sequoia-hope/simple-earring/out/probe/cu_c19.png

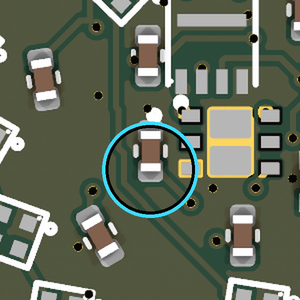
out/probe/cu_c19.png
