sequoia-hope/simple-earring/out/probe/cu_c16.png

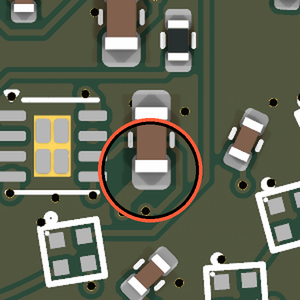
out/probe/cu_c16.png
