sequoia-hope/simple-earring/README.md

# simple_earring

Co-designed LED earring: a Ø30.5 mm teardrop, 4-layer board with an RP2350A and external QSPI
flash in the middle and 45 RGB LEDs on two rings round it (37 on the outer ring, 8 inside). It runs
from a small LiPo cell (LPR302823) on the back and charges over USB-C. One button does both power
(a soft latch) and BOOTSEL. There is also an IMU, an ambient light sensor and a generated TPU clip-on
case. JLCPCB rules, all parts from LCSC.

The current board (rev 3, variant A) uses 45 WS2816C-1313 addressable pixels split into three
switched zones. Variants B–F study a cheaper build that drives plain RGB LEDs (XL-1615) from a
matrix driver (AW20198QNR), about $3 less per board. It routes on 6 layers; 4 layers is down to a few
open connections.

**Project page: <https://sequoia-hope.github.io/simple-earring/>**: every design variant (A, the
routed WS2816C board, and the B–F matrix-driver study) with board previews, a comparison table, the
interactive viewer (schematic, PCB layers, 3D) and the design notes. It is the local dashboard
(`proj up simple_earring`), published with `scripts/publish_pages.py --push`.

The design is *generated*: edit `design.yaml` (shape, LED count, sizes) and
`scripts/circuit.py` (netlist), then rebuild.

**Status:** rev 1 (SK6805-EC10 LEDs, 2032 coin cell) was ordered, assembled and works. It lives in a
separate worktree at `~/pcb/simple_earring_shipped` (commit `43eadc1`). This tree is rev 3: variant A
is routed with ultraroute to 0 DRC errors / 0 unconnected and has passed gate 7. The matrix variants
are placed; the 4- or 6-layer decision for them is open. See `docs/PLAN.md` for the plan of record
and the project page's feed for the narrative.

## Pipeline

```
python3 build.py                # full: board -> place -> route -> drc -> render -> export
python3 build.py --to place     # stop after a stage (board|place|route|drc|render|export)
```

Stages (each is also runnable standalone from `scripts/`):

| stage  | script | what it does |
|---|---|---|
| board  | `gen_board.py` | netlist from `circuit.py` -> fresh 4-layer .kicad_pcb, outline, nets |
| place  | `place.py` | LED ring, MCU cluster front, holder back, USB at edge |
| route  | `route.py` | locked pre-routes + pours, then ultraroute for the rest, zone fills |
| drc | `drc.py` | kicad-cli DRC, parsed pass/fail report |
| render | `render.py` | renders, layer PNGs, GLB, and the `out/` dashboard  |
| export | `export.py` | JLCPCB gerbers/drill + BOM/CPL from LCSC numbers |

The KiCad project is `hw/earring/a/earring.kicad_*` (the Boardroom suite's
`hw/<board>/<variant>/` layout; `scripts/paths.py` owns the locations). Build products
land in `out/` (renders, dashboard, `drc.json`, `production/`, `jlcpcb/`).

The dashboard's design gallery reads `design/variants.toml` (card text) and `pcbview.toml` (the
boards); rebuild the viewer with `scripts/view.sh build pcbview.toml`, rewrite the page with
`python3 scripts/render.py --index-only`, then publish it to GitHub Pages (the `gh-pages` branch)
with `python3 scripts/publish_pages.py --push`.

## Boardroom suite

This is a Boardroom project (`~/Software/easy_pcb`): `design/status.json` is its
headline state, `.claude/skills/pcb-design/` the vendored skill, `pcbview.toml` the
viewer config. `compose/earring/` is Circuit Composer's view of the circuit
(generated by `scripts/export_compose.py`, build stage `compose`), and
`route/earring/recipe.json` is the ultraroute recipe behind the installed route.
Routing is ultraroute: the `route` stage runs the pinned `vendor/ultraroute`
(`git submodule update --init`; `scripts/route.sh` builds it, needs Rust) with that recipe.
Alongside the board pipeline: `gen_schematic.py` (readable schematic + PDF),
`gen_case.py` (TPU case STLs/STEP), `firmware/` (PlatformIO, arduino-pico), and
`tools/` (bench instruments — charge monitor, placement spot scanner).

## Dashboard

```
cd out && python3 -m http.server 8618 --bind 0.0.0.0
```

`out/index.html` is a reverse-chronological update feed over the live build
outputs: renders, the copper-layer stack viewer, the 3D board, the schematic,
the case preview and the bench pages. It is **generated by `scripts/render.py`**
(the `FEED` list at the top of that file) — hand edits to the served page are
wiped by the next build. `python3 scripts/render.py --index-only` rewrites just
the page.

## Sources of truth

- `design.yaml` — geometry + rules parameters
- `scripts/circuit.py` — components and nets (references `bom/parts.yaml`)
- `bom/parts.yaml` — every part with LCSC number + footprint
- `library/parts.pretty/` — local footprints (proven ones lifted from prior boards)
- `docs/PLAN.md` — plan of record: current state, open work, hard-won constraints

## Provenance

Footprints and circuit patterns reuse the proven `earring` (RP2040 + LGS4056H + USB-C)
and `rp2350-pendant` (RP2350 QFN-60, 1010 LED ring) projects.
