sequoia-hope/simple-earring/design/ultraroute-requests.md

# ultraroute change requests

Router problems found on this board, for the ultraroute project to fix. Per the skill's
LESSONS, the fix belongs in the router, not in a workaround script here.

## 1. Overlap-only track joints (2026-10-31, gate 7)

**Seen in:** ultraroute 8c691ec (lab), `~/Software/ultraroute-lab/experiments/vled-width-1/s0`.
The pinned `vendor/ultraroute` 0330831 is not yet checked.

**What:** the output has 81 joints where two tracks of a net don't share an endpoint. Their
ends sit 0.05–0.28 mm apart (often exactly one 0.1 mm grid step diagonally: 0.141 mm), and
the copper connects only where the round ends overlap. The input board has none:

    tools/route_audit/necks.py …/s0/input.kicad_pcb   -> 0 overlap-only joints
    tools/route_audit/necks.py …/s0/out.kicad_pcb     -> 81 overlap-only joints

KiCad counts these as connected, and the default DRC passes them. With a `connection_width
(min 0.09mm)` rule, KiCad reports necks down to 0.051 mm. Two are the only battery path
(VBATT In2 at (98.68,88.08) and (107.3,108.35)) and one is CHRG's only path (F.Cu at
(101.33,110.83)).

**Ask:** every track joint the router writes should be a shared endpoint (or a T onto a
segment's centreline), never an end-cap overlap. A self-check before writing would help:
no joint narrower than the net's width rule.

**Status (2026-11-01):** still present: the installed board still has 81. Not fixed on
ultraroute origin/main as of cc6be09 (b5f9f2d's 0.5 µm reach-in rule still accepts these
joints). Sent to the ultraroute session (ultraroute-e8), along with a second ask: fail the run when
any joint is narrower than the net's width rule, so this can't be reported as success again.

**Fixed** in ultraroute 0b9016f (2026-11-01) for track-to-track joints. Re-routed here: VBATT
and CHRG are clean.

## 2. Track-to-pad joints narrower than the fab minimum (2026-11-01, gate 7 re-route)

**Seen in:** pinned 0b9016f, build route stage. KiCad `connection_width (min 0.09mm)`:
- U8.5 3V3 B.Cu: 0.066 mm. The pad's only track ends just outside it at (103.675,93.162).
- U6.5 3V3 B.Cu: 0.053 mm. A track end at (109.65,88.55), ~0.08 mm off the pad's edge.
- U6.2 3V3 B.Cu: 0.043 mm, from a 0.02 mm track at (107.84,89.13–89.15).

**Ask:** a track that ends on a pad ends inside the pad's copper, so the joint is at least the
track's width (or the net's minimum). Report any narrower pad joint, as 0b9016f does for track
joints. Sent to the ultraroute session 2026-11-01.

**Fixed** in ultraroute 5064384 (2026-11-01). Re-routed here: no pad joint under 0.09 mm.

## 3. Via hole-clearance margin, and touching same-net via pairs (2026-11-02)

**Seen in:** pinned 5064384, build route stage, with the new `.kicad_dru` rule "No via hole in
SMD pad" (`physical_hole_clearance (min 0.1mm)` between vias and SMD pads). 0 via holes touch
SMD pads (124 before) and 0 unconnected, but KiCad reports:
- hole_clearance **0.0995 mm**, 0.5 µm short: the GND via at (94.4,96.28) against Q5.2.
- connection_width **0.029 mm** (B.Cu and In1.Cu): VLED_C vias at (93.43,108.38) and
  (93.78,108.58), 0.403 mm apart, whose 0.4 mm lands only just touch.

**Ask:** keep a margin on rule checks (or round toward legal). Same-net vias should either
clear each other or join at least the net's width, and preferably not be doubled. Sent to the
ultraroute session 2026-11-02.

**Fixed** on ultraroute main: hole clearance in 4ed8d5d, touching vias in fe903ff. But see #4:
the fe903ff route has new failures, so we stay pinned to 5064384.

## 4. fe903ff routes this board worse than 5064384 (2026-11-02)

**Seen in:** fe903ff, with the same recipe and the same route.py input as the 1f12b22 route.
- At `--timeout 240`, it hit the deadline in shove/nudge. 4 unconnected: BTN_SENSE (U1-33) and
  LIGHT (U1-40), plus the gnd sliver islands. Shove pass 1 ran from 51 s to 211 s; on 5064384
  the whole route took ~150 s.
- At `--timeout 480`, it still hit the deadline, with 3 unconnected.
- New track_width error: a VBUS B.Cu track 0.09 mm wide, 0.667 mm long, into J1-A4B9, where
  the floor is 0.2 mm ("narrowed ... no way at its own"). On 5064384 this net routed at the
  full width.
- negotiated: 235 of 249 connections, against 239 of 248 on 5064384. The router sees one more
  connection.

The touching-via and hole-clearance errors are gone on fe903ff.

**Ask:** bisect 5064384..fe903ff on this board. The input is copied to
`~/Software/ultraroute-lab/repro/earring-fe903ff/`. Also noted: `add_block.py` lists the block's
zones in a different order from run to run. Sent to the ultraroute session 2026-11-02; they are
bisecting.

**Bisect (ultraroute, 2026-11-02):**
- The unconnected nets start at 4ed8d5d, which made hole clearance exact. 5064384 had passed
  1–2 hole_clearance errors on every seed. Seed 0 is unlucky: seeds 1–3 reach 0 unconnected.
- The 0.09 mm VBUS neck was a router bug. When the write stage mended a pad joint, it applied our
  board-wide 0.09 connection_width rule in place of the net's 0.2 floor. Fixed on
  fix/joint-floor 20062d9, not yet merged.
- With that fix, seed 1 gave 0 errors apart from our gnd sliver.
- The zone-order variation was in route.py: KiCad UUIDs weren't seeded. Fixed here in eee01cd.
  Seeded input sent as `repro/earring-seeded/` for a seed sweep.

**Fixed** in ultraroute 99bb7ca (joint floor) on 2026-11-02. On the seeded input, ultraroute
swept seeds 0–3; seed 1 was the cleanest. Re-routed here on 99bb7ca with seed 1: 0 unconnected,
no VBUS neck, 1 DRC error, which is our gnd_front fill sliver.
