sequoia-hope/simple-earring/design/gates/phase0.md

# Gate 0 — design intent

- [x] `design/intent.md` written. Every requirement has a number or an explicit "don't care".
- [x] **User sign-off: 2026-10-22**, via AskUserQuestion: "Approved — proceed". Cell LPR302823, solder pads, replace on main, R8 18k.
- Post-sign-off correction (same day): the coin-cell stack is ~3.8 mm, not 5.3. Recorded in intent.md, and the brief carries the height trade-off back to the user.
- Independent review: not run separately. The stronger-model brief review (gate 4) receives intent.md too.
