sequoia-hope/simple-earring/design/datasheets/sources.csv

file | source
is31fl3741a.pdf | C2940604
xl-1010rgb-yg.pdf | C965834
aw20198qnr.pdf | C5137654
xl-1615rgbc-rf.pdf | C965840
