sequoia-hope/simple-earring/design/renders/3d-bottom.png

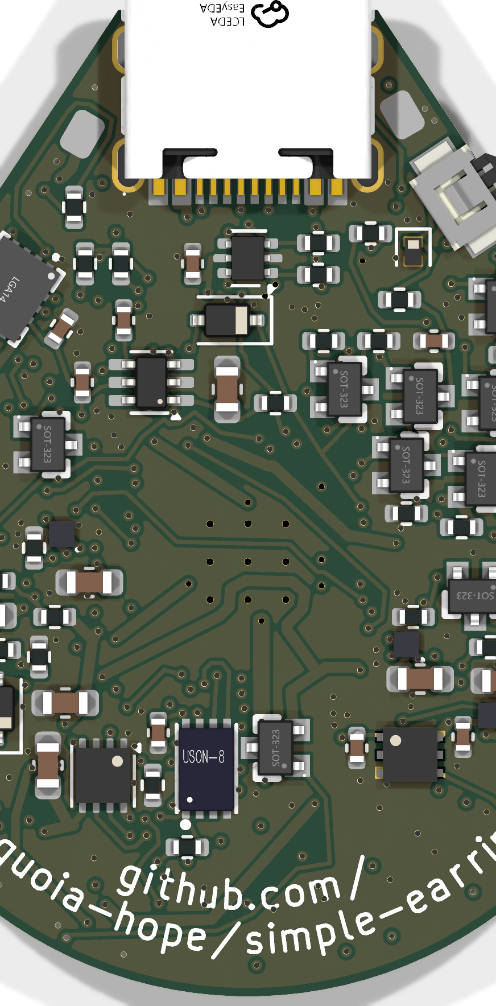
design/renders/3d-bottom.png
