sequoia-hope/simple-earring/design/renders/3d-top.png

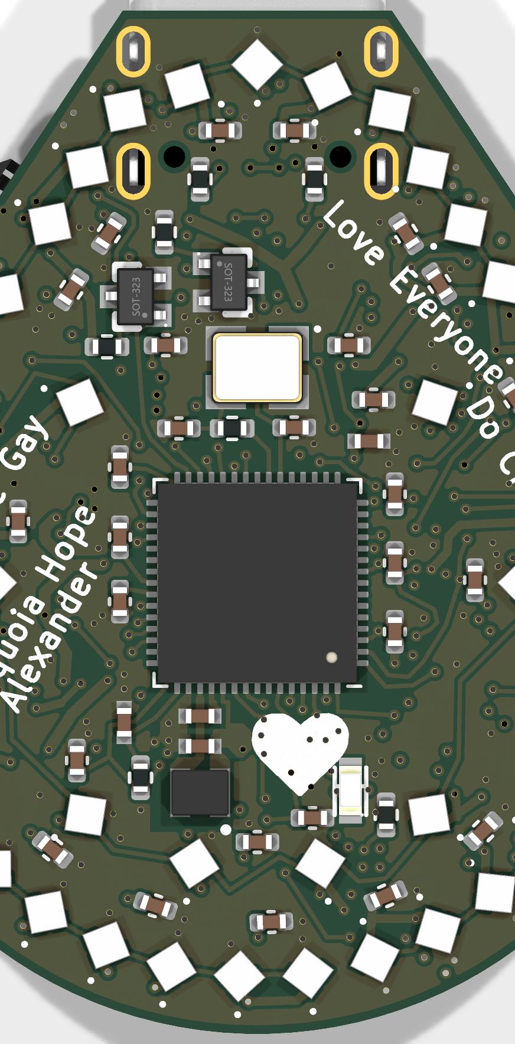
design/renders/3d-top.png
