sequoia-hope/simple-earring/design/renders/B.Cu.png

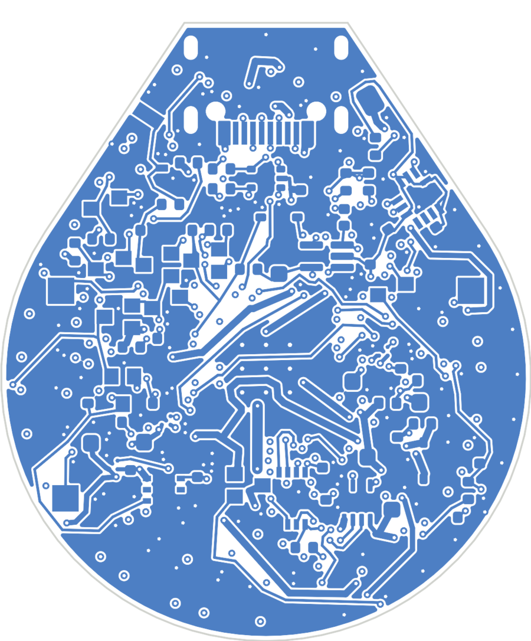
design/renders/B.Cu.png
