sequoia-hope/simple-earring/design/renders/bottom.png

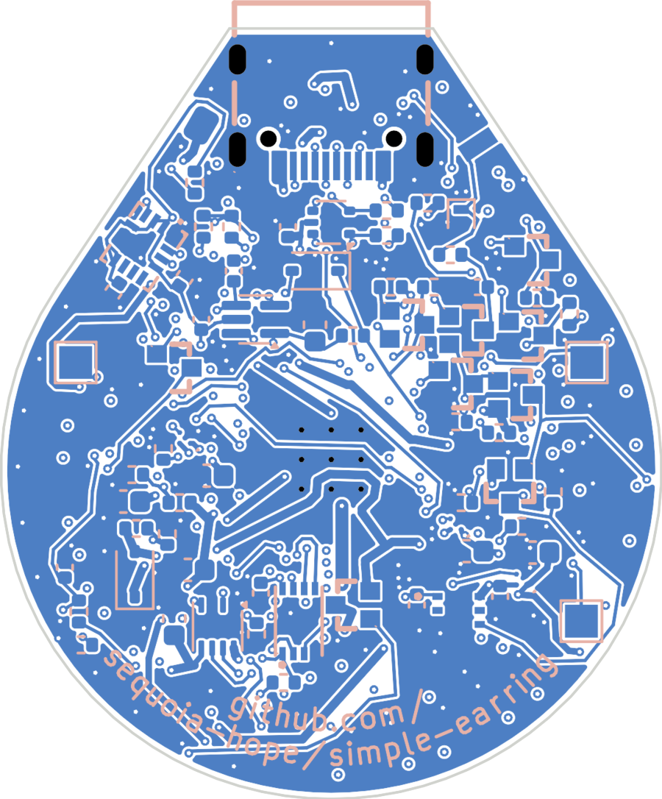
design/renders/bottom.png
