sequoia-hope/simple-earring/design/renders/F.Cu.png

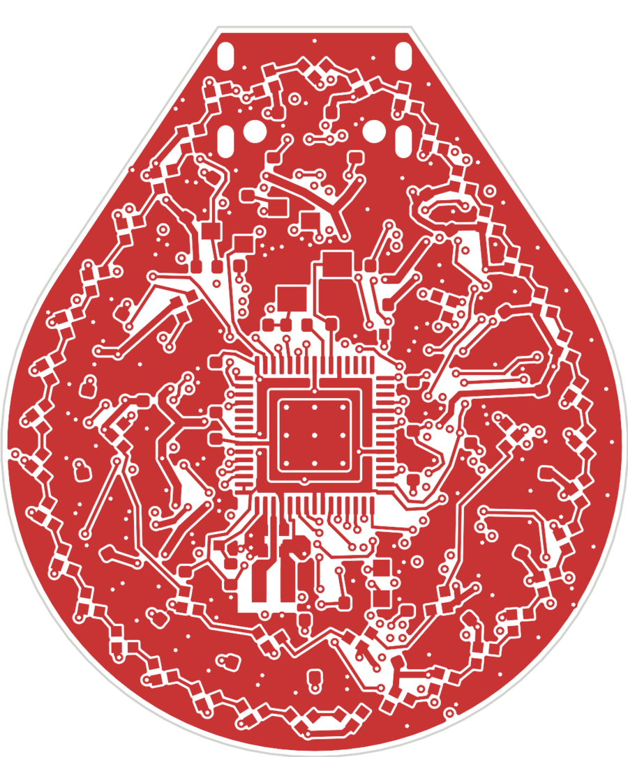
design/renders/F.Cu.png
