sequoia-hope/simple-earring/design/renders/In1.Cu.png

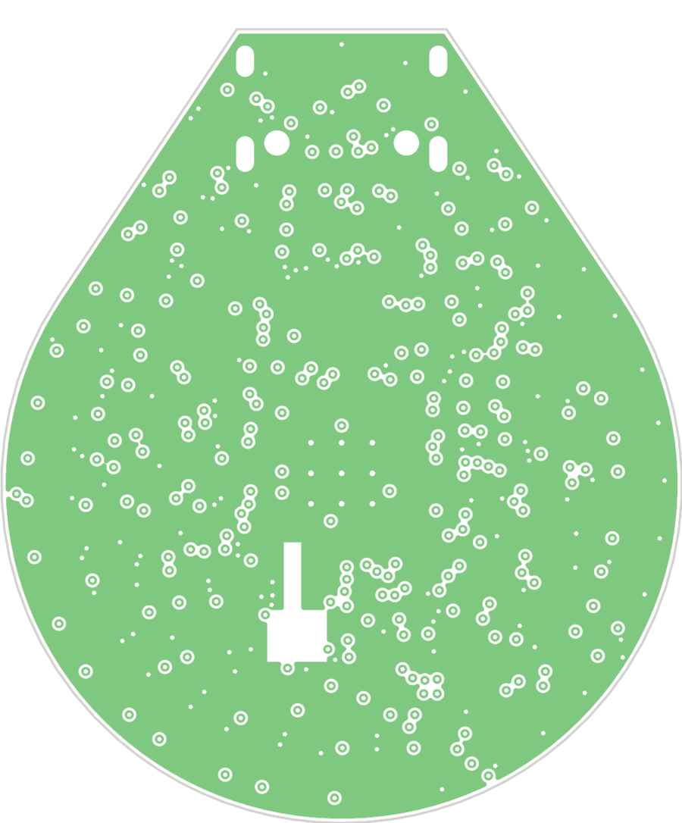
design/renders/In1.Cu.png
