sequoia-hope/simple-earring/design/renders/In2.Cu.png

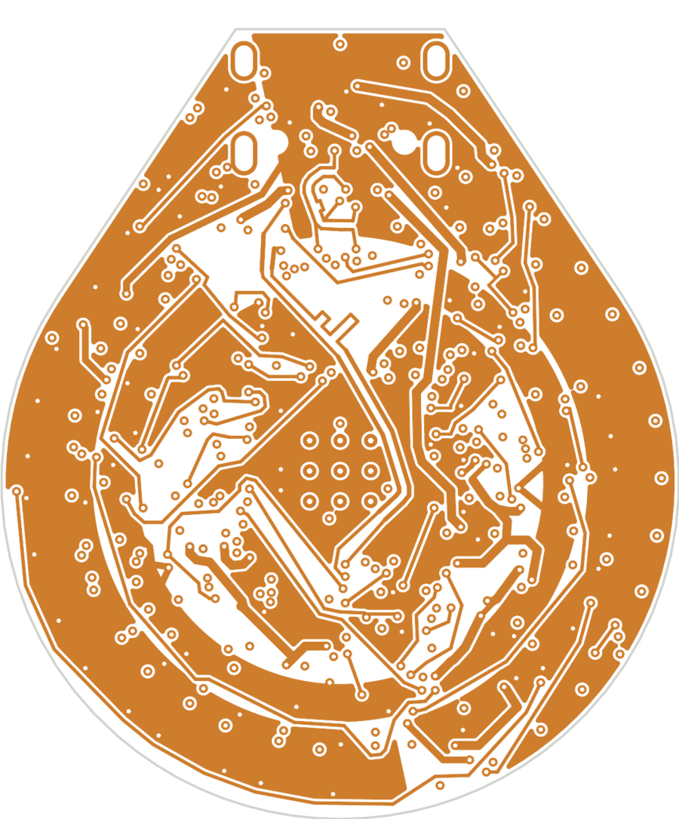
design/renders/In2.Cu.png
