sequoia-hope/simple-earring/design/renders/top.png

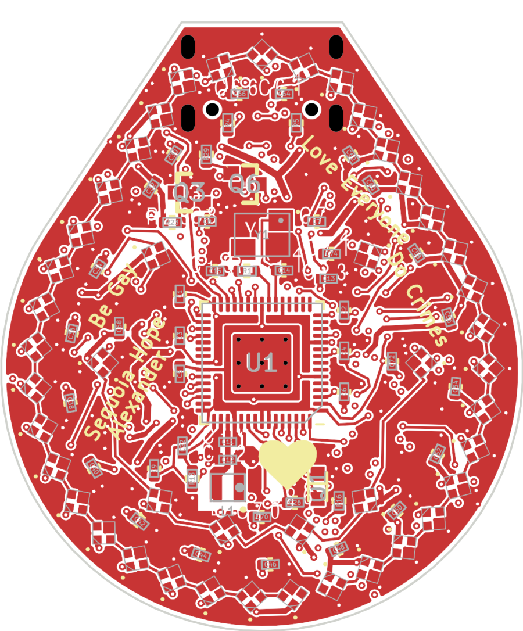
design/renders/top.png
