sequoia-hope/simple-earring/out/probe/board_back.png

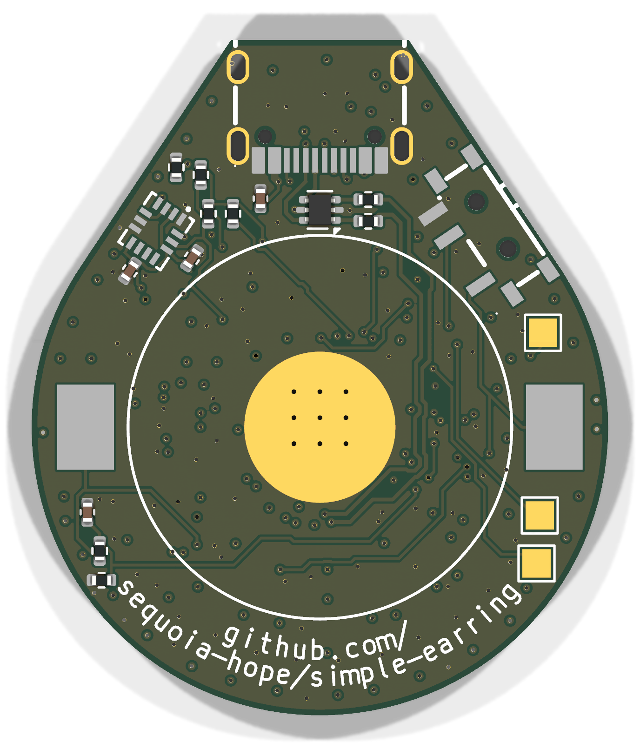
out/probe/board_back.png
