sequoia-hope/simple-earring/out/probe/cu_c17.png

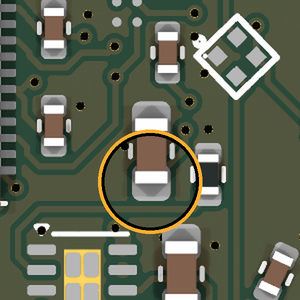
out/probe/cu_c17.png
