sequoia-hope/simple-earring/out/probe/cu_l1.png

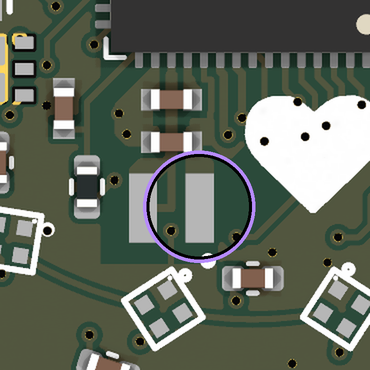
out/probe/cu_l1.png
