sequoia-hope/simple-earring/out/probe/cu_usb.png

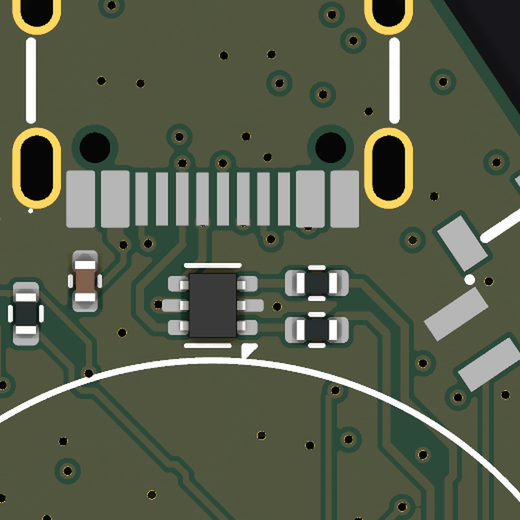
out/probe/cu_usb.png
