sequoia-hope/simple-earring/design/parts/aw20198qnr.md

# U11: Awinic AW20198QNR 18 × 11 matrix LED driver (variant C)

**Datasheet:** `design/datasheets/aw20198qnr.pdf` (Awinic, V1.3 Oct 2020, 40 pages; copied from round-pendant, LCSC
C5137654). Read: pp. 1–3 (features, application circuit, pinout), 6–8 (abs max, electrical), 10–12 (modes, I²C,
addresses), 15–21 (detection, LED map, scan timing, duty and current formula, de-ghost), 24–25 (GCR, DGCR), 35
(application and layout), 37–38 (package, land pattern). Pages 2, 37 and 38 were also read as images.
**MPN:** AW20198QNR
**Supplier:** `C5137654 AW20198QNR (AWINIC(Shanghai Awinic Tech), QFN-40L(5x5)): extended, JLC stock 6055, lifecycle normal, checked 2026-11-05`
(~$0.78–0.89 at 10+, per round-pendant's 2026-11-05 cost run. That's ~$2.4 less than the IS31FL3741A's $3.31.)
**Why this part:** the user's call (2026-11-05). It's round-pendant's driver for its low-density parallelogram boards
(`~/pcb/round-pendant/design/parts/drivers-aw20198.md`). There `p1-66` routed 100 % on 4 layers with one of these.
**Footprint:** `library/parts.pretty/QFN-40-1EP_5x5mm_P0.4mm_EP3.4x3.4mm`, written from p.38. It is not round-pendant's,
whose pads were 0.60 mm long.
- 40 × 0.50 × 0.20 mm pads at 0.40 mm pitch, 5.20 mm outer span (centres ±2.35), so 0.20 mm between pads.
- Pad 41 is a solid 3.40 mm exposed pad (GND), with a 2 × 2 paste grid of 1.3 mm windows (58 %).
- The package is 5.00 ± 0.10 × 0.55 ± 0.05 mm (p.37), so 0.40 mm EP-to-pad gaps on the land.
- Pin 1 at the top-left of the west row, counter-clockwise (p.2 top view). This matches `circuit.py` AW_SW_PIN / AW_CS_PIN.

## Pin map (p.2–3), and how variant C uses it

| Pins | Name | Net |
|---|---|---|
| 1–4, 6–10 | SW8, SW6, SW4, SW2 / SW1, SW3, SW5, SW7, SW9 | SW1–SW9 (the ring bus) |
| 11, 40 | SW11, SW10 | NC (SWSEL scans SW1–9 only) |
| 5 | PVCC | VSYS |
| 22 | VCC | VSYS (ds note 2: PVCC and VCC on the same supply) |
| 39–31 | CS1–CS9 | CS1–CS9 |
| 21–17, 15 | CS10–CS14, CS15 | CS10–CS15 |
| 14, 13, 12 | CS16–CS18 | NC (growth: one more 3-LED triplet each per SW) |
| 16, 23, 41 | PGND, GND, EP | GND |
| 24, 25 | AD1, AD0 | GND → address **0x20** (p.12) |
| 26 | EN | DRV_EN, GPIO18; 100 nF to GND |
| 27, 28 | SCL, SDA | DRV_SCL GPIO17, DRV_SDA GPIO16 (I²C0) |
| 29 | ISET | R35 to GND |
| 30 | SYNC | NC (1 MΩ internal pull-down, p.3) |

There is no INTB pin, so GPIO1 (LED_EN_L in variant A) comes free. That leaves three spare GPIOs in all.

## Absolute max vs our worst case (p.6–7)

| Parameter | Abs max / rating | Our worst case | Margin |
|---|---|---|---|
| VCC, PVCC | −0.3…6 V (op 2.7–5.5 V) | VSYS ≤ 4.95 V on USB (VBUS − D3), 3.0–4.2 V on the cell | OK |
| SCL, SDA, EN, AD0/1 | −0.3…VCC | 3V3 comes from an LDO fed by VSYS, so it's always ≤ VSYS | OK by construction |
| CS1–18 | −0.3…VCC; SW −0.3…PVCC | Both supplies are VSYS | OK |
| ISET | −0.3…2 V | Internal | OK |
| Sink current | IMAX 40 mA at REXT 10 k | 8.51 mA (REXT 47 k) | 4.7× |
| Switch current | 720 mA at 10 k (SDCR 000) | 15 CS × 8.51 = 128 mA per SW slot | 5.6× |
| Junction temp | 160 °C max; TSD 165 °C | See thermal, below | OK |

## Current setting, R35 = 47 kΩ 1 % (C25792, basic, already on the BOM for B)

The current formula is ILED = (400 V / REXT) × (GCC/255) × (SL/255) × (PWM/256) × DUTY (p.18).

- **Peak:** Imax = 400 / 47 k = **8.51 mA** per die. That's B's 8.09 mA, within 5 %, so the firmware's levels carry over.
- **Duty:** SWSEL = 1000 scans SW1–SW9 (p.24 GCR). Each slot is 0.25 + 5 × 0.125 + 16 + 0.125 + 1 = 18.0 µs, with 15.94 µs
  of PWM. So DUTY = 15.94 / 18.0 / 9 = **0.0984**. That checks against p.18's own 11-SW example, 0.0805.
- **Average at full scale:** 8.51 × 0.0984 = **0.837 mA** per die.
- **Full white, hardware cap:** 135 dies × 0.837 = **113 mA**, or ~128 mA with the rest of the system. That's under the
  cell's 140 mA, even with a firmware bug. It's B's argument for 47 k, and it still holds.
- **The red trade-off.** The XL-1615's red is weak at low current (see `xl-1615rgbc.md`). So **dim with PWM and keep SL
  and GCC high**: the instantaneous current then stays near 8.5 mA, where red still works. Dimming with GCC or SL instead
  lowers the instantaneous current itself.
  - A lower REXT would buy red headroom: 39 k gives 10.3 mA peak and 136 mA full white. That is over the cell's budget once
    the MCU is counted, so this audit keeps 47 k. The user can trade this.
- **Recommended config:** p.16 gives GCC 0x05–0x80 and PWM ≥ 0x20 at PVCC 4.2 V. That is for open/short detection
  accuracy only, not a limit.

## Headroom (LED lights only if VSYS ≥ VF + VHR_SW + VHR_CS)

- **Headroom ratings:** VHR_CS is 300 mV at 40 mA and VHR_SW is 750 mV at 720 mA (p.7). At 8.5 mA and 128 mA they scale
  to roughly 0.07 V and 0.13 V.
- **VF:** green and blue are ~2.75 V at 8.5 mA (XL-1615 p.6 curve), with the 3.4 V max bin at 20 mA.
- **Floor:** a straight scaling gives G/B a floor of VSYS ≥ ~2.95 V. The review (m1) points out that sink compliance does
  not scale linearly: the real floor is ≈ 3.05 V typical, and 3.25–3.4 V for top-VF bins. So the **firmware's
  low-battery colour floor should be ≥ 3.3 V**. The SW bus's IR drop eats into this too, which makes it a gate 7 check.

## Supply and power

- **Quiescent:** **1.8 mA** active with all LEDs off (p.7), against the IS31FL3741A's 3.6 mA. That's ~1.8 mA off every
  awake mode in variant B's battery table.
- **Standby:** 1.3 µA with EN low or CHIPEN = 0, registers kept. The 1 MΩ EN pull-down holds it there when the MCU is
  off. VSYS is not cut by the soft latch, so this is the earring's "off" draw from this part: >10 years from 140 mAh.
  The IS31 needed an external 100 k pull-down (R36). This one doesn't, so R36 is gone.
- **Low-power mode:** MIXCR.LPEN = 1 drops into low-power mode automatically whenever every PWM is 0 (p.10–11). Firmware
  should set it.
- **Thermal, worst case:** full white on USB, VSYS 4.95 V.
  - Dissipation is 0.837 mA × (45 × (4.95 − 1.95) + 90 × (4.95 − 2.75)) = 279 mW, plus 9 mW quiescent.
  - At θJA 33 °C/W that is **+9.5 °C**. The board is smaller than JEDEC's, so call it +20 °C. Fine.

## Required external parts (Figure 1, p.2; p.35)

| Ref | Part | Where (place.py MATRIX_AW, back) | Datasheet |
|---|---|---|---|
| C81 / C80 | 100 nF / 1 µF on PVCC | West of pin 5, 1.15 / 2.3 mm | C2 / C1 |
| C83 / C82 | 100 nF / 1 µF on VCC | East of pin 22, 1.15 / 2.1 mm | C4 / C3 |
| C86 | 10 µF 0603 bulk on VSYS | South of the chip | (extra, as B). Review m4: it derates to ~5 µF against 128 mA, 16 µs slot pulses; 22 µF 0805 would be better. Open: needs a sourced part and a spot |
| R35 | 47 kΩ REXT | East of pin 29, 1.15 mm | R3 (10 k in the figure) |
| C87 | 100 nF on EN | East of pin 26 | C5 (1 µF in the figure; 100 n is plenty against a push-pull GPIO) |
| R38 / R39 | 4.7 kΩ I²C pull-ups to 3V3 | East | R1/R2: p.11 recommends 4.7 k for 400 kHz, 1 k for 1 MHz |

- **No series LED resistors (RLED).** The figure's RLED only moves heat out of the chip at 5 V and 40 mA. At 8.5 mA it
  has no job.
- **Layout (p.35):** caps and REXT as close as possible. The EP needs as many thermal vias as possible. That is a gate 7
  item, as in B, and via-in-pad is the user's call.

## De-ghost and LED reverse voltage (p.20–21)

- **How it works:** the CS pull-ups (0.5–32 kΩ) and SW pull-downs (0.25–16 kΩ) are selected in DGCR. They act during the
  off/blanking time.
  With the default PUMD = PDMD = 0 they act only then.
- **Reverse bias:** an unlit LED can see up to ~VSYS reverse: 4.95 V on USB against the XL-1615's 5 V VR. That's inside
  the rating but thin, and limited to µA-level current by the pull resistors. The same holds for the IS31 in B.
- **Firmware:** CSPUR = 000 (CS pull-up off) removes the reverse bias entirely. Otherwise, pick the largest DGCR resistances
  that still kill ghosting.
- **Actual USB VSYS:** D3 is a 1N4007WS silicon diode, so the real figure is below the 4.95 V assumed here. That figure is
  kept as the worst case.

## Firmware notes (review, 2026-11-05)

- **Start-up:** wait 2 ms after power-on and 100 µs after EN before the first I²C write. UVLO and over-temperature both
  clear CHIPEN, so re-enable it after either.
- **Logic level:** GCR.LGC = 1 (2.4 / 0.6 V) gives the 3.3 V I/O more noise margin than the default.
- **Audible noise:** the scan-frame current envelope (~6.2 kHz) sits next to the ear and can make MLCCs sing. Enable spread
  spectrum and slew-rate control.
- **Register indexing:** the LED register index runs SWn × 18 + CS. CS16–18 are unused, so the index skips them.

## Open questions

- IMAX accuracy at 47 kΩ: only 10 k and 5 k are characterised.
- The red LED's low-current efficiency (`xl-1615rgbc.md`).
- How many EP vias, and whether via-in-pad is allowed (gate 7).
- Independent review: `design/gates/phase1-variant-c-review.md`, PASS WITH FIXES (2026-11-05). m1–m3 and m5 are folded in
  above. m4 (bulk cap) is open.
