sequoia-hope/simple-earring/out/production/bom.csv

Designator | Footprint | Quantity | Value | LCSC Part #
BT1 | BAT_CR2032_W | 1 | LIR2032 | C70373
C1, C2, C21, C23, C24, C25, C28, C3, C30, C32, C34, C36, C38, C4, C40, C42, C44, C46, C48, C5, C50, C52, C54, C56, C58, C6, C60, C62, C64, C66, C68, C7, C70, C72, C74, C8, C9 | 0402 | 37 | 100n | C1525
C11, C12, C13, C22 | 0402 | 4 | 4.7u | C23733
C14, C15 | 0402 | 2 | 15p | C1548
C16, C17, C20 | 0603 | 3 | 10u | C19702
C18, C19 | 0402 | 2 | 1u | C52923
J1 | USB-C_SMD-TYPE-C-31-M-12_1 | 1 | USB-C | C165948
L1 | L_pol_2016 | 1 | 3.3uH | C42411119
LED1, LED10, LED11, LED12, LED13, LED14, LED15, LED16, LED17, LED18, LED19, LED2, LED20, LED21, LED22, LED23, LED24, LED25, LED26, LED27, LED28, LED29, LED3, LED30, LED31, LED32, LED33, LED34, LED35, LED36, LED37, LED38, LED39, LED4, LED40, LED41, LED42, LED43, LED44, LED45, LED5, LED6, LED7, LED8, LED9 | LED_SK6805-EC10 | 45 | SK6805-EC10 | C22394946
R1, R3 | 0402 | 2 | 1k | C11702
R10, R2 | 0402 | 2 | 10k | C25744
R11, R12 | 0402 | 2 | 1M | C26083
R13 | 0402 | 1 | 33 | C25105
R14, R15 | 0402 | 2 | 4.7k | C105871
R4, R5 | 0402 | 2 | 5.1k | C25905
R6, R7 | 0402 | 2 | 27 | C138021
R8 | 0402 | 1 | 22k | C25768
SW1 | KEY-SMD_4P-L4.2-W3.2-P2.20-LS4.6 | 1 | BOOTSEL | C19724063
SW2 | SW-TH_MSK12C02 | 1 | PWR | C431540
U1 | RP2350-QFN-60-1EP_7x7_P0.4mm_EP3.4x3.4mm_ThermalVias | 1 | RP2350A | C42411118
U2 | DFN-8-1EP_2x2mm_P0.5mm_EP0.9x1.5mm | 1 | LGS4056H | C5124109
U3 | WDFN-6-2x2 | 1 | NCP730-3.3 | C892821
U4 | YZV0004ADAD | 1 | TPS22913 | C544698
U5 | SOT-666 | 1 | USBLC6-2P6 | C2827693
U6 | LGA-14_L3.0-W2.5-P0.50-TL | 1 | LSM6DS3TR-C | C967633
U7 | USON-8_L3.0-W2.0-P0.50-BL-EP | 1 | W25Q16JVUXIQ | C2843335
Y1 | Crystal_SMD_3225-4Pin_3.2x2.5mm_ABM8 | 1 | 12MHz | C20625731
