sequoia-hope/simple-earring/design/renders/assembly-top.pdf

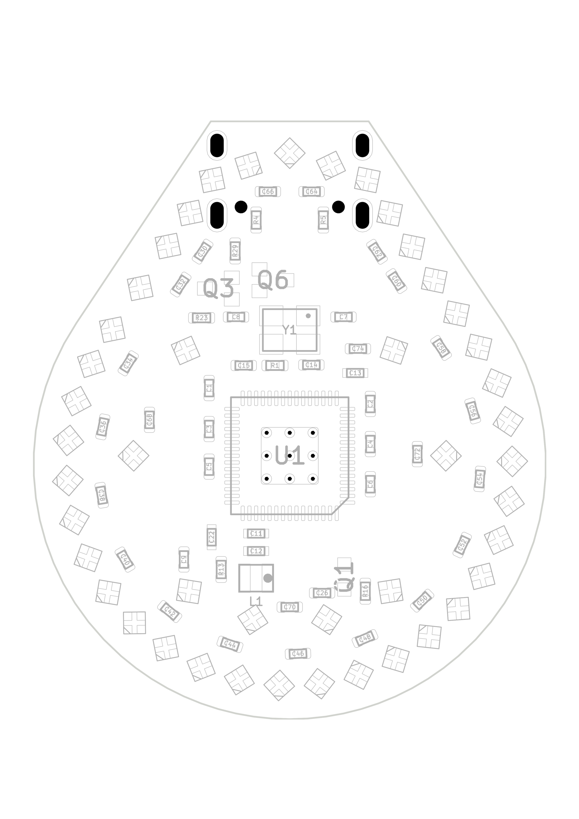
[picture p15: page 1]
