sequoia-hope/simple-earring/design/renders/assembly-top.png

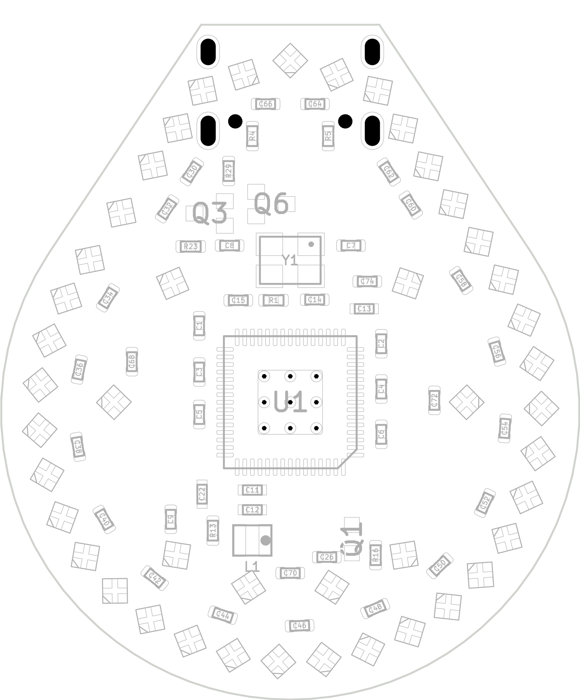
design/renders/assembly-top.png
