sequoia-hope/simple-earring/out/earring-schematic.pdf

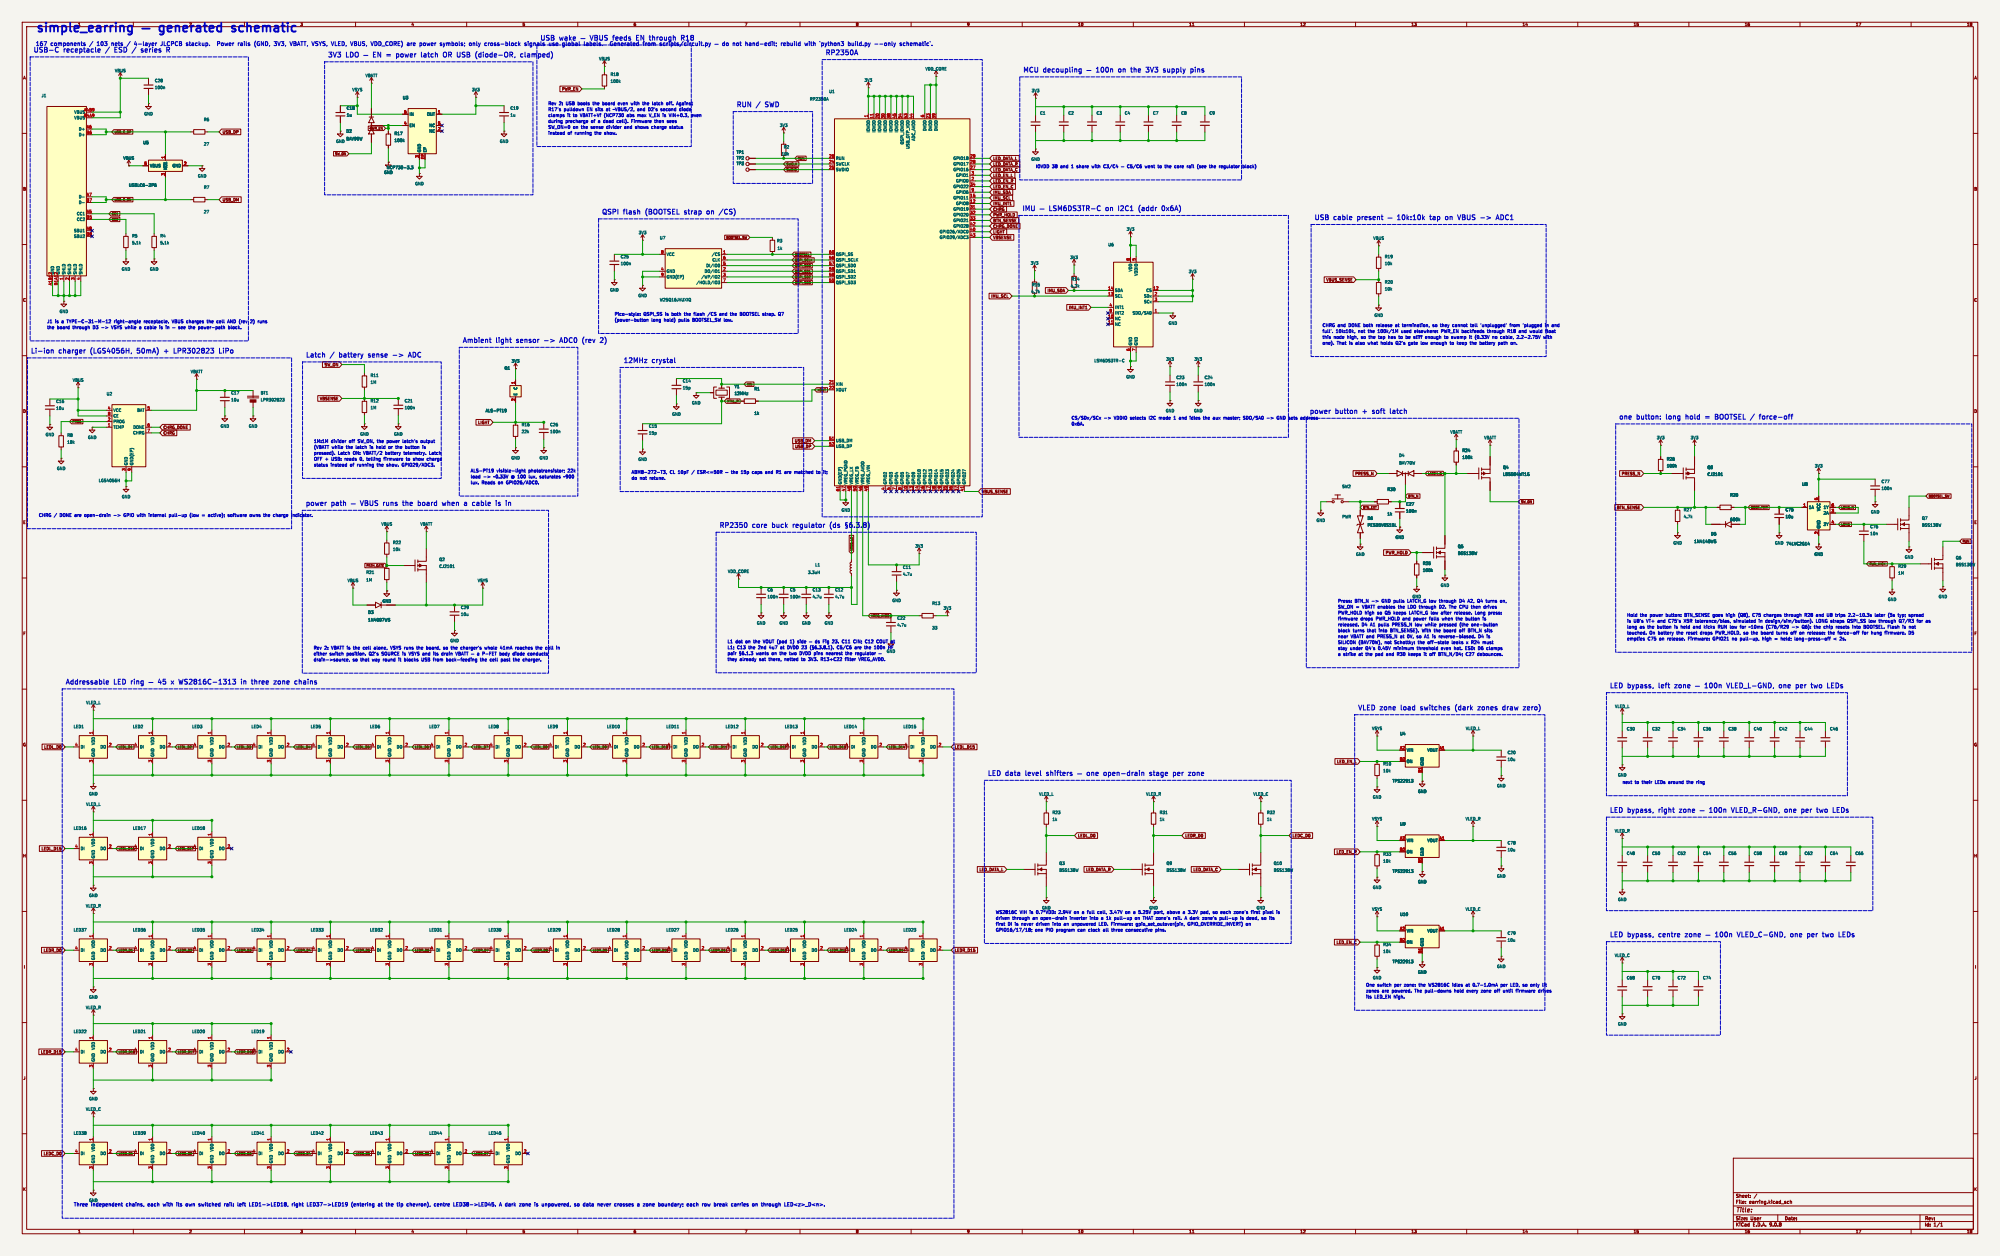
[picture p17: page 1]

USB wake þÿ VBUS feeds EN through R18

MCU decoupling þÿ 100n on the 3V3 supply pins

3 EP EP OUT 1 NC 5 NC 2 U3 NCP730-3.3 VBUS

Rev 2: USB boots the board even with the latch off. Against

3 EP EP OUT 1 NC 5 NC 2 GND
1u GND

instead of running the show.

QSPI flash (BOOTSEL strap on /CS)

1k VCC 8 GND 4 GND(EP) 9

one). That is also what holds Q2's gate low enough to keep the battery path on.

3 GND(EP) 9 BAT 5 DONE 6 CHRG 7 U2

status instead of running the show. GPIO29/ADC3. power path þÿ VBUS runs the board when a cable is in

L1 dot on the VOUT (pad 1) side þÿ ds Fig 23. C11 CIN; C12 COUT at L1; C13 the 2nd 4u7 at DVDD 23 þÿ(§6.3.8.1). C5/C6 are the 100n HF

LED bypass, right zone þÿ 100n VLED_R-GND, one per two LEDs

Id: 1/1 Title: File: earring.kicad_sch Sheet: /
