sequoia-hope/simple-earring/hw/earring/b/earring.kicad_pcb

## KiCad design hw/earring/b/earring.kicad_pcb (2026-11-06)

Schematic: earring.kicad_sch

Parts:
BT1: LPR302823; BAT_LPR302823_PADS
C1, C2, C3, C4, C5, C6, C7, C8, C9, C21, C23, C24, C25, C26, C27, C28, C77, C81, C83, C85, C87: 100n; C_0402_1005Metric
C11, C12, C13, C22: 4.7u; C_0402_1005Metric_small_pads
C14, C15: 15p; C_0402_1005Metric
C16, C17, C29, C75, C86: 10u; C_0603_1608Metric
C18, C19, C80, C82, C84: 1u; C_0402_1005Metric
C76: 10n; C_0402_1005Metric
D2: BAV99W; SOT-323_BAT54SW
D3: 1N4007WS; D_SOD-323
D4: BAV70W; SOT-323_BAT54SW
D5: 1N4148WS; D_SOD-323
D6: PESD5V0S1BL; D_SOD-882
J1: USB-C; USB-C_SMD-TYPE-C-31-M-12_1
L1: 3.3uH; L_pol_2016
LED1, LED2, LED3, LED4, LED5, LED6, LED7, LED8, LED9, LED10, LED11, LED12, LED13, LED14, LED15, LED16, LED17, LED18, LED19, LED20, LED21, LED22, LED23, LED24, LED25, LED26, LED27, LED28, LED29, LED30, LED31, LED32, LED33, LED34, LED35, LED36, LED37, LED38, LED39, LED40, LED41, LED42, LED43, LED44, LED45: XL-1010RGB; LED_XL-1010RGB
Q1: ALS-PT19; SENSOR_ALS-PT19
Q2, Q8: CJ2101; SOT-323_MOSFET
Q4: LBSS84WT1G; SOT-323_MOSFET
Q5, Q6, Q7: BSS138W; SOT-323_MOSFET
R1, R3, R30: 1k; R_0402_1005Metric
R2, R19, R20, R22: 10k; R_0402_1005Metric
R4, R5: 5.1k; R_0402_1005Metric
R6, R7: 27; R_0402_1005Metric
R8: 18k; R_0402_1005Metric
R11, R12, R21, R29: 1M; R_0402_1005Metric
R13: 33; R_0402_1005Metric
R14, R15, R27, R38, R39: 4.7k; R_0402_1005Metric
R16: 22k; R_0402_1005Metric
R17, R18, R24, R25, R26, R36, R37: 100k; R_0402_1005Metric
R28: 680k; R_0402_1005Metric
R35: 47k; R_0402_1005Metric
SW2: PWR; SW_B3U-3000P
TP1: RUN; TestPoint_Pad_1.5x1.5mm
TP2: SWCLK; TestPoint_Pad_1.5x1.5mm
TP3: SWDIO; TestPoint_Pad_1.5x1.5mm
U1: RP2350A; RP2350-QFN-60-1EP_7x7_P0.4mm_EP3.4x3.4mm_ThermalVias
U2: LGS4056H; DFN-8-1EP_2x2mm_P0.5mm_EP0.9x1.5mm
U3: NCP730-3.3; WDFN-6-2x2
U5: USBLC6-2P6; SOT-666
U6: LSM6DS3TR-C; LGA-14_L3.0-W2.5-P0.50-TL
U7: W25Q16JVUXIQ; USON-8_L3.0-W2.0-P0.50-BL-EP
U8: 74LVC2G14; SOT-363_SC-70-6
U11: IS31FL3741A; QFN-60-1EP_7x7mm_P0.4mm_EP5.4x5.4mm
Y1: 12MHz; Crystal_SMD_3225-4Pin_3.2x2.5mm_ABM8

Connections:
3V3: C1.1, C2.1, C3.1, C4.1, C7.1, C8.1, C9.1, C11.1, C19.1, C23.1, C24.1, C25.1, C77.1, Q1.1 (C), Q8.2 (S), R2.2, R13.1, R14.2, R15.2, R26.1, R37.2, R38.2, R39.2, U1.1 (IOVDD), U1.11 (IOVDD), U1.20 (IOVDD), U1.30 (IOVDD), U1.38 (IOVDD), U1.44 (ADC_AVDD), U1.45 (IOVDD), U1.49 (VREG_VIN), U1.53 (USB_OTP_VDD), U1.54 (QSPI_IOVDD), U3.1 (OUT), U6.2 (SDx), U6.3 (SCx), U6.5 (VDDIO), U6.8 (VDD), U6.12 (CS), U7.8 (VCC), U8.5 (VCC)
BOOTSEL: R3.1, U1.60 (QSPI_SS), U7.1 (/CS)
BOOTSEL_SW: Q7.3 (D), R3.2
BOOT_TMR: C75.1, D5.2 (A), R28.2, U8.1 (1A)
BTN_EXT: D6.1, R30.1, SW2.2
BTN_N: C27.1, D4.3 (K), R30.2
BTN_SENSE: D5.1 (K), Q8.3 (D), R27.1, R28.1, U1.33 (GPIO21)
CC1: J1.A5 (CC1), R4.1
CC2: J1.B5 (CC2), R5.1
CHRG: U1.31 (GPIO19), U2.7 (CHRG)
CHRG_DONE: U1.42 (GPIO28), U2.6 (DONE)
CS1: LED1.1 (R), LED2.1 (R), LED3.1 (R), LED4.1 (R), LED5.1 (R), LED6.1 (R), LED7.1 (R), LED8.1 (R), LED9.1 (R), U11.26 (CS1)
CS2: LED1.2 (G), LED2.2 (G), LED3.2 (G), LED4.2 (G), LED5.2 (G), LED6.2 (G), LED7.2 (G), LED8.2 (G), LED9.2 (G), U11.27 (CS2)
CS3: LED1.4 (B), LED2.4 (B), LED3.4 (B), LED4.4 (B), LED5.4 (B), LED6.4 (B), LED7.4 (B), LED8.4 (B), LED9.4 (B), U11.28 (CS3)
CS4: LED10.1 (R), LED11.1 (R), LED12.1 (R), LED13.1 (R), LED14.1 (R), LED15.1 (R), LED16.1 (R), LED17.1 (R), LED18.1 (R), U11.29 (CS4)
CS5: LED10.2 (G), LED11.2 (G), LED12.2 (G), LED13.2 (G), LED14.2 (G), LED15.2 (G), LED16.2 (G), LED17.2 (G), LED18.2 (G), U11.30 (CS5)
CS6: LED10.4 (B), LED11.4 (B), LED12.4 (B), LED13.4 (B), LED14.4 (B), LED15.4 (B), LED16.4 (B), LED17.4 (B), LED18.4 (B), U11.31 (CS6)
CS7: LED19.1 (R), LED20.1 (R), LED21.1 (R), LED22.1 (R), LED23.1 (R), LED24.1 (R), LED25.1 (R), LED26.1 (R), LED27.1 (R), U11.32 (CS7)
CS8: LED19.2 (G), LED20.2 (G), LED21.2 (G), LED22.2 (G), LED23.2 (G), LED24.2 (G), LED25.2 (G), LED26.2 (G), LED27.2 (G), U11.33 (CS8)
CS9: LED19.4 (B), LED20.4 (B), LED21.4 (B), LED22.4 (B), LED23.4 (B), LED24.4 (B), LED25.4 (B), LED26.4 (B), LED27.4 (B), U11.34 (CS9)
CS10: LED28.1 (R), LED29.1 (R), LED30.1 (R), LED31.1 (R), LED32.1 (R), LED33.1 (R), LED34.1 (R), LED35.1 (R), LED36.1 (R), U11.35 (CS10)
CS11: LED28.2 (G), LED29.2 (G), LED30.2 (G), LED31.2 (G), LED32.2 (G), LED33.2 (G), LED34.2 (G), LED35.2 (G), LED36.2 (G), U11.37 (CS11)
CS12: LED28.4 (B), LED29.4 (B), LED30.4 (B), LED31.4 (B), LED32.4 (B), LED33.4 (B), LED34.4 (B), LED35.4 (B), LED36.4 (B), U11.38 (CS12)
CS13: LED37.1 (R), LED38.1 (R), LED39.1 (R), LED40.1 (R), LED41.1 (R), LED42.1 (R), LED43.1 (R), LED44.1 (R), LED45.1 (R), U11.39 (CS13)
CS14: LED37.2 (G), LED38.2 (G), LED39.2 (G), LED40.2 (G), LED41.2 (G), LED42.2 (G), LED43.2 (G), LED44.2 (G), LED45.2 (G), U11.40 (CS14)
CS15: LED37.4 (B), LED38.4 (B), LED39.4 (B), LED40.4 (B), LED41.4 (B), LED42.4 (B), LED43.4 (B), LED44.4 (B), LED45.4 (B), U11.41 (CS15)
DRV_INTB: R37.1, U1.3 (GPIO1), U11.7 (INTB)
DRV_ISET: R35.1, U11.13 (ISET)
DRV_SCL: R39.1, U1.28 (GPIO17), U11.10 (SCL)
DRV_SDA: R38.1, U1.27 (GPIO16), U11.9 (SDA)
DRV_SDB: C87.1, R36.1, U1.29 (GPIO18), U11.11 (SDB)
GND: BT1.2 (-), C1.2, C2.2, C3.2, C4.2, C5.2, C6.2, C7.2, C8.2, C9.2, C11.2, C12.2, C13.2, C14.2, C15.2, C16.2, C17.2, C18.2, C19.2, C21.2, C22.2, C23.2, C24.2, C25.2, C26.2, C27.2, C28.2, C29.2, C75.2, C77.2, C80.2, C81.2, C82.2, C83.2, C84.2, C85.2, C86.2, C87.2, D6.2, J1.1 (SHLD), J1.2 (SHLD), J1.3 (SHLD), J1.4 (SHLD), J1.A1B12 (GND), J1.B1A12 (GND), Q5.2 (S), Q6.2 (S), Q7.2 (S), R4.2, R5.2, R8.2, R12.2, R16.2, R17.2, R20.2, R21.2, R25.2, R27.2, R29.2, R35.2, R36.2, SW2.1, U1.47 (VREG_PGND), U1.61 (GND(EP)), U2.1 (TEMP), U2.3 (GND), U2.9 (GND(EP)), U3.3 (GND), U3.EP, U5.2 (GND), U6.1 (SDO/SA0), U6.6 (GND), U6.7 (GND), U7.4 (GND), U7.9 (GND(EP)), U8.2 (GND), U11.8 (ADDR), U11.12 (GND), U11.36 (GND), U11.55 (GND), U11.61 (GND(EP)), Y1.2, Y1.4
IMU_INT1: U1.12 (GPIO8), U6.4 (INT1)
IMU_SCL: R15.1, U1.15 (GPIO11), U6.13 (SCL)
IMU_SDA: R14.1, U1.9 (GPIO6), U6.14 (SDA)
LATCH_G: D4.2 (A2), Q4.1 (G), Q5.3 (D), R24.2
LIGHT: C26.1, Q1.2 (E), R16.1, U1.40 (GPIO26/ADC0)
LONG: C76.1, Q7.1 (G), U8.4 (2Y)
LONG_N: U8.3 (2A), U8.6 (1Y)
PATH_GATE: Q2.1 (G), R21.1, R22.2
PRESS_N: D4.1 (A1), Q8.1 (G), R26.2
PROG: R8.1, U2.2 (PROG)
PWR_EN: D2.3 (K1A2), R17.1, R18.2, U3.4 (EN)
PWR_HOLD: Q5.1 (G), R25.1, U1.32 (GPIO20)
QSPI_SCLK: U1.56 (QSPI_SCLK), U7.6 (CLK)
QSPI_SD0: U1.57 (QSPI_SD0), U7.5 (DI/IO0)
QSPI_SD1: U1.59 (QSPI_SD1), U7.2 (DO/IO1)
QSPI_SD2: U1.58 (QSPI_SD2), U7.3 (/WP/IO2)
QSPI_SD3: U1.55 (QSPI_SD3), U7.7 (/HOLD/IO3)
RUN: Q6.3 (D), R2.1, TP1.1, U1.26 (RUN)
RUN_KICK: C76.2, Q6.1 (G), R29.1
SW1: LED1.3 (A), LED10.3 (A), LED19.3 (A), LED28.3 (A), LED37.3 (A), U11.16 (SW1)
SW2: LED2.3 (A), LED11.3 (A), LED20.3 (A), LED29.3 (A), LED38.3 (A), U11.17 (SW2)
SW3: LED3.3 (A), LED12.3 (A), LED21.3 (A), LED30.3 (A), LED39.3 (A), U11.18 (SW3)
SW4: LED4.3 (A), LED13.3 (A), LED22.3 (A), LED31.3 (A), LED40.3 (A), U11.19 (SW4)
SW5: LED5.3 (A), LED14.3 (A), LED23.3 (A), LED32.3 (A), LED41.3 (A), U11.20 (SW5)
SW6: LED6.3 (A), LED15.3 (A), LED24.3 (A), LED33.3 (A), LED42.3 (A), U11.21 (SW6)
SW7: LED7.3 (A), LED16.3 (A), LED25.3 (A), LED34.3 (A), LED43.3 (A), U11.22 (SW7)
SW8: LED8.3 (A), LED17.3 (A), LED26.3 (A), LED35.3 (A), LED44.3 (A), U11.23 (SW8)
SW9: LED9.3 (A), LED18.3 (A), LED27.3 (A), LED36.3 (A), LED45.3 (A), U11.24 (SW9)
SWCLK: TP2.1, U1.24 (SWCLK)
SWDIO: TP3.1, U1.25 (SWDIO)
SW_ON: D2.1 (A1), Q4.3 (D), R11.1
USB_C_DN: J1.A7 (D-), J1.B7 (D-), R7.1, U5.3 (IO2), U5.4 (IO2)
USB_C_DP: J1.A6 (D+), J1.B6 (D+), R6.1, U5.1 (IO1), U5.6 (IO1)
USB_DM: R7.2, U1.51 (USB_DM)
USB_DP: R6.2, U1.52 (USB_DP)
VBATT: BT1.1 (+), C17.1, D2.2 (K2), Q2.3 (D), Q4.2 (S), R24.1, U2.5 (BAT)
VBSENSE: C21.1, R11.2, R12.1, U1.43 (GPIO29/ADC3)
VBUS: C16.1, C28.1, D3.2 (A), J1.A4B9 (VBUS), J1.B4A9 (VBUS), R18.1, R19.1, R22.1, U2.4 (VCC), U2.8 (CE), U5.5 (VBUS)
VBUS_SENSE: R19.2, R20.1, U1.41 (GPIO27)
VDD_CORE: C5.1, C6.1, C12.1, C13.1, L1.1, U1.6 (DVDD), U1.23 (DVDD), U1.39 (DVDD), U1.50 (VREG_FB)
VREG_AVDD: C22.1, R13.2, U1.46 (VREG_AVDD)
VREG_LX: L1.2, U1.48 (VREG_LX)
VSYS: C18.1, C29.1, C80.1, C81.1, C82.1, C83.1, C84.1, C85.1, C86.1, D3.1 (K), Q2.2 (S), U3.6 (IN), U11.14 (AVCC), U11.15 (PVCC), U11.25 (PVCC)
XIN: C14.1, U1.21 (XIN), Y1.1
XOUT: R1.2, U1.22 (XOUT)
XTAL_R: C15.1, R1.1, Y1.3

Notes on the sheet:
simple_earring — generated schematic
143 components / 78 nets / 4-layer JLCPCB stackup. Power rails (GND, 3V3, VBATT, VSYS, VLED, VBUS, VDD_CORE) are power symbols; only cross-block signals use global labels. Generated from scripts/circuit.py — do not hand-edit; rebuild with `python3 build.py --only schematic`.
J1 is a TYPE-C-31-M-12 right-angle receptacle. VBUS charges the cell AND (rev 2) runs
the board through D3 -> VSYS while a cable is in — see the power-path block.
USB-C receptacle / ESD / series R
CHRG / DONE are open-drain -> GPIO with internal pull-up (low = active); software owns the charge indicator.
Li-ion charger (LGS4056H, 50mA) + LPR302823 LiPo
1M:1M divider off SW_ON, the power latch's output
(VBATT while the latch is held or the button is
pressed). Latch ON: VBATT/2 battery telemetry. Latch
OFF + USB: reads 0, telling firmware to show charge
status instead of running the show. GPIO29/ADC3.
Latch / battery sense -> ADC
3V3 LDO — EN = power latch OR USB (diode-OR, clamped)
Rev 2: USB boots the board even with the latch off. Against
R17's pulldown EN sits at ~VBUS/2, and D2's second diode
clamps it to VBATT+Vf (NCP730 abs max V_EN is VIN+0.3, even
during precharge of a dead cell). Firmware then sees
SW_ON=0 on the sense divider and shows charge status
instead of running the show.
USB wake — VBUS feeds EN through R18
Press: BTN_N -> GND pulls LATCH_G low through D4 A2, Q4 turns on,
SW_ON = VBATT enables the LDO through D2. The CPU then drives
PWR_HOLD high so Q5 keeps LATCH_G low after release. Long press:
firmware drops PWR_HOLD and power falls when the button is
released. D4 A1 pulls PRESS_N low while pressed (the one-button
block turns that into BTN_SENSE). With the board off BTN_N sits
near VBATT and PRESS_N at 0V, so A1 is reverse-biased. D4 is
SILICON (BAV70W), not Schottky: the off-state leaks x R24 must
stay under Q4's 0.45V minimum threshold even hot. ESD: D6 clamps
a strike at the pad and R30 keeps it off BTN_N/D4; C27 debounces.
power button + soft latch
Hold the power button: BTN_SENSE goes high (Q8), C75 charges through R28 and U8 trips 2.2-10.3s later (5s typ; spread
is U8's VT+ and C75's X5R tolerance/bias, simulated in design/sim/button). LONG straps QSPI_SS low through Q7/R3 for as
long as the button is held and kicks RUN low for ~10ms (C76/R29 -> Q6): the chip resets into BOOTSEL. Flash is not
touched. On battery the reset drops PWR_HOLD, so the board turns off on release: the force-off for hung firmware. D5
empties C75 on release. Firmware: GPIO21 no pull-up, high = held; long-press-off < 2s.
one button: long hold = BOOTSEL / force-off
Rev 2: VBATT is the cell alone, VSYS runs the board, so the charger's whole 41mA reaches the cell in
either switch position. Q2's SOURCE is VSYS and its drain VBATT — a P-FET body diode conducts
drain->source, so that way round it blocks USB from back-feeding the cell past the charger.
power path — VBUS runs the board when a cable is in
CHRG and DONE both release at termination, so they cannot tell 'unplugged' from 'plugged in and
full'. 10k:10k, not the 100k/1M used elsewhere: PWR_EN backfeeds through R18 and would float
this node high, so the tap has to be stiff enough to swamp it (0.33V no cable, 2.2-2.75V with
one). That is also what holds Q2's gate low enough to keep the battery path on.
USB cable present — 10k:10k tap on VBUS -> ADC1
ALS-PT19 visible-light phototransistor; 22k
load -> ~0.33V @ 100 lux, saturates ~900
lux. Reads on GPIO26/ADC0.
Ambient light sensor -> ADC0 (rev 2)
CS/SDx/SCx -> VDDIO selects I2C mode 1 and idles the aux master; SDO/SA0 -> GND sets address
0x6A.
IMU — LSM6DS3TR-C on I2C1 (addr 0x6A)
RP2350A
IOVDD 38 and 1 share with C3/C4 — C5/C6 went to the core rail (see the regulator block)
MCU decoupling — 100n on the 3V3 supply pins
L1 dot on the VOUT (pad 1) side — ds Fig 23. C11 CIN; C12 COUT at
L1; C13 the 2nd 4u7 at DVDD 23 (§6.3.8.1). C5/C6 are the 100n HF
pair §6.1.3 wants on the two DVDD pins nearest the regulator —
they already sat there, netted to 3V3. R13+C22 filter VREG_AVDD.
RP2350 core buck regulator (ds §6.3.8)
Pico-style: QSPI_SS is both the flash /CS and the BOOTSEL strap. Q7
(power-button long hold) pulls BOOTSEL_SW low.
QSPI flash (BOOTSEL strap on /CS)
ABM8-272-T3, CL 10pF / ESR<=50R — the 15p caps and R1 are matched to it;
do not retune.
12MHz crystal
RUN / SWD
ADDR to GND: I2C address 0x30. SDB's 100k holds the driver in
shutdown (0.5uA) until firmware raises GPIO18. RISET sets the
full-scale CS current; firmware's GCC and per-LED scaling set the dim
range (design/parts/is31fl3741a.md).
LED matrix driver — IS31FL3741A (variant B)
at U11's PVCC (15, 25) and AVCC (14) pins
Driver supply — 1u + 100n per PVCC/AVCC pin, bulk on VSYS
Each row's anodes share one SW line; the k-th LED of every row shares CS 3k+1..3k+3 (R, G, B). On the board a
row is an arc of adjacent LEDs and the CS lines run as a bus round the ring.
LED matrix — 45 x XL-1010RGB, 9 SW x 15 CS

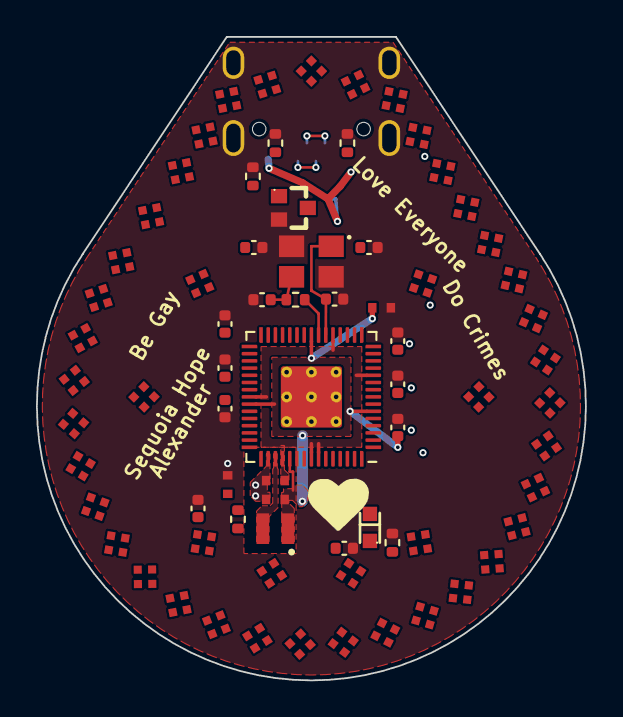
[picture p18: board earring.kicad_pcb from above]

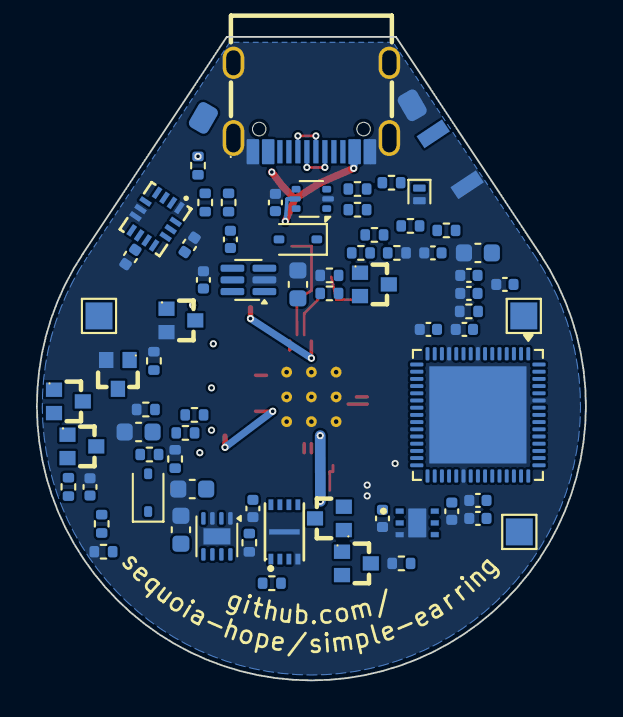
[picture p19: board earring.kicad_pcb from below]

Board: 6 copper layers, 30.5 x 35.8 mm, 143 parts (71 on the bottom side), 78 nets.
