sequoia-hope/simple-earring/scripts/gen_schematic.py

#!/usr/bin/env python3
"""Generate a readable, hand-laid-out .kicad_sch from circuit.py.

The board is generated from code, so the schematic is generated too — but
it is laid out the way a person would draw it, not dumped as a grid of
boxes with a net label on every pin:

  * Real symbols. R/C/L/crystal/switch/battery/test-point use the standard
    IEC/KiCad shapes; ICs are boxes whose pins are placed by FUNCTION
    (power on top, ground on the bottom, bus signals on the side that
    faces the part they talk to).
  * Functional blocks. Each block (USB front end, charger, LDO, LED load
    switch, MCU, QSPI flash, crystal, VREG, IMU, LED ring) is drawn as a
    unit inside a dashed frame with a title, and the parts inside it are
    DIRECTLY WIRED to each other.
  * Rails are power symbols (GND / 3V3 / VBATT / VLED / VBUS / VDD_CORE).
    That is the normal idiom and it is what keeps power grouped instead of
    smeared across the sheet as text.
  * Labels only where a wire would have to travel: block-to-block signals
    (USB_DP/DM, IMU_SDA/SCL/INT1, LED_EN, LED_D0, CHRG, CHRG_DONE,
    VBSENSE) and the LED-chain row breaks. Short local runs also carry a
    small label so the net keeps the name circuit.py gave it, since the
    board is matched to the netlist by name.

Layout is hand-authored (positions are code, derived from each symbol's
real pin coordinates) — but the CONTENT is not: every net comes from
circuit.py, every pin is asserted against it, and the finished sheet is
re-imported through `kicad-cli sch export netlist` and diffed against
circuit.py. If the netlist changes and the layout doesn't, the build
fails loudly instead of drawing a lie.

Five checks keep the drawing honest, and all of them caught real bugs
while it was being written:
  - every pin in circuit.py must be drawn and wired (Book);
  - wires may only meet at declared junctions, and may not cross;
  - block frames may not overlap, and the paper is then cut to fit them
    (SCH_LAYOUT=1 prints each block's measured box, which is how the
    anchors in build_sheet() were chosen);
  - no reference, value or note may land on a wire or on other text —
    KiCad will happily draw an unreadable sheet, so check_text() refuses
    to emit one (SCH_LAYOUT=1 lists every clash);
  - the exported netlist must equal circuit.py's, net for net.

Output: hw/earring/a/earring.kicad_sch (+ .svg/.pdf in out/). Regenerate with
`python3 build.py --only schematic`.
"""
import math
import os
import subprocess
import sys
import uuid
import xml.etree.ElementTree as ET
from collections import defaultdict
from pathlib import Path

sys.path.insert(0, str(Path(__file__).resolve().parent))
from circuit import GPIO, RP_PINS, build_circuit, load_design  # noqa: E402

ROOT = Path(__file__).resolve().parent.parent
from paths import SCH as OUT, VOUT as OUTDIR  # noqa: E402  (per variant)

# Deterministic UUIDs: same circuit -> same file, so git diffs show real
# changes instead of a fresh set of random ids every build.
NS = uuid.UUID("6f1c9d2e-3a4b-4c5d-8e9f-0a1b2c3d4e5f")
SHEET_UUID = uuid.uuid5(NS, "sheet")

FP_LIB = "earring"     # fp-lib-table nickname; gen_board.py writes the table
GRID = 2.54            # 100mil pin pitch
PINLEN = 2.54          # pin stub length on generated box symbols
# The sheet is cut to fit the drawing rather than the drawing padded out to
# a standard size: this is a review document read on screen, and a page with
# 30% empty margin just means everything is 30% smaller when you zoom to fit.
MARGIN = 12.0          # KiCad draws its border ~10mm in from the paper edge
TITLE_BLOCK = (120.0, 40.0)   # keep the bottom-right corner clear

FONT = "(effects (font (size 1.27 1.27)))"


def uid(*parts):
    return str(uuid.uuid5(NS, "/".join(str(p) for p in parts)))


def esc(s):
    return str(s).replace("\\", "\\\\").replace('"', '\\"')


def q(v):
    """Round to the 1.27mm half-grid the whole sheet lives on."""
    return round(v, 4)


def eff(size=1.27, bold=False, just=None, hide=False, rot=None):
    b = " (bold yes)" if bold else ""
    # KiCad only knows left/right/top/bottom/mirror; horizontal centring is
    # the default, so "center" is spelled by leaving the token out.
    if just:
        just = " ".join(t for t in just.split() if t != "center")
    j = f" (justify {just})" if just else ""
    h = " (hide yes)" if hide else ""
    return f"(effects (font (size {size} {size}){b}){j}{h})"


# ---------------------------------------------------------------------------
# symbol geometry
# ---------------------------------------------------------------------------
def xf(px, py, rot):
    """Library coords (+y up) -> sheet offset (+y down) for a placed symbol."""
    x, y = px, -py
    if rot == 0:
        return x, y
    if rot == 90:
        return y, -x
    if rot == 180:
        return -x, -y
    if rot == 270:
        return -y, x
    raise ValueError(f"rotation {rot} not supported")


class SymDef:
    def __init__(self, name, style, pins, extent, sexpr, tb=(False, False)):
        self.name = name        # lib_id suffix
        self.style = style      # box | passive | power | point
        self.pins = pins        # num -> (px, py) connection anchor
        self.extent = extent    # (half_w, half_h) including pin stubs
        self.sexpr = sexpr
        self.has_top, self.has_bot = tb   # pins on the top / bottom edge


class Sch:
    def __init__(self):
        self.defs = {}          # name -> SymDef
        self.body = []
        self.refs = set()
        self.pwr_n = 0
        self.frames = []        # (x0, y0, x1, y1, title)
        self.head = []          # header text, outside every block frame
        self.wires = []         # (a, b) — split at junctions on render
        self.jpts = set()
        self.texts = []         # (x0, y0, x1, y1, what) for check_text()
        self._bb = None
        self.page = None        # (w, h), measured in render()

    # -- library -------------------------------------------------------
    def _emit_def(self, name, value, style, pins, gfx, extent,
                  hide_numbers=False, hide_names=False, power=False,
                  ref_prefix="U", name_offset=0.508, tb=(False, False)):
        """pins: list of (num, pname, px, py, angle, length, etype)."""
        head = [f'\t\t(symbol "gen:{esc(name)}"']
        if power:
            head.append("\t\t\t(power)")
        head += [f'\t\t\t(pin_numbers (hide {"yes" if hide_numbers else "no"}))',
                 f'\t\t\t(pin_names (offset {name_offset})'
                 + (' (hide yes))' if hide_names else ')'),
                 "\t\t\t(exclude_from_sim no)",
                 "\t\t\t(in_bom yes)",
                 "\t\t\t(on_board yes)",
                 f'\t\t\t(property "Reference" "{ref_prefix}" (at 0 0 0)'
                 f"\n\t\t\t\t{eff(hide=True)})",
                 f'\t\t\t(property "Value" "{esc(value)}" (at 0 0 0)'
                 f"\n\t\t\t\t{eff(hide=True)})",
                 f'\t\t\t(property "Footprint" "" (at 0 0 0)'
                 f"\n\t\t\t\t{eff(hide=True)})",
                 f'\t\t\t(symbol "{esc(name)}_0_1"']
        head += ["\t\t\t\t" + g for g in gfx]
        head.append("\t\t\t)")
        head.append(f'\t\t\t(symbol "{esc(name)}_1_1"')
        for p in pins:
            num, pname, px, py, ang, ln, etype = p[:7]
            hid = " (hide yes)" if len(p) > 7 and p[7] else ""
            head.append(f"\t\t\t\t(pin {etype} line (at {q(px)} {q(py)} {ang})"
                        f" (length {q(ln)}){hid}")
            head.append(f'\t\t\t\t\t(name "{esc(pname)}" {FONT})')
            head.append(f'\t\t\t\t\t(number "{esc(num)}" {FONT}))')
        head.append("\t\t\t)")
        head.append("\t\t)")
        anchors = {p[0]: (p[2], p[3]) for p in pins}
        self.defs[name] = SymDef(name, style, anchors, extent,
                                 "\n".join(head), tb)

    def defbox(self, name, value, sides, min_w=0.0):
        """sides: dict with 'l','r','t','b' -> list of slots, each None or
        (num, pname) or (num, pname, [more_nums]). The third form stacks
        several pads on one graphical pin — KiCad's idiom for pads that are
        internally connected (the ESD array's two IO1 pads, a crystal's two
        ground tabs), which is the only honest way to draw them as one net."""
        if name in self.defs:
            return self.defs[name]
        L = list(sides.get("l", []))
        R = list(sides.get("r", []))
        T = list(sides.get("t", []))
        B = list(sides.get("b", []))
        # Top/bottom pin names run vertically INSIDE the box and would be
        # written straight through any side-pin name whose text reaches the
        # same columns. Where they would collide, reserve as many side slots
        # as the vertical name is tall so the two never share a row.
        CW = 1.3   # per-character advance, generous on purpose

        def band(side, hw):
            names = [p[1] for p in side if p]
            if not names:
                return 0
            half = (len(side) - 1) * GRID / 2.0 + 0.8      # name columns
            lw = max([len(p[1]) for p in L if p] or [0]) * CW
            rw = max([len(p[1]) for p in R if p] or [0]) * CW
            if -hw + 0.5 + lw < -half and half < hw - 0.5 - rw:
                return 0                                   # they clear
            return min(6, math.ceil(max(map(len, names)) * 1.27 / GRID) + 1)
        nv = max(len(L), len(R), 1)
        nh = max(len(T), len(B), 0)
        h = (nv + 1) * GRID
        wname = 0.0
        lw = max([len(p[1]) for p in L if p] or [0])
        rw = max([len(p[1]) for p in R if p] or [0])
        if lw or rw:
            wname = (lw + rw) * 1.15 + 5.0
        w = max((nh + 1) * GRID, wname, min_w)
        w = math.ceil(w / GRID) * GRID
        L = [None] * band(T, w / 2.0) + L + [None] * band(B, w / 2.0)
        R = [None] * band(T, w / 2.0) + R + [None] * band(B, w / 2.0)
        nv = max(len(L), len(R), 1)
        h = (nv + 1) * GRID
        hw, hh = w / 2.0, h / 2.0
        gfx = [f"(rectangle (start {q(-hw)} {q(hh)}) (end {q(hw)} {q(-hh)})",
               "\t\t\t\t\t(stroke (width 0.254) (type default))",
               "\t\t\t\t\t(fill (type background)))"]
        pins = []

        def add(p, px, py, ang):
            pins.append((p[0], p[1], px, py, ang, PINLEN, "passive"))
            for extra in (p[2] if len(p) > 2 else []):
                pins.append((extra, p[1], px, py, ang, PINLEN, "passive",
                             True))

        for i, p in enumerate(L):
            if p:
                add(p, -hw - PINLEN, hh - GRID * (i + 1), 0)
        for i, p in enumerate(R):
            if p:
                add(p, hw + PINLEN, hh - GRID * (i + 1), 180)
        x0 = -(len(T) - 1) * GRID / 2.0 if T else 0.0
        for i, p in enumerate(T):
            if p:
                add(p, x0 + GRID * i, hh + PINLEN, 270)
        x0 = -(len(B) - 1) * GRID / 2.0 if B else 0.0
        for i, p in enumerate(B):
            if p:
                add(p, x0 + GRID * i, -hh - PINLEN, 90)
        self._emit_def(name, value, "box", pins, gfx,
                       (hw + PINLEN, hh + PINLEN),
                       tb=(any(T), any(B)))
        return self.defs[name]

    def defpassives(self):
        st = "\t\t\t\t\t(stroke (width {w}) (type default))\n" \
             "\t\t\t\t\t(fill (type none)))"

        def poly(pts, w=0):
            s = " ".join(f"(xy {q(a)} {q(b)})" for a, b in pts)
            return f"(polyline (pts {s})\n" + st.format(w=w)

        # resistor
        self._emit_def("R", "R", "passive", [
            ("1", "~", 0, 3.81, 270, 1.27, "passive"),
            ("2", "~", 0, -3.81, 90, 1.27, "passive")],
            ["(rectangle (start -1.016 -2.54) (end 1.016 2.54)\n"
             "\t\t\t\t\t(stroke (width 0.254) (type default))\n"
             "\t\t\t\t\t(fill (type none)))"],
            (2.0, 3.81), hide_numbers=True, hide_names=True, ref_prefix="R")
        # capacitor
        self._emit_def("C", "C", "passive", [
            ("1", "~", 0, 3.81, 270, 2.794, "passive"),
            ("2", "~", 0, -3.81, 90, 2.794, "passive")],
            [poly([(-2.032, 0.762), (2.032, 0.762)], 0.508),
             poly([(-2.032, -0.762), (2.032, -0.762)], 0.508)],
            (2.1, 3.81), hide_numbers=True, hide_names=True, ref_prefix="C")
        # inductor
        arcs = []
        for k in range(4):
            y0 = 2.54 - 1.27 * k
            arcs.append(f"(arc (start 0 {q(y0)}) (mid 0.6323 {q(y0 - 0.635)})"
                        f" (end 0 {q(y0 - 1.27)})\n"
                        "\t\t\t\t\t(stroke (width 0) (type default))\n"
                        "\t\t\t\t\t(fill (type none)))")
        self._emit_def("L", "L", "passive", [
            ("1", "~", 0, 3.81, 270, 1.27, "passive"),
            ("2", "~", 0, -3.81, 90, 1.27, "passive")],
            arcs, (1.5, 3.81), hide_numbers=True, hide_names=True,
            ref_prefix="L")
        # 4-pin crystal, GND on 2/4
        self._emit_def("XTAL", "Crystal", "passive", [
            ("1", "~", -3.81, 0, 0, 1.27, "passive"),
            ("3", "~", 3.81, 0, 180, 1.27, "passive"),
            ("2", "~", 0, -5.08, 90, 1.27, "passive"),
            ("4", "~", 0, -5.08, 90, 1.27, "passive", True)],
            [poly([(-2.54, 2.286), (-2.54, 3.556), (2.54, 3.556),
                   (2.54, 2.286)]),
             poly([(-2.54, -2.286), (-2.54, -3.556), (2.54, -3.556),
                   (2.54, -2.286)]),
             poly([(-2.54, 0), (-2.032, 0)]),
             poly([(2.032, 0), (2.54, 0)]),
             poly([(-2.032, -1.27), (-2.032, 1.27)], 0.508),
             poly([(2.032, -1.27), (2.032, 1.27)], 0.508),
             poly([(0, -3.81), (0, -3.556)]),
             "(rectangle (start -1.143 2.54) (end 1.143 -2.54)\n"
             "\t\t\t\t\t(stroke (width 0.3048) (type default))\n"
             "\t\t\t\t\t(fill (type none)))"],
            (3.81, 5.08), hide_numbers=True, hide_names=True, ref_prefix="Y")
        # test point
        self._emit_def("TP", "TestPoint", "point", [
            ("1", "~", 0, 0, 90, 2.54, "passive")],
            [poly([(0, 2.54), (0, 3.048)]),
             "(circle (center 0 3.556) (radius 0.762)\n"
             "\t\t\t\t\t(stroke (width 0.254) (type default))\n"
             "\t\t\t\t\t(fill (type none)))"],
            (1.2, 4.4), hide_numbers=True, hide_names=True, ref_prefix="TP")
        # battery cell
        self._emit_def("BATT", "Battery", "passive", [
            ("1", "+", 0, 3.81, 270, 2.54, "passive"),
            ("2", "-", 0, -3.81, 90, 2.54, "passive")],
            [poly([(-2.54, 1.27), (2.54, 1.27)]),
             poly([(-1.27, -1.27), (1.27, -1.27)], 0.762),
             poly([(0, 1.27), (0, 0.508)]),
             poly([(-2.54, 0.508), (2.54, 0.508)], 0.0),
             poly([(-1.27, -0.508), (1.27, -0.508)], 0.762),
             poly([(0, -1.27), (0, -1.27)])],
            (2.7, 3.81), hide_numbers=True, hide_names=True, ref_prefix="BT")
        # 4-terminal tact switch. Two terminals leave each side of the body
        # and are the same node; the LCSC footprint numbers them across the
        # part, so the blades are {1,3} (one side) and {2,4} (the other) —
        # which is why the numbering here is not 1,2 | 3,4.
        self._emit_def("SW_PUSH", "SW_Push", "passive", [
            ("1", "~", -6.35, 2.54, 0, 2.54, "passive"),
            ("3", "~", -6.35, -2.54, 0, 2.54, "passive"),
            ("2", "~", 6.35, 2.54, 180, 2.54, "passive"),
            ("4", "~", 6.35, -2.54, 180, 2.54, "passive")],
            [poly([(-3.81, 2.54), (-2.54, 2.54), (-2.54, -2.54),
                   (-3.81, -2.54)]),
             poly([(3.81, 2.54), (2.54, 2.54), (2.54, -2.54), (3.81, -2.54)]),
             poly([(-3.302, 1.27), (3.302, 1.27)]),
             poly([(0, 1.27), (0, 3.302)]),
             poly([(-1.905, 3.302), (1.905, 3.302)])],
            (6.35, 4.4), hide_numbers=True, hide_names=True, ref_prefix="SW")
        # 2-terminal tact (B3U-3000P power button): 1 left, 2 right
        self._emit_def("SW_PUSH2", "SW_Push", "passive", [
            ("1", "~", -5.08, 0, 0, 2.54, "passive"),
            ("2", "~", 5.08, 0, 180, 2.54, "passive")],
            ["(circle (center -2.032 0) (radius 0.508)\n"
             "\t\t\t\t\t(stroke (width 0) (type default))\n"
             "\t\t\t\t\t(fill (type none)))",
             "(circle (center 2.032 0) (radius 0.508)\n"
             "\t\t\t\t\t(stroke (width 0) (type default))\n"
             "\t\t\t\t\t(fill (type none)))",
             poly([(-2.54, 1.27), (2.54, 1.27)]),
             poly([(0, 1.27), (0, 3.048)]),
             poly([(-1.27, 3.048), (1.27, 3.048)])],
            (5.08, 3.3), hide_numbers=True, hide_names=True, ref_prefix="SW")
        # dual common-cathode SILICON pair (BAV70W): 1 = A1 (left), 2 = A2
        # (right), 3 = K (down). Both anodes conduct INTO the shared cathode.
        self._emit_def("D_CC", "D_CC", "passive", [
            ("1", "A1", -7.62, 0, 0, 3.81, "passive"),
            ("2", "A2", 7.62, 0, 180, 3.81, "passive"),
            ("3", "K", 0, -5.08, 90, 3.81, "passive")],
            [poly([(-3.81, 1.27), (-3.81, -1.27), (-1.27, 0), (-3.81, 1.27)]),
             poly([(-1.27, 1.016), (-1.27, -1.016)], 0.254),
             poly([(3.81, 1.27), (3.81, -1.27), (1.27, 0), (3.81, 1.27)]),
             poly([(1.27, -1.016), (1.27, 1.016)], 0.254),
             poly([(-1.27, 0), (1.27, 0)]),
             poly([(0, 0), (0, -1.27)]),
             "(circle (center 0 0) (radius 0.254)\n"
             "\t\t\t\t\t(stroke (width 0) (type default))\n"
             "\t\t\t\t\t(fill (type outline)))"],
            (7.62, 5.08), hide_numbers=True, hide_names=True, ref_prefix="D")
        # dual series SILICON pair (BAV99W, BAT54SW pinout): 1 = A1, 2 = K2,
        # 3 = K1+A2 mid tap. Conduction pin1 -> pin3 -> pin2; tap hangs down.
        self._emit_def("D_SS", "D_SS", "passive", [
            ("1", "A1", -7.62, 0, 0, 3.81, "passive"),
            ("2", "K2", 7.62, 0, 180, 3.81, "passive"),
            ("3", "K1A2", 0, -5.08, 90, 3.81, "passive")],
            [poly([(-3.81, 1.27), (-3.81, -1.27), (-1.27, 0), (-3.81, 1.27)]),
             poly([(-1.27, 1.016), (-1.27, -1.016)], 0.254),
             poly([(-1.27, 0), (1.27, 0)]),
             poly([(1.27, 1.27), (1.27, -1.27), (3.81, 0), (1.27, 1.27)]),
             poly([(3.81, 1.016), (3.81, -1.016)], 0.254),
             poly([(0, 0), (0, -1.27)]),
             "(circle (center 0 0) (radius 0.254)\n"
             "\t\t\t\t\t(stroke (width 0) (type default))\n"
             "\t\t\t\t\t(fill (type outline)))"],
            (7.62, 5.08), hide_numbers=True, hide_names=True, ref_prefix="D")
        # single Schottky (D3, VBUS -> VSYS): 1 = K, 2 = A, conduction
        # left-to-right. Same bar-with-hooks as one half of D_SS.
        self._emit_def("D_SCH", "D_SCH", "passive", [
            ("2", "A", -6.35, 0, 0, 3.81, "passive"),
            ("1", "K", 6.35, 0, 180, 3.81, "passive")],
            [poly([(-2.54, 1.27), (-2.54, -1.27), (0, 0), (-2.54, 1.27)]),
             poly([(0.508, 1.016), (0, 1.016), (0, -1.016), (-0.508, -1.016)],
                  0.254),
             poly([(0, 0), (2.54, 0)])],
            (6.35, 2.54), hide_numbers=True, hide_names=True, ref_prefix="D")
        # single silicon diode (D3 1N4007WS, D5 1N4148WS): 1 = K, 2 = A,
        # conduction left-to-right, plain bar
        self._emit_def("D", "D", "passive", [
            ("2", "A", -6.35, 0, 0, 3.81, "passive"),
            ("1", "K", 6.35, 0, 180, 3.81, "passive")],
            [poly([(-2.54, 1.27), (-2.54, -1.27), (0, 0), (-2.54, 1.27)]),
             poly([(0, 1.27), (0, -1.27)], 0.254),
             poly([(0, 0), (2.54, 0)])],
            (6.35, 2.54), hide_numbers=True, hide_names=True, ref_prefix="D")
        # bidirectional TVS (D6 PESD5V0S1BL), non-polar: two triangles
        # meeting at a Z bar
        self._emit_def("D_TVS", "D_TVS", "passive", [
            ("1", "~", -6.35, 0, 0, 2.54, "passive"),
            ("2", "~", 6.35, 0, 180, 2.54, "passive")],
            [poly([(-3.81, 1.27), (-3.81, -1.27), (0, 0), (-3.81, 1.27)]),
             poly([(3.81, 1.27), (3.81, -1.27), (0, 0), (3.81, 1.27)]),
             poly([(-0.508, 1.524), (0, 1.27), (0, -1.27), (0.508, -1.524)],
                  0.254)],
            (6.35, 2.54), hide_numbers=True, hide_names=True, ref_prefix="D")

        # enhancement MOSFETs, 1 = G (left), 2 = S (bottom), 3 = D (top) —
        # the SOT-323/SOT-23 3-lead pad order, so the symbol pin numbers are
        # the footprint pad numbers with no translation table.
        # source_top: the high-side P-FET drawing (source up to the rail,
        # drain down to the load) — the power latch's Q4. Same pads.
        def fet(name, p_channel, source_top=False):
            arrow = ([(-0.508, 0.635), (-0.508, -0.635), (0.508, 0),
                      (-0.508, 0.635)] if p_channel else
                     [(0.508, 0.635), (0.508, -0.635), (-0.508, 0),
                      (0.508, 0.635)])
            sy = 1 if source_top else -1
            self._emit_def(name, name, "passive", [
                ("1", "G", -7.62, 0, 0, 3.81, "passive"),
                ("2", "S", 2.54, sy * 7.62, 270 if source_top else 90, 3.81,
                 "passive"),
                ("3", "D", 2.54, -sy * 7.62, 90 if source_top else 270, 3.81,
                 "passive")],
                [poly([(-3.81, 0), (-2.54, 0)]),
                 poly([(-2.54, 2.54), (-2.54, -2.54)]),
                 poly([(-1.27, 2.54), (-1.27, 1.27)]),
                 poly([(-1.27, 0.635), (-1.27, -0.635)]),
                 poly([(-1.27, -1.27), (-1.27, -2.54)]),
                 poly([(-1.27, 1.905), (2.54, 1.905), (2.54, 3.81)]),
                 poly([(-1.27, -1.905), (2.54, -1.905), (2.54, -3.81)]),
                 poly([(-1.27, 0), (2.54, 0)]),
                 poly([(2.54, 0), (2.54, sy * 1.905)]),
                 poly(arrow)],
                (7.62, 7.62), hide_numbers=True, hide_names=True,
                ref_prefix="Q")

        fet("Q_PMOS", True)
        fet("Q_NMOS", False)
        fet("Q_PMOS_HS", True, source_top=True)
        # SPDT slide switch, 2 = common
        self._emit_def("SW_SPDT", "SW_SPDT", "passive", [
            ("1", "~", -6.35, 2.54, 0, 3.81, "passive"),
            ("3", "~", -6.35, -2.54, 0, 3.81, "passive"),
            ("2", "~", 6.35, 0, 180, 3.81, "passive")],
            ["(circle (center -2.286 2.54) (radius 0.254)\n"
             "\t\t\t\t\t(stroke (width 0) (type default))\n"
             "\t\t\t\t\t(fill (type outline)))",
             "(circle (center -2.286 -2.54) (radius 0.254)\n"
             "\t\t\t\t\t(stroke (width 0) (type default))\n"
             "\t\t\t\t\t(fill (type outline)))",
             "(circle (center 2.286 0) (radius 0.254)\n"
             "\t\t\t\t\t(stroke (width 0) (type default))\n"
             "\t\t\t\t\t(fill (type outline)))",
             poly([(2.286, 0), (-2.032, 2.032)])],
            (6.35, 4.4), hide_numbers=True, hide_names=True, ref_prefix="SW")

    def defpower(self, rail):
        name = f"P_{rail}"
        if name in self.defs:
            return self.defs[name]
        st = "\t\t\t\t\t(stroke (width 0) (type default))\n" \
             "\t\t\t\t\t(fill (type none)))"

        def poly(pts):
            s = " ".join(f"(xy {q(a)} {q(b)})" for a, b in pts)
            return f"(polyline (pts {s})\n" + st
        if rail == "GND":
            gfx = [poly([(0, 0), (0, -1.27)]),
                   poly([(-1.27, -1.27), (1.27, -1.27), (0, -2.54),
                         (-1.27, -1.27)])]
            ext = (1.5, 4.6)
        else:
            gfx = [poly([(0, 0), (0, 2.54)]),
                   poly([(-0.762, 1.27), (0, 2.54), (0.762, 1.27)])]
            ext = (1.5, 4.6)
        self._emit_def(name, rail, "power",
                       [("1", rail, 0, 0, 90 if rail != "GND" else 270, 0,
                         "power_in")],
                       gfx, ext, hide_numbers=True, hide_names=True,
                       power=True, ref_prefix="#PWR")
        return self.defs[name]

    # -- bbox / frames -------------------------------------------------
    def _grow(self, x, y, pad=0.0):
        """Grow the current block's frame box.

        Only symbols, labels and notes count — NOT the wires. A block's
        frame is meant to say "these parts belong together"; the wires that
        leave it to reach the MCU would otherwise stretch every satellite
        frame back over the chip it connects to.
        """
        if self._bb is None:
            self._bb = [x - pad, y - pad, x + pad, y + pad]
        else:
            b = self._bb
            b[0] = min(b[0], x - pad)
            b[1] = min(b[1], y - pad)
            b[2] = max(b[2], x + pad)
            b[3] = max(b[3], y + pad)

    def begin(self, title):
        self._title = title
        self._bb = None

    def end(self, pad=5.0):
        b = self._bb
        assert b, f"empty block {self._title}"
        x0, y0, x1, y1 = b[0] - pad, b[1] - pad, b[2] + pad, b[3] + pad
        pts = [(x0, y0), (x1, y0), (x1, y1), (x0, y1), (x0, y0)]
        s = " ".join(f"(xy {q(a)} {q(c)})" for a, c in pts)
        self.body.append(
            f"\t(polyline (pts {s})\n"
            "\t\t(stroke (width 0.1524) (type dash))\n"
            f'\t\t(uuid "{uid("frame", self._title)}"))')
        self.body.append(
            f'\t(text "{esc(self._title)}" (at {q(x0 + 1.27)} {q(y0 - 1.6)} 0)'
            f"\n\t\t{eff(2.2, bold=True, just='left bottom')}"
            f'\n\t\t(uuid "{uid("ftitle", self._title)}"))')
        self.frames.append((x0, y0 - 6.0, x1, y1, self._title))
        self._bb = None

    # -- text collisions -----------------------------------------------
    # Every readability bug this sheet has ever had was a label sitting on
    # a wire or on another label. Nothing in KiCad complains about that, so
    # the generator has to: record a box for every piece of text drawn and
    # refuse to emit a sheet where one lands on a wire or on its neighbour.
    def _text_box(self, s, x, y, size, just):
        w = len(str(s)) * size * 0.72
        j = (just or "").split()
        if "right" in j:
            x0, x1 = x - w, x
        elif "left" in j:
            x0, x1 = x, x + w
        else:
            x0, x1 = x - w / 2.0, x + w / 2.0
        # KiCad anchors vertically by baseline-ish; which side the glyphs
        # fall on depends on the justify token, so claim both. Conservative
        # in the safe direction: a false positive costs a nudge, a missed
        # one ships an unreadable sheet.
        return (x0, y - size, x1, y + size)

    def _note_text(self, s, x, y, size, just, what, on_wire=False,
                   group=None):
        """on_wire: a net label is SUPPOSED to sit on the wire it names, so
        those are only checked against other text, never against copper.
        group: consecutive lines of one wrapped note share a group and are
        allowed to sit tight against each other."""
        if not str(s).strip():
            return
        self.texts.append(self._text_box(s, x, y, size, just)
                          + (what, on_wire, group))

    @staticmethod
    def _overlap(a, b, pad=0.0):
        return (a[0] < b[2] - pad and b[0] < a[2] - pad
                and a[1] < b[3] - pad and b[1] < a[3] - pad)

    def check_text(self, verbose=False):
        """Report text that lands on a wire or on other text."""
        bad = []
        for i, t in enumerate(self.texts):
            for u in self.texts[i + 1:]:
                if t[6] is not None and t[6] == u[6]:
                    continue           # two lines of the same note
                if self._overlap(t, u, pad=0.01):
                    bad.append(f"{t[4]!r} overlaps text {u[4]!r}")
        for t in self.texts:
            if t[5]:
                continue
            for a, b in self.wires:
                if a[1] == b[1]:                       # horizontal run
                    x0, x1 = sorted((a[0], b[0]))
                    seg = (x0, a[1], x1, a[1])
                else:
                    y0, y1 = sorted((a[1], b[1]))
                    seg = (a[0], y0, a[0], y1)
                # text needs air around it, not just non-overlap
                if (t[0] - 0.5 < seg[2] and seg[0] < t[2] + 0.5
                        and t[1] - 0.5 < seg[3] and seg[1] < t[3] + 0.5):
                    bad.append(f"{t[4]!r} sits on the wire {a}-{b}")
                    break
        if verbose:
            for m in sorted(set(bad)):
                print("  TEXT:", m)
        return sorted(set(bad))

    def measure_page(self):
        """Paper size = everything drawn, plus a margin, on a 5mm grid."""
        x1 = max(f[2] for f in self.frames)
        y1 = max(f[3] for f in self.frames)
        for s, x, y, size in self.head:
            x1 = max(x1, x + len(s) * size * 0.72)
            y1 = max(y1, y)
        w = math.ceil((x1 + MARGIN) / 5.0) * 5.0
        h = math.ceil((y1 + MARGIN) / 5.0) * 5.0
        # nothing may sit under the title block in the bottom-right corner
        tb = (w - MARGIN - TITLE_BLOCK[0], h - MARGIN - TITLE_BLOCK[1])
        clash = [f[4] for f in self.frames if f[2] > tb[0] and f[3] > tb[1]]
        if clash:
            h = math.ceil((y1 + MARGIN + TITLE_BLOCK[1]) / 5.0) * 5.0
        self.page = (w, h)
        return self.page

    def check_frames(self, verbose=False):
        """Blocks must not overlap and must fit the sheet.

        Set SCH_LAYOUT=1 to print every block's measured box first — that
        listing is how the anchors below were chosen, and it is what you
        want when a netlist change makes a block outgrow its slot.
        """
        if verbose:
            for f in sorted(self.frames, key=lambda f: (f[0], f[1])):
                print(f"  [{f[0]:7.1f} {f[1]:7.1f}] .. [{f[2]:7.1f} "
                      f"{f[3]:7.1f}]  {f[2]-f[0]:6.1f} x {f[3]-f[1]:6.1f}"
                      f"  {f[4]}")
        bad = []
        for i in range(len(self.frames)):
            for j in range(i + 1, len(self.frames)):
                a, b = self.frames[i], self.frames[j]
                if (a[0] < b[2] and b[0] < a[2]
                        and a[1] < b[3] and b[1] < a[3]):
                    bad.append(f"{a[4]!r} overlaps {b[4]!r}")
        assert not bad, "block frames overlap:\n  " + "\n  ".join(bad)
        for f in self.frames:
            assert f[0] > 0 and f[1] > 0, \
                f"block {f[4]!r} runs off the top/left of the sheet: {f[:4]}"

    # -- placement -----------------------------------------------------
    def place(self, symname, ref, value, x, y, rot=0, footprint="",
              hide_value=False, ref_off=None):
        d = self.defs[symname]
        assert ref not in self.refs, f"duplicate reference {ref}"
        self.refs.add(ref)
        x, y = q(x), q(y)
        hw, hh = d.extent
        if rot in (90, 270):
            hw, hh = hh, hw
        self._grow(x - hw, y - hh)
        self._grow(x + hw, y + hh)
        # reference / value text placement
        if d.style == "box":
            rx = x - hw
            ry = y - hh - (4.6 if d.has_top else 1.6)
            rj = "left bottom"
            # The value goes under the box, but bottom pins drop their wires
            # from the middle of that edge straight into a ground symbol, so
            # run the value leftwards out of the centre instead of starting
            # at the left edge and crossing it.
            vx = x - 3.81 if d.has_bot else x - hw
            vy = y + hh + (4.4 if d.has_bot else 3.4)
            vj = "right bottom" if d.has_bot else "left bottom"
        elif d.style == "point":
            # A test point is a stub: the pad faces its wire and the body
            # (the circle) faces away, so the only free side is behind it.
            rx, ry, rj = x - hw - 0.6, y - 2.0, "right bottom"
            vx, vy, vj = x - hw - 0.6, y + 1.1, "right bottom"
        elif d.style == "power":
            rx, ry, rj = x, y, "left bottom"
            vx, vj = x, "center"
            vy = y + 4.6 if symname.endswith("GND") else y - 3.4
            if rot == 180:
                vy = y - 4.0 if symname.endswith("GND") else y + 5.2
        else:
            # Put the text where this part's pins are NOT. Every pin grows a
            # wire, so the free side depends on which way the part is turned,
            # not on the rotation angle as such: read it off the placed pin
            # offsets and pick the axis with the shorter reach.
            pts = [xf(px, py, rot) for px, py in d.pins.values()]
            xs = [p[0] for p in pts]
            ys = [p[1] for p in pts]
            if max(ys) - min(ys) >= max(xs) - min(xs):
                # pins stack vertically -> park the text alongside the body,
                # between the two pins so it cannot reach either run
                rx, ry, rj = x + hw + 0.6, y - 2.0, "left bottom"
                vx, vy, vj = x + hw + 0.6, y + 1.1, "left bottom"
            else:
                # pins run left-right -> stack the text above and below,
                # stepped off the pin axis so it clears the wires' corners
                rx, ry, rj = x + 1.9, y - hh - 2.8, "left bottom"
                vx, vy, vj = x + 1.9, y + hh + 4.2, "left bottom"
        if ref_off:
            rx, ry = x + ref_off[0], y + ref_off[1]
            vx, vy = x + ref_off[0], y + ref_off[1] + 3.4
        self._grow(rx, ry - 1.3)
        self._grow(rx + len(ref) * 1.0, ry)
        if d.style != "power":
            self._note_text(ref, rx, ry, 1.27, rj, f"{ref} ref")
        if not hide_value:
            self._note_text(value, vx, vy, 1.27, vj, f"{ref} value {value!r}")
        # KiCad adds the symbol's orientation to a property's own angle, and
        # renders a resulting 180 deg upside-down. Cancel the rotation for
        # quarter turns; a half turn already reads the right way up.
        tang = 0 if rot in (0, 180) else (360 - rot) % 360
        parts = [f'\t(symbol (lib_id "gen:{esc(symname)}")',
                 f"\t\t(at {x} {y} {rot})",
                 "\t\t(unit 1) (exclude_from_sim no) (in_bom yes)"
                 " (on_board yes) (dnp no)",
                 f'\t\t(uuid "{uid("sym", ref)}")',
                 f'\t\t(property "Reference" "{esc(ref)}" '
                 f"(at {q(rx)} {q(ry)} {tang})\n\t\t\t"
                 + eff(1.27, just=rj, hide=(d.style == "power")) + ")",
                 f'\t\t(property "Value" "{esc(value)}" '
                 f"(at {q(vx)} {q(vy)} {tang})\n\t\t\t"
                 + eff(1.27, just=vj, hide=hide_value) + ")"]
        if footprint:
            parts.append(f'\t\t(property "Footprint" "{FP_LIB}:{esc(footprint)}"'
                         f" (at {x} {y} 0)\n\t\t\t{eff(hide=True)})")
        for num in d.pins:
            parts.append(f'\t\t(pin "{esc(num)}" (uuid "{uid("pin", ref, num)}"))')
        parts.append('\t\t(instances (project "earring"'
                     f'\n\t\t\t(path "/{SHEET_UUID}"'
                     f'\n\t\t\t\t(reference "{esc(ref)}") (unit 1)))))')
        self.body.append("\n".join(parts))
        out = {}
        for num, (px, py) in d.pins.items():
            dx, dy = xf(px, py, rot)
            out[num] = (q(x + dx), q(y + dy))
        return out

    # -- connectivity items --------------------------------------------
    def wire(self, a, b):
        a, b = (q(a[0]), q(a[1])), (q(b[0]), q(b[1]))
        if a == b:
            return
        assert a[0] == b[0] or a[1] == b[1], \
            f"diagonal wire {a} -> {b} (schematic wires must be orthogonal)"
        self.wires.append((a, b))

    def path(self, *pts):
        for a, b in zip(pts, pts[1:]):
            self.wire(a, b)

    def junction(self, p):
        self.jpts.add((q(p[0]), q(p[1])))

    def nc(self, p):
        self.body.append(
            f"\t(no_connect (at {q(p[0])} {q(p[1])})"
            f'\n\t\t(uuid "{uid("nc", p)}"))')

    def label(self, net, p, rot=0, just="left", size=1.0):
        """Name a wire that KiCad would otherwise auto-name.

        These are GLOBAL labels even though the run is local, because a
        plain label on the root sheet comes back out of the netlister as
        `/LED_D7`, and the board is matched to circuit.py by net name — a
        rename would relabel every net on a hand-routed board. Drawn small,
        so naming a wire costs a word rather than a box.
        """
        self.glabel(net, p, rot=rot, just=just, size=size)

    def glabel(self, net, p, rot=0, just="left", size=1.27):
        # the label box is the text plus KiCad's arrow shape around it
        if rot == 0:
            self._note_text(f" {net} ", p[0], p[1], size, "left",
                            f"label {net}", on_wire=True)
        elif rot == 180:
            self._note_text(f" {net} ", p[0], p[1], size, "right",
                            f"label {net}", on_wire=True)
        self.body.append(
            f'\t(global_label "{esc(net)}" (shape input) '
            f"(at {q(p[0])} {q(p[1])} {rot})\n\t\t"
            + eff(size, just=just) + f'\n\t\t(uuid "{uid("gl", net, p)}"))')

    def note(self, s, x, y, width, size=1.4):
        """Block note, wrapped to `width` mm. KiCad has no text box, and an
        unwrapped note stretches the block frame across half the sheet."""
        cols = max(16, int(width / (size * 0.72)))
        line, lines = "", []
        for word in s.split():
            if line and len(line) + 1 + len(word) > cols:
                lines.append(line)
                line = word
            else:
                line = f"{line} {word}".strip()
        if line:
            lines.append(line)
        for i, ln in enumerate(lines):
            self.text(ln, x, y + i * size * 1.9, size=size,
                      group=("note", q(x), q(y)))

    def text(self, s, x, y, size=1.27, bold=False, just="left bottom",
             frame=True, group=None):
        if not frame:
            self.head.append((s, x, y, size))
        if frame:
            self._grow(x, y - size)
            self._grow(x + len(s) * size * 0.72, y)
            self._note_text(s, x, y, size, just, f"note {s[:24]!r}",
                            group=group)
        self.body.append(
            f'\t(text "{esc(s)}" (at {q(x)} {q(y)} 0)\n\t\t'
            + eff(size, bold=bold, just=just)
            + f'\n\t\t(uuid "{uid("txt", x, y, s[:28])}"))')

    # -- convenience ---------------------------------------------------
    def rail(self, net, p, rot=0):
        """Power/ground symbol whose pin lands exactly on p."""
        self.defpower(net)
        self.pwr_n += 1
        self.place(f"P_{net}", f"#PWR{self.pwr_n:04d}", net, p[0], p[1],
                   rot=rot)
        return p

    @staticmethod
    def _interior(a, b, p):
        """Is p strictly between the ends of the orthogonal segment a-b?"""
        if a[0] == b[0] == p[0]:
            return min(a[1], b[1]) < p[1] < max(a[1], b[1])
        if a[1] == b[1] == p[1]:
            return min(a[0], b[0]) < p[0] < max(a[0], b[0])
        return False

    def finish_wires(self):
        """Split every wire at the junctions on it, and put a junction
        wherever one wire ENDS in the middle of another.

        Both steps are what the KiCad editor does as you draw. Without
        them the connectivity engine only breaks a run at its first
        junction, so a single long rail wire silently connects the first
        two taps and leaves the rest floating — which is exactly what the
        netlist round-trip caught the first time this sheet was drawn.
        """
        ends = set()
        for a, b in self.wires:
            ends.add(a)
            ends.add(b)
        stray = set()
        for a, b in self.wires:
            for e in ends:
                if self._interior(a, b, e):
                    if e not in self.jpts:
                        stray.add(e)
                    self.jpts.add(e)
        # Every intended tap is declared with junction(); anything else that
        # lands mid-wire is a layout collision that would silently short two
        # nets, so refuse to emit it.
        assert not stray, ("wires meet at undeclared points (layout "
                           "collision): "
                           + ", ".join(f"({x}, {y})" for x, y in sorted(stray)))
        # Crossings. Two wires that cross without a junction are legal but
        # they are exactly where a net label lands on two nets at once (a
        # label attaches to every wire under it), and they are the thing
        # that makes a sheet hard to read. Route around them instead.
        hs = [(a, b) for a, b in self.wires if a[1] == b[1]]
        vs = [(a, b) for a, b in self.wires if a[0] == b[0] and a[1] != b[1]]
        cross = []
        for ha, hb in hs:
            x0, x1 = sorted((ha[0], hb[0]))
            for va, vb in vs:
                y0, y1 = sorted((va[1], vb[1]))
                if x0 < va[0] < x1 and y0 < ha[1] < y1:
                    cross.append((va[0], ha[1]))
        assert not cross, ("wires cross without connecting: "
                           + ", ".join(f"({x}, {y})" for x, y in sorted(set(cross))))
        out = []
        for a, b in self.wires:
            cuts = sorted((p for p in self.jpts if self._interior(a, b, p)),
                          key=lambda p: (p[0] - a[0]) ** 2 + (p[1] - a[1]) ** 2)
            prev = a
            for c in cuts:
                out.append((prev, c))
                prev = c
            out.append((prev, b))
        seen = set()
        for a, b in out:
            k = tuple(sorted([a, b]))
            if k in seen:
                continue
            seen.add(k)
            self.body.append(
                f"\t(wire (pts (xy {a[0]} {a[1]}) (xy {b[0]} {b[1]}))"
                "\n\t\t(stroke (width 0) (type default))"
                f'\n\t\t(uuid "{uid("w", a, b)}"))')
        for p in sorted(self.jpts):
            self.body.append(
                f"\t(junction (at {p[0]} {p[1]}) (diameter 0)"
                " (color 0 0 0 0)"
                f'\n\t\t(uuid "{uid("j", p)}"))')

    def render(self):
        self.finish_wires()
        w, h = self.page or self.measure_page()
        return ("(kicad_sch\n\t(version 20250114)\n"
                '\t(generator "gen_schematic")\n'
                '\t(generator_version "9.0")\n'
                f'\t(uuid "{SHEET_UUID}")\n'
                f'\t(paper "User" {w} {h})\n'
                "\t(lib_symbols\n"
                + "\n".join(d.sexpr for d in self.defs.values())
                + "\n\t)\n" + "\n".join(self.body) + "\n)\n")


# ---------------------------------------------------------------------------
# IC symbol pin maps: pins are placed by function, not by pad order.
# 'l'/'r'/'t'/'b' = box side, None = blank slot (used to line pins up with
# whatever they wire to, and to keep side pins clear of the vertical pin
# names on the top/bottom edges).
# ---------------------------------------------------------------------------
def mcu_sides():
    gp = {g: p for g, p in GPIO.items()}
    used = {29: "GPIO18", 28: "GPIO17", 27: "GPIO16", 3: "GPIO1", 2: "GPIO0",
            34: "GPIO22", 9: "GPIO6", 15: "GPIO11", 12: "GPIO8",
            31: "GPIO19", 32: "GPIO20", 33: "GPIO21", 42: "GPIO28",
            40: "GPIO26/ADC0", 43: "GPIO29/ADC3"}
    unused = [(gp[g], f"GPIO{g}") for g in sorted(gp)
              if gp[g] not in used and gp[g] != 43]
    # Side pins are grouped by the block they wire to, with the gaps sized so
    # each satellite block gets its own band of sheet next to the chip. The
    # 22 unused GPIOs go along the bottom edge, where a row of no-connect
    # crosses costs width the box already has instead of 56mm of side edge
    # that the flash, crystal and SWD clusters need.
    left = ([(26, "RUN"), (24, "SWCLK"), (25, "SWDIO")]
            + [None] * 14
            + [(60, "QSPI_SS"), (56, "QSPI_SCLK"), (57, "QSPI_SD0"),
               (59, "QSPI_SD1"), (58, "QSPI_SD2"), (55, "QSPI_SD3")]
            + [None] * 17
            + [(21, "XIN"), (22, "XOUT")]
            + [None] * 8
            + [(51, "USB_DM"), (52, "USB_DP")])
    right = [(29, "GPIO18"), (28, "GPIO17"), (27, "GPIO16"), (3, "GPIO1"),
             (2, "GPIO0"), (34, "GPIO22"), (9, "GPIO6"), (15, "GPIO11"),
             (12, "GPIO8"), (31, "GPIO19"), (32, "GPIO20"), (33, "GPIO21"),
             (42, "GPIO28"),
             (40, "GPIO26/ADC0"), (43, "GPIO29/ADC3")]
    top = [(1, "IOVDD"), (11, "IOVDD"), (20, "IOVDD"), (30, "IOVDD"),
           (38, "IOVDD"), (45, "IOVDD"), (54, "QSPI_IOVDD"),
           (53, "USB_OTP_VDD"), (44, "ADC_AVDD"), None,
           (6, "DVDD"), (23, "DVDD"), (39, "DVDD")]
    bot = ([(61, "GND(EP)"), (47, "VREG_PGND"), (48, "VREG_LX"),
            (50, "VREG_FB"), (46, "VREG_AVDD"), (49, "VREG_VIN")]
           + [None] * 2 + unused)
    return {"l": [(str(a), b) if a else None for a, b in
                  [(p or (None, None)) for p in left]],
            "r": [(str(a), b) if a else None for a, b in
                  [(p or (None, None)) for p in right]],
            "t": [(str(a), b) if a else None for a, b in
                  [(p or (None, None)) for p in top]],
            "b": [(str(a), b) if a else None for a, b in
                  [(p or (None, None)) for p in bot]]}


IC_SIDES = {
    "flash": {"l": [("8", "VCC"), None, None, ("4", "GND"), ("9", "GND(EP)")],
              "r": [("1", "/CS"), ("6", "CLK"), ("5", "DI/IO0"),
                    ("2", "DO/IO1"), ("3", "/WP/IO2"), ("7", "/HOLD/IO3")]},
    "charger": {"l": [("4", "VCC"), ("8", "CE"), ("2", "PROG"), ("1", "TEMP")],
                "r": [("5", "BAT"), None, None, ("6", "DONE"), ("7", "CHRG")],
                "b": [("3", "GND"), ("9", "GND(EP)")]},
    "ldo": {"l": [("6", "IN"), None, ("4", "EN")],
            "r": [("1", "OUT"), None, ("5", "NC"), ("2", "NC")],
            "b": [("3", "GND"), ("EP", "EP")]},
    "load_switch": {"l": [("A2", "VIN"), None, ("B2", "ON")],
                    "r": [("A1", "VOUT")],
                    "b": [("B1", "GND")]},
    # The array's two IO1 pads (1, 6) and two IO2 pads (3, 4) are the same
    # node inside the part, so they are stacked on one graphical pin and the
    # symbol reads as what it is: a shunt sitting between D+ and D-.
    "usb_esd": {"t": [("1", "IO1", ["6"])], "b": [("3", "IO2", ["4"])],
                "l": [("5", "VBUS")], "r": [("2", "GND")]},
    "usb_conn": {"r": [("A4B9", "VBUS"), ("B4A9", "VBUS"), None,
                       ("A6", "D+"), ("B6", "D+")] + [None] * 10
                 + [("A7", "D-"), ("B7", "D-"), None,
                    ("A5", "CC1"), ("B5", "CC2"), None,
                    ("A8", "SBU1"), ("B8", "SBU2")] + [None] * 3,
                 "b": [("A1B12", "GND"), ("B1A12", "GND"), ("1", "SHLD"),
                       ("2", "SHLD"), ("3", "SHLD"), ("4", "SHLD")]},
    # Serial trio is 12=CS / 13=SCL / 14=SDA (ST ds Table 2) — the bus pair
    # faces the MCU on the left, the mode strap joins SDx/SCx on the right.
    "imu": {"l": [("14", "SDA"), ("13", "SCL"), None, ("4", "INT1"),
                  ("9", "INT2"), ("10", "NC"), ("11", "NC")],
            "r": [("12", "CS"), ("2", "SDx"), ("3", "SCx"), None,
                  ("1", "SDO/SA0")],
            "t": [("8", "VDD"), ("5", "VDDIO")],
            "b": [("6", "GND"), ("7", "GND")]},
    # WS2816C-1313/4P: 1 VDD, 2 DO, 3 GND, 4 DI (circuit.py LED_PIN)
    "led": {"l": [None, ("4", "DI"), None],
            "r": [None, ("2", "DO"), None],
            "t": [("1", "VDD")], "b": [("3", "GND")]},
    # Variant B. IS31FL3741A (U11), pin map circuit.py DRV_SW_PIN /
    # DRV_CS_PIN: bus and control on the left, the matrix lines on the right.
    "matrix_driver": {
        "l": [("9", "SDA"), ("10", "SCL"), ("7", "INTB"), ("11", "SDB"),
              None, ("13", "ISET"), ("8", "ADDR")],
        "r": [(str(15 + i), f"SW{i}") for i in range(1, 10)] + [None]
             + [(str(n), f"CS{k}") for k, n in zip(
                 range(1, 40),
                 [26, 27, 28, 29, 30, 31, 32, 33, 34, 35, 37, 38, 39, 40,
                  41, 42, 43, 44, 45, 46, 47, 48, 49, 50, 51, 52, 53, 54,
                  56, 57, 58, 59, 60, 1, 2, 3, 4, 5, 6])],
        "t": [("15", "PVCC"), ("25", "PVCC"), ("14", "AVCC")],
        "b": [("12", "GND"), ("36", "GND"), ("55", "GND"), ("61", "GND(EP)")]},
    # Variant C. AW20198QNR (U11), pin map circuit.py AW_SW_PIN /
    # AW_CS_PIN: bus and control on the left, the matrix lines on the right.
    "matrix_driver_aw": {
        "l": [("28", "SDA"), ("27", "SCL"), ("26", "EN"), None,
              ("29", "ISET"), ("25", "AD0"), ("24", "AD1"), None,
              ("30", "SYNC")],
        "r": [(str(n), f"SW{k}") for k, n in
              ((1, 6), (2, 4), (3, 7), (4, 3), (5, 8), (6, 2), (7, 9),
               (8, 1), (9, 10), (10, 40), (11, 11))] + [None]
             + [(str(n), f"CS{k}") for k, n in zip(
                 range(1, 19), [39, 38, 37, 36, 35, 34, 33, 32, 31,
                                21, 20, 19, 18, 17, 15, 14, 13, 12])],
        "t": [("5", "PVCC"), ("22", "VCC")],
        "b": [("23", "GND"), ("16", "PGND"), ("41", "GND(EP)")]},
    # XL-1010RGB-YG: pad 3 common anode on top, cathodes R/G/B below.
    "rgb_led": {"t": [("3", "A")], "b": [("1", "R"), ("2", "G"), ("4", "B")]},
    # XL-1615RGBC-RF: pad 2 common anode on top, cathodes R/G/B below.
    "rgb_led_1615": {"t": [("2", "A")],
                     "b": [("1", "R"), ("3", "G"), ("4", "B")]},
    # 74LVC2G14 (U8): 1A -> 1Y feeds 2A -> 2Y. 1Y and 2A sit next to each
    # other on the right so the LONG_N link is a two-pin bracket, and 2Y
    # leaves below it.
    "logic_schmitt2": {"l": [("1", "1A"), None, None, None],
                       "r": [("6", "1Y"), ("3", "2A"), None, ("4", "2Y")],
                       "t": [("5", "VCC")], "b": [("2", "GND")]},
    # ALS-PT19 phototransistor: collector up to 3V3, emitter down into
    # the LIGHT node (load R + filter C hang off it)
    "light_sensor": {"t": [("1", "C")], "b": [("2", "E")]},
}

# a little extra width where the automatic sizing leaves names touching
IC_MIN_W = {"led": 12.7}

PASSIVE_SYM = {"r_": "R", "c_": "C", "vreg_inductor": "L", "crystal": "XTAL",
               "testpoint": "TP", "battery_clip": "BATT", "battery_pads": "BATT",
               "bootsel_button": "SW_PUSH", "slide_switch": "SW_SPDT",
               "power_button": "SW_PUSH2", "cc_diode": "D_CC",
               "or_diode": "D_SS", "sys_diode": "D", "si_diode": "D",
               "tvs_bidir": "D_TVS",
               "oring_pfet": "Q_PMOS", "lvl_nfet": "Q_NMOS"}


def sym_for(part):
    for k, v in PASSIVE_SYM.items():
        if part == k or part.startswith(k):
            return v
    return part


# ---------------------------------------------------------------------------
# electrical bookkeeping: every pin drawn must match circuit.py, and every
# pin in circuit.py must be drawn.
# ---------------------------------------------------------------------------
class Book:
    def __init__(self, comps):
        self.comps = comps
        self.seen = set()

    def net(self, ref, pin):
        return self.comps[ref].pins[str(pin)]

    def take(self, ref, pin, expect=None):
        p = str(pin)
        assert p in self.comps[ref].pins, f"{ref} has no pin {p}"
        got = self.comps[ref].pins[p]
        if expect is not None:
            assert got == expect, f"{ref}.{p} is net {got!r}, expected {expect!r}"
        self.seen.add((ref, p))
        return got

    def report(self):
        missing = []
        for ref, c in self.comps.items():
            for p in c.pins:
                if (ref, p) not in self.seen:
                    missing.append(f"{ref}.{p}")
        assert not missing, ("pins drawn but not connected to anything: "
                             + ", ".join(missing[:40]))


# ---------------------------------------------------------------------------
# blocks
# ---------------------------------------------------------------------------
def put(s, cir, ref, x, y, rot=0, hide_value=False, ref_off=None):
    c = cir.components[ref]
    name = sym_for(c.part)
    return s.place(name, ref, c.value, x, y, rot=rot,
                   footprint=c.footprint, hide_value=hide_value,
                   ref_off=ref_off)


def vdrop(s, cir, bk, ref, x, ytop, rail="GND", drop=3.81):
    """2-pin part hanging down from (x, ytop) into a rail symbol below."""
    p = put(s, cir, ref, x, ytop + 3.81)
    bk.take(ref, "1")
    bk.take(ref, "2", rail)
    s.wire(p["2"], (x, p["2"][1] + drop))
    s.rail(rail, (x, p["2"][1] + drop))
    return p


def blk_usb(s, cir, bk, x, y):
    s.begin("USB-C receptacle / ESD / series R")
    j = put(s, cir, "J1", x, y, hide_value=True)
    xr = j["A4B9"][0]
    for n in ("A4B9", "B4A9"):
        bk.take("J1", n, "VBUS")
    xv = xr + 12.7
    s.wire(j["A4B9"], (xv, j["A4B9"][1]))
    s.wire(j["B4A9"], (xv, j["B4A9"][1]))
    s.wire((xv, j["A4B9"][1]), (xv, j["B4A9"][1]))
    ytop = j["A4B9"][1] - 15.24
    s.wire((xv, j["A4B9"][1]), (xv, ytop))
    s.junction((xv, j["A4B9"][1]))
    s.junction((xv, ytop))
    s.rail("VBUS", (xv, ytop))
    # ST USBLC6-2 ds §3: a 100n right at the array keeps VBUS stiff during
    # a positive surge, which is what the rail-to-rail clamp references.
    s.wire((xv, ytop), (xv + 12.7, ytop))
    vdrop(s, cir, bk, "C28", xv + 12.7, ytop, "GND")

    # D+ / D- pairs join, run straight out through the series resistors, and
    # the ESD array shunts both of them from between the two runs
    xd = xr + 6.35
    ydp = q((j["A6"][1] + j["B6"][1]) / 2.0)
    ydn = q((j["A7"][1] + j["B7"][1]) / 2.0)
    u5 = put(s, cir, "U5", xr + 33.02, q((ydp + ydn) / 2.0))
    assert ydp < u5["1"][1] and u5["3"][1] < ydn, \
        "the ESD array must sit between the D+ and D- runs"
    for a, b, pin, net, mid_y, rref, out in (
            ("A6", "B6", "1", "USB_C_DP", ydp, "R6", "USB_DP"),
            ("A7", "B7", "3", "USB_C_DN", ydn, "R7", "USB_DM")):
        bk.take("J1", a, net)
        bk.take("J1", b, net)
        bk.take("U5", pin, net)
        bk.take("U5", {"1": "6", "3": "4"}[pin], net)   # stacked pad
        s.wire(j[a], (xd, j[a][1]))
        s.wire(j[b], (xd, j[b][1]))
        s.wire((xd, j[a][1]), (xd, j[b][1]))
        s.junction((xd, mid_y))
        r = put(s, cir, rref, xr + 48.26, mid_y, rot=90)
        bk.take(rref, "1", net)
        bk.take(rref, "2", out)
        s.wire((xd, mid_y), r["1"])
        s.junction((u5[pin][0], mid_y))
        s.wire(u5[pin], (u5[pin][0], mid_y))
        s.label(net, (xd + 2.54, mid_y), size=1.0)
        s.wire(r["2"], (r["2"][0] + 5.08, r["2"][1]))
        s.glabel(out, (r["2"][0] + 5.08, r["2"][1]))
    bk.take("U5", "5", "VBUS")
    s.wire(u5["5"], (u5["5"][0] - 6.35, u5["5"][1]))
    s.rail("VBUS", (u5["5"][0] - 6.35, u5["5"][1]))
    bk.take("U5", "2", "GND")
    s.wire(u5["2"], (u5["2"][0] + 6.35, u5["2"][1]))
    s.rail("GND", (u5["2"][0] + 6.35, u5["2"][1]))

    # CC pulldowns: the lower pin turns down first so the two never cross
    for cc, rref, dx in (("B5", "R5", 15.24), ("A5", "R4", 27.94)):
        net = bk.take("J1", cc)
        s.wire(j[cc], (xr + dx, j[cc][1]))
        s.label(net, (xr + 7.62, j[cc][1]), size=1.0)
        s.wire((xr + dx, j[cc][1]), (xr + dx, j["B5"][1] + 6.35))
        r = put(s, cir, rref, xr + dx, j["B5"][1] + 6.35 + 3.81)
        bk.take(rref, "1", net)
        bk.take(rref, "2", "GND")
        s.wire(r["2"], (r["2"][0], r["2"][1] + 3.81))
        s.rail("GND", (r["2"][0], r["2"][1] + 3.81))
    for n in ("A8", "B8"):
        bk.take("J1", n, "")
        s.nc(j[n])

    # shield + GND legs down to a common bus
    gnds = ["A1B12", "B1A12", "1", "2", "3", "4"]
    ybus = j["A1B12"][1] + 6.35
    for n in gnds:
        bk.take("J1", n, "GND")
        s.wire(j[n], (j[n][0], ybus))
    s.wire((j[gnds[0]][0], ybus), (j[gnds[-1]][0], ybus))
    for n in gnds[1:-1]:
        s.junction((j[n][0], ybus))
    xg = j[gnds[2]][0]
    s.wire((xg, ybus), (xg, ybus + 2.54))
    s.junction((xg, ybus))
    s.rail("GND", (xg, ybus + 2.54))
    s.note("J1 is a TYPE-C-31-M-12 right-angle receptacle. VBUS charges "
           "the cell AND (rev 2) runs the board through D3 -> VSYS while a "
           "cable is in — see the power-path block.", x - 8.89, ybus + 12.7,
           88.0)
    s.end()


def blk_charger(s, cir, bk, x, y):
    s.begin("Li-ion charger (LGS4056H, 50mA) + LPR302823 LiPo")
    u = put(s, cir, "U2", x, y)
    # VBUS in
    xb = u["4"][0] - 12.7
    for p in ("4", "8"):
        bk.take("U2", p, "VBUS")
        s.wire(u[p], (xb, u[p][1]))
    s.wire((xb, u["4"][1]), (xb, u["8"][1]))
    s.wire((xb, u["4"][1]), (xb, u["4"][1] - 10.16))
    s.junction((xb, u["4"][1]))
    s.rail("VBUS", (xb, u["4"][1] - 10.16))
    # VBUS bulk cap
    yc = u["4"][1] - 5.08
    s.wire((xb, yc), (xb - 12.7, yc))
    s.junction((xb, yc))
    vdrop(s, cir, bk, "C16", xb - 12.7, yc, "GND")
    # PROG resistor
    bk.take("U2", "2", "PROG")
    xp = u["2"][0] - 20.32
    s.wire(u["2"], (xp, u["2"][1]))
    s.label("PROG", (xp + 3.81, u["2"][1]), size=1.0)
    s.wire((xp, u["2"][1]), (xp, u["2"][1] + 5.08))
    vdrop(s, cir, bk, "R8", xp, u["2"][1] + 5.08, "GND")
    # TEMP grounded (NTC disabled)
    bk.take("U2", "1", "GND")
    s.wire(u["1"], (u["1"][0] - 6.35, u["1"][1]))
    s.rail("GND", (u["1"][0] - 6.35, u["1"][1]))
    # die + EP grounds
    for p in ("3", "9"):
        bk.take("U2", p, "GND")
        s.wire(u[p], (u[p][0], u[p][1] + 3.81))
    s.wire((u["3"][0], u["3"][1] + 3.81), (u["9"][0], u["9"][1] + 3.81))
    s.wire((u["3"][0], u["3"][1] + 3.81), (u["3"][0], u["3"][1] + 6.35))
    s.junction((u["3"][0], u["3"][1] + 3.81))
    s.rail("GND", (u["3"][0], u["3"][1] + 6.35))
    # BAT node: cell + bulk cap + VBATT rail
    bk.take("U2", "5", "VBATT")
    xv = u["5"][0] + 20.32
    ybat = u["5"][1] - 8.89
    s.path(u["5"], (xv, u["5"][1]), (xv, ybat))
    s.rail("VBATT", (xv, ybat - 5.08))
    s.wire((xv, ybat), (xv, ybat - 5.08))
    s.wire((xv, ybat), (xv + 25.4, ybat))
    s.junction((xv, ybat))
    vdrop(s, cir, bk, "C17", xv + 12.7, ybat, "GND")
    s.junction((xv + 12.7, ybat))
    vdrop(s, cir, bk, "BT1", xv + 25.4, ybat, "GND")
    for p, net in (("6", "CHRG_DONE"), ("7", "CHRG")):
        bk.take("U2", p, net)
        s.wire(u[p], (u[p][0] + 3.81, u[p][1]))
        s.glabel(net, (u[p][0] + 3.81, u[p][1]))
    s.note("CHRG / DONE are open-drain -> GPIO with internal pull-up "
           "(low = active); software owns the charge indicator.",
           x - 40.64, u["3"][1] + 20.32, 115.0)
    s.end()


def blk_sense(s, cir, bk, x, y):
    s.begin("Latch / battery sense -> ADC")
    s.glabel("SW_ON", (x - 10.16, y), rot=180, just="right")
    s.wire((x - 10.16, y), (x, y))
    s.wire((x, y), (x, y + 3.81))
    r11 = put(s, cir, "R11", x, y + 7.62)
    bk.take("R11", "1", "SW_ON")
    bk.take("R11", "2", "VBSENSE")
    node = (x, r11["2"][1] + 3.81)
    s.wire(r11["2"], node)
    r12 = put(s, cir, "R12", x, node[1] + 3.81)
    bk.take("R12", "1", "VBSENSE")
    bk.take("R12", "2", "GND")
    s.wire(node, r12["1"])
    s.wire(r12["2"], (x, r12["2"][1] + 3.81))
    s.rail("GND", (x, r12["2"][1] + 3.81))
    s.junction(node)
    s.wire(node, (x + 15.24, node[1]))
    vdrop(s, cir, bk, "C21", x + 15.24, node[1], "GND")
    s.junction((x + 15.24, node[1]))
    s.wire(node, (x - 10.16, node[1]))
    s.glabel("VBSENSE", (x - 10.16, node[1]), rot=180, just="right")
    s.note("1M:1M divider off SW_ON, the power latch's output (VBATT "
           "while the latch is held or the button is pressed). Latch ON: "
           "VBATT/2 battery telemetry. Latch OFF + USB: reads 0, telling "
           "firmware to show charge status instead of running the show. "
           "GPIO29/ADC3.",
           x - 22.86, r12["2"][1] + 12.7, 56.0)
    s.end()


def blk_ldo(s, cir, bk, x, y):
    s.begin("3V3 LDO — EN = power latch OR USB (diode-OR, clamped)")
    u = put(s, cir, "U3", x, y)
    bk.take("U3", "6", "VSYS")   # rev 2: the system rail, not the cell
    # 20.32, not the old 15.24: rev 2 renamed this riser VSYS and gave D2's
    # clamp its own VBATT rail one column to the right, so the IN riser has
    # to step left far enough that the two rail labels do not collide (and
    # far enough that C18's branch clears the clamp riser entirely)
    xin = u["6"][0] - 20.32
    s.wire(u["6"], (xin, u["6"][1]))
    s.wire((xin, u["6"][1]), (xin, u["6"][1] - 7.62))
    s.rail("VSYS", (xin, u["6"][1] - 7.62))
    # 7.62 off the riser, which after the riser's own 5.08 step keeps C18
    # in the column it has always occupied (SW2's reference text sits there)
    s.wire((xin, u["6"][1] - 3.81), (xin - 7.62, u["6"][1] - 3.81))
    s.junction((xin, u["6"][1] - 3.81))
    vdrop(s, cir, bk, "C18", xin - 7.62, u["6"][1] - 3.81, "GND")
    # OUT
    bk.take("U3", "1", "3V3")
    xo = u["1"][0] + 15.24
    s.wire(u["1"], (xo, u["1"][1]))
    s.wire((xo, u["1"][1]), (xo, u["1"][1] - 7.62))
    s.rail("3V3", (xo, u["1"][1] - 7.62))
    s.wire((xo, u["1"][1] - 3.81), (xo + 12.7, u["1"][1] - 3.81))
    s.junction((xo, u["1"][1] - 3.81))
    vdrop(s, cir, bk, "C19", xo + 12.7, u["1"][1] - 3.81, "GND")
    for p in ("2", "5"):
        bk.take("U3", p, "")
        s.nc(u[p])
    for p in ("3", "EP"):
        bk.take("U3", p, "GND")
        s.wire(u[p], (u[p][0], u[p][1] + 3.81))
    s.wire((u["3"][0], u["3"][1] + 3.81), (u["EP"][0], u["EP"][1] + 3.81))
    s.wire((u["3"][0], u["3"][1] + 3.81), (u["3"][0], u["3"][1] + 6.35))
    s.junction((u["3"][0], u["3"][1] + 3.81))
    s.rail("GND", (u["3"][0], u["3"][1] + 6.35))
    # EN = SW_ON OR VBUS. D2 (BAT54SW series pair) stands VERTICALLY
    # beside U3 — the strip further left belongs to C18 and the IN
    # riser. SW_ON enters pin 1 from below, the clamp cathode (pin 2)
    # rises to VBATT above, and the midpoint (pin 3) taps right, in
    # line with U3's EN pin. Diode 1 lifts EN to VBATT-0.2 when the
    # switch is on; diode 2 clamps EN to VBATT+Vf because NCP730 abs
    # max V_EN is only (V_IN + 0.3). The VBUS half of the OR (R18) has
    # its own block — see "USB wake"; the nets meet on the PWR_EN
    # global label.
    bk.take("U3", "4", "PWR_EN")
    u4 = u["4"]
    d2 = put(s, cir, "D2", u4[0] - 13.97, u4[1], rot=90,
             ref_off=(-11.43, 3.3))
    bk.take("D2", "1", "SW_ON")
    bk.take("D2", "2", "VBATT")
    bk.take("D2", "3", "PWR_EN")
    # the clamp cathode used to join the IN riser 1.27 to the left, back
    # when IN was VBATT too; rev 2's power path made that riser VSYS, so
    # the clamp needs a VBATT rail of its own. Still legal, and still the
    # conservative choice: V_EN max is V_IN + 0.3 and VSYS >= VBATT always.
    s.wire(d2["2"], (d2["2"][0], d2["2"][1] - 11.43))
    s.rail("VBATT", (d2["2"][0], d2["2"][1] - 11.43))
    s.wire(d2["3"], u4)
    # R17 pulldown hangs off the EN run (100k: EN has an internal <=1uA
    # pull-up to VIN, so a 1M pulldown could fail to turn the LDO off);
    # the PWR_EN glabel stubs off R17's riser
    s.junction((u4[0] - 6.35, u4[1]))
    s.wire((u4[0] - 6.35, u4[1]), (u4[0] - 6.35, u4[1] + 2.54))
    # drop=6.35 + the one-step-left column push the GND rail's text
    # clear of U3's value text below the box
    vdrop(s, cir, bk, "R17", u4[0] - 6.35, u4[1] + 2.54, "GND", drop=6.35)
    s.junction((u4[0] - 6.35, u4[1] + 1.27))
    s.wire((u4[0] - 6.35, u4[1] + 1.27), (u4[0] - 7.62, u4[1] + 1.27))
    s.glabel("PWR_EN", (u4[0] - 7.62, u4[1] + 1.27), rot=180,
             just="right", size=1.0)
    # SW_ON (VBATT while the power latch is on) arrives from the latch
    # block on a global label — it was the slide switch's common until the
    # LiPo change, and D2 / R11 still read it exactly the same way
    s.path(d2["1"], (d2["1"][0], d2["1"][1] + 5.08),
           (d2["1"][0] - 10.16, d2["1"][1] + 5.08))
    s.glabel("SW_ON", (d2["1"][0] - 10.16, d2["1"][1] + 5.08), rot=180,
             just="right", size=1.0)
    s.end()


def blk_latch(s, cir, bk, x, y):
    """(x, y) is Q4's centre. LATCH_G runs left from Q4's gate as a bus:
    R24 up to the cell, Q5 down (the CPU's hold), D4 at the far end with
    the button under it and BTN_SENSE out to the left."""
    s.begin("power button + soft latch")
    q4 = s.place("Q_PMOS_HS", "Q4", cir.components["Q4"].value, x, y,
                 footprint=cir.components["Q4"].footprint)
    bk.take("Q4", "1", "LATCH_G")
    bk.take("Q4", "2", "VBATT")
    bk.take("Q4", "3", "SW_ON")
    xs = x + 2.54
    s.wire(q4["2"], (xs, y - 12.7))
    s.rail("VBATT", (xs, y - 12.7))
    s.path(q4["3"], (xs, y + 12.7), (xs + 12.7, y + 12.7))
    s.glabel("SW_ON", (xs + 12.7, y + 12.7), size=1.0)
    # LATCH_G bus, Q4 gate leftwards
    xr, xq, xe = x - 12.7, x - 17.78, x - 27.94
    s.wire(q4["1"], (xe, y))
    s.label("LATCH_G", (xe + 1.27, y), size=1.0)
    r24 = put(s, cir, "R24", xr, y - 7.62)
    bk.take("R24", "1", "VBATT")
    bk.take("R24", "2", "LATCH_G")
    s.wire(r24["2"], (xr, y))
    s.junction((xr, y))
    s.wire(r24["1"], (xr, y - 15.24))
    s.rail("VBATT", (xr, y - 15.24))
    # Q5: drain up to the bus, source to GND, gate PWR_HOLD from the left
    q5 = put(s, cir, "Q5", xq - 2.54, y + 35.56)
    bk.take("Q5", "1", "PWR_HOLD")
    bk.take("Q5", "2", "GND")
    bk.take("Q5", "3", "LATCH_G")
    s.wire(q5["3"], (xq, y))
    s.junction((xq, y))
    s.wire(q5["2"], (xq, y + 45.72))
    s.rail("GND", (xq, y + 45.72))
    xpd = xq - 12.7
    s.wire(q5["1"], (xpd - 2.54, y + 35.56))
    s.junction((xpd, y + 35.56))
    r25 = put(s, cir, "R25", xpd, y + 43.18)
    bk.take("R25", "1", "PWR_HOLD")
    bk.take("R25", "2", "GND")
    s.wire(r25["1"], (xpd, y + 35.56))
    s.wire(r25["2"], (xpd, y + 50.8))
    s.rail("GND", (xpd, y + 50.8))
    s.glabel("PWR_HOLD", (xpd - 2.54, y + 35.56), rot=180, just="right")
    # D4 at the bus's far end: A2 = LATCH_G (right), A1 = BTN_SENSE (left),
    # K = BTN_N down into the button, which closes to GND
    # ref/value parked ABOVE the bus: below it they land on the BTN_N run
    d4 = put(s, cir, "D4", xe - 7.62, y, ref_off=(-3.0, -7.4))
    bk.take("D4", "1", "PRESS_N")
    bk.take("D4", "2", "LATCH_G")
    bk.take("D4", "3", "BTN_N")
    s.wire(d4["1"], (d4["1"][0] - 5.08, y))
    s.glabel("PRESS_N", (d4["1"][0] - 5.08, y), rot=180, just="right")
    kx = d4["3"][0]
    s.wire(d4["3"], (kx, y + 12.7))
    s.label("BTN_N", (kx, y + 10.16), size=1.0)
    # R30 isolates BTN_N from the pad; D6 clamps at the pad
    r30 = put(s, cir, "R30", kx - 10.16, y + 12.7, rot=90)
    bk.take("R30", "1", "BTN_EXT")
    bk.take("R30", "2", "BTN_N")
    s.wire(r30["2"], (kx, y + 12.7))
    xx = kx - 20.32
    s.wire(r30["1"], (xx, y + 12.7))
    s.junction((xx, y + 12.7))
    d6 = put(s, cir, "D6", xx, y + 22.86, rot=270)
    if d6["1"][1] > d6["2"][1]:
        raise SystemExit("D6: pick the other rotation so pin 1 is on top")
    bk.take("D6", "1", "BTN_EXT")
    bk.take("D6", "2", "GND")
    s.wire((xx, y + 12.7), d6["1"])
    s.wire(d6["2"], (xx, d6["2"][1] + 2.54))
    s.rail("GND", (xx, d6["2"][1] + 2.54))
    sw = put(s, cir, "SW2", xx - 10.16, y + 12.7)
    bk.take("SW2", "1", "GND")
    bk.take("SW2", "2", "BTN_EXT")
    s.wire(sw["2"], (xx, y + 12.7))
    s.label("BTN_EXT", (xx, y + 15.24), size=1.0)
    s.wire(sw["1"], (sw["1"][0] - 2.54, y + 12.7))
    s.wire((sw["1"][0] - 2.54, y + 12.7), (sw["1"][0] - 2.54, y + 16.51))
    s.rail("GND", (sw["1"][0] - 2.54, y + 16.51))
    # C27: ESD / debounce on BTN_N, across the button
    s.junction((kx - 2.54, y + 12.7))
    vdrop(s, cir, bk, "C27", kx - 2.54, y + 12.7, "GND")
    s.note("Press: BTN_N -> GND pulls LATCH_G low through D4 A2, Q4 turns "
           "on, SW_ON = VBATT enables the LDO through D2. The CPU then "
           "drives PWR_HOLD high so Q5 keeps LATCH_G low after release. "
           "Long press: firmware drops PWR_HOLD and power falls when the "
           "button is released. D4 A1 pulls PRESS_N low while pressed (the "
           "one-button block turns that into BTN_SENSE). With the board off "
           "BTN_N sits near VBATT and PRESS_N at 0V, so A1 is reverse-biased. "
           "D4 is SILICON (BAV70W), not Schottky: the off-state leaks x R24 "
           "must stay under Q4's 0.45V minimum threshold even hot. ESD: D6 "
           "clamps a strike at the pad and R30 keeps it off BTN_N/D4; C27 "
           "debounces.",
           x - 66.04, y + 58.42, 66.0)
    s.end()


def blk_onebutton(s, cir, bk, x, y):
    """(x, y) is Q8's centre. PRESS_N (from D4 in the latch block) drives
    Q8; its drain is BTN_SENSE, which charges the hold timer R28/C75; U8
    squares the timer up into LONG, which straps BOOTSEL (Q7) and kicks RUN
    (C76/R29 -> Q6)."""
    s.begin("one button: long hold = BOOTSEL / force-off")
    q8 = s.place("Q_PMOS_HS", "Q8", cir.components["Q8"].value, x, y,
                 footprint=cir.components["Q8"].footprint)
    bk.take("Q8", "1", "PRESS_N")
    bk.take("Q8", "2", "3V3")
    bk.take("Q8", "3", "BTN_SENSE")
    s.wire(q8["2"], (q8["2"][0], y - 12.7))
    s.rail("3V3", (q8["2"][0], y - 12.7))
    xg = x - 12.7
    s.wire(q8["1"], (xg - 7.62, y))
    s.glabel("PRESS_N", (xg - 7.62, y), rot=180, just="right")
    r26 = put(s, cir, "R26", xg, y - 3.81)
    bk.take("R26", "1", "3V3")
    bk.take("R26", "2", "PRESS_N")
    s.junction((xg, y))
    s.wire(r26["1"], (xg, y - 12.7))
    s.rail("3V3", (xg, y - 12.7))
    # BTN_SENSE node under the drain
    yb = y + 15.24
    xd = q8["3"][0]
    s.wire(q8["3"], (xd, yb))
    s.junction((xd, yb))
    s.wire((xd, yb), (xg - 7.62, yb))
    s.glabel("BTN_SENSE", (xg - 7.62, yb), rot=180, just="right")
    s.junction((x - 5.08, yb))
    vdrop(s, cir, bk, "R27", x - 5.08, yb, "GND")
    # R28 (timer) and D5 (reset on release) in parallel to BOOT_TMR
    xa, xt = xd + 5.08, xd + 22.86
    r28 = put(s, cir, "R28", xa + 8.89, yb, rot=90)
    bk.take("R28", "1", "BTN_SENSE")
    bk.take("R28", "2", "BOOT_TMR")
    s.wire((xd, yb), r28["1"])
    s.junction((xa, yb))
    s.wire(r28["2"], (xt, yb))
    yd = yb + 7.62
    d5 = put(s, cir, "D5", xa + 8.89, yd, rot=180, ref_off=(-4.0, 3.6))
    bk.take("D5", "1", "BTN_SENSE")
    bk.take("D5", "2", "BOOT_TMR")
    s.path((xa, yb), (xa, yd), d5["1"])
    s.path(d5["2"], (xt, yd), (xt, yb))
    s.junction((xt, yb))
    s.label("BOOT_TMR", (xt + 1.27, yb), size=1.0)
    xc = xt + 15.24
    s.junction((xc, yb))
    vdrop(s, cir, bk, "C75", xc, yb, "GND")
    # U8, pin 1 on the BOOT_TMR wire
    sx, sy = xf(*s.defs["logic_schmitt2"].pins["1"], 0)
    u8 = put(s, cir, "U8", xc + 10.16 - sx, yb - sy)
    bk.take("U8", "1", "BOOT_TMR")
    s.wire((xt, yb), u8["1"])
    bk.take("U8", "5", "3V3")
    bk.take("U8", "2", "GND")
    top = u8["5"][1]
    yv = top - 10.16
    s.wire(u8["5"], (u8["5"][0], yv))
    s.rail("3V3", (u8["5"][0], yv))
    s.wire(u8["2"], (u8["2"][0], u8["2"][1] + 3.81))
    s.rail("GND", (u8["2"][0], u8["2"][1] + 3.81))
    # LONG_N bracket 1Y -> 2A
    bk.take("U8", "6", "LONG_N")
    bk.take("U8", "3", "LONG_N")
    xbk = u8["6"][0] + 10.16
    s.label("LONG_N", (u8["6"][0] + 1.27, u8["6"][1]), size=1.0)
    # decap off the VCC wire, out to the right past the bracket
    xcv = xbk + 7.62
    s.junction((u8["5"][0], yv + 2.54))
    s.wire((u8["5"][0], yv + 2.54), (xcv, yv + 2.54))
    p77 = put(s, cir, "C77", xcv, yv + 2.54 + 3.81)
    bk.take("C77", "1", "3V3")
    bk.take("C77", "2", "GND")
    s.wire(p77["2"], (xcv, p77["2"][1] + 2.54))
    s.rail("GND", (xcv, p77["2"][1] + 2.54))
    s.path(u8["6"], (xbk, u8["6"][1]), (xbk, u8["3"][1]), u8["3"])
    # LONG: Q7 gate (strap) and C76 (RUN kick)
    bk.take("U8", "4", "LONG")
    yl = u8["4"][1]
    xl = u8["4"][0] + 12.7
    s.wire(u8["4"], (xl, yl))
    s.label("LONG", (u8["4"][0] + 1.27, yl), size=1.0)
    s.junction((xl, yl))
    q7 = put(s, cir, "Q7", xl + 17.78, yl)
    bk.take("Q7", "1", "LONG")
    bk.take("Q7", "2", "GND")
    bk.take("Q7", "3", "BOOTSEL_SW")
    s.wire((xl, yl), q7["1"])
    s.wire(q7["2"], (q7["2"][0], q7["2"][1] + 2.54))
    s.rail("GND", (q7["2"][0], q7["2"][1] + 2.54))
    s.wire(q7["3"], (q7["3"][0], q7["3"][1] - 5.08))
    s.wire((q7["3"][0], q7["3"][1] - 5.08), (q7["3"][0] + 7.62, q7["3"][1] - 5.08))
    s.glabel("BOOTSEL_SW", (q7["3"][0] + 7.62, q7["3"][1] - 5.08), size=1.0)
    c76 = put(s, cir, "C76", xl, yl + 3.81)
    bk.take("C76", "1", "LONG")
    bk.take("C76", "2", "RUN_KICK")
    yk = yl + 17.78
    s.wire(c76["2"], (xl, yk))
    s.label("RUN_KICK", (xl + 1.27, yk), size=1.0)
    xr29 = xl + 12.7
    s.junction((xr29, yk))
    vdrop(s, cir, bk, "R29", xr29, yk, "GND")
    q6 = put(s, cir, "Q6", xl + 33.02, yk)
    bk.take("Q6", "1", "RUN_KICK")
    bk.take("Q6", "2", "GND")
    bk.take("Q6", "3", "RUN")
    s.wire((xl, yk), q6["1"])
    s.wire(q6["2"], (q6["2"][0], q6["2"][1] + 2.54))
    s.rail("GND", (q6["2"][0], q6["2"][1] + 2.54))
    s.wire(q6["3"], (q6["3"][0], q6["3"][1] - 2.54))
    s.wire((q6["3"][0], q6["3"][1] - 2.54), (q6["3"][0] + 7.62, q6["3"][1] - 2.54))
    s.glabel("RUN", (q6["3"][0] + 7.62, q6["3"][1] - 2.54), size=1.0)
    s.note("Hold the power button: BTN_SENSE goes high (Q8), C75 charges "
           "through R28 and U8 trips 2.2-10.3s later (5s typ; spread is "
           "U8's VT+ and C75's X5R tolerance/bias, simulated in "
           "design/sim/button). LONG straps QSPI_SS low through Q7/R3 for "
           "as long as the button is held and kicks RUN low for ~10ms "
           "(C76/R29 -> Q6): the chip resets into BOOTSEL. Flash is not "
           "touched. On battery the reset drops PWR_HOLD, so the board turns "
           "off on release: the force-off for hung firmware. D5 empties C75 "
           "on release. Firmware: GPIO21 no pull-up, high = held; "
           "long-press-off < 2s.",
           x - 27.94, yk + 24.13, 120.0)
    s.end()


def blk_vbussense(s, cir, bk, x, y):
    """VBUS presence tap -> ADC1. Added with the rev-3 netlist but never
    drawn until now, which is why build.py --only schematic was failing."""
    s.begin("USB cable present — 10k:10k tap on VBUS -> ADC1")
    s.rail("VBUS", (x, y - 7.62))
    s.wire((x, y - 7.62), (x, y - 3.81))
    r19 = put(s, cir, "R19", x, y)
    bk.take("R19", "1", "VBUS")
    bk.take("R19", "2", "VBUS_SENSE")
    node = (x, r19["2"][1] + 3.81)
    s.wire(r19["2"], node)
    r20 = put(s, cir, "R20", x, node[1] + 3.81)
    bk.take("R20", "1", "VBUS_SENSE")
    bk.take("R20", "2", "GND")
    s.wire(node, r20["1"])
    s.wire(r20["2"], (x, r20["2"][1] + 3.81))
    s.rail("GND", (x, r20["2"][1] + 3.81))
    s.junction(node)
    s.wire(node, (x - 10.16, node[1]))
    s.glabel("VBUS_SENSE", (x - 10.16, node[1]), rot=180, just="right")
    s.note("CHRG and DONE both release at termination, so they cannot tell "
           "'unplugged' from 'plugged in and full'. 10k:10k, not the "
           "100k/1M used elsewhere: PWR_EN backfeeds through R18 and would "
           "float this node high, so the tap has to be stiff enough to "
           "swamp it (0.33V no cable, 2.2-2.75V with one). That is also "
           "what holds Q2's gate low enough to keep the battery path on.",
           x - 25.4, r20["2"][1] + 13.97, 96.0)
    s.end()


def blk_path(s, cir, bk, x, y):
    """(x, y) is Q2's centre: gate to the left, VBATT above, VSYS below."""
    s.begin("power path — VBUS runs the board when a cable is in")
    q2 = put(s, cir, "Q2", x, y)
    bk.take("Q2", "1", "PATH_GATE")
    bk.take("Q2", "2", "VSYS")
    bk.take("Q2", "3", "VBATT")
    xs, xg = x + 2.54, x - 15.24
    ys = y + 17.78
    # drain up to the cell, source down to the system rail
    s.wire(q2["3"], (xs, y - 15.24))
    s.rail("VBATT", (xs, y - 15.24))
    s.wire(q2["2"], (xs, ys))
    # gate: R22 up to VBUS, R21 down to GND. Off when a cable holds the
    # gate at VBUS (Vgs = +0.25V against VSYS); on when R19/R20 hold the
    # dead VBUS node at <=0.65V (Vgs = -2.4V at a 3.0V cell).
    s.wire(q2["1"], (xg, y))
    s.junction((xg, y))
    s.label("PATH_GATE", (xg, y), rot=180, just="right", size=1.0)
    r22 = put(s, cir, "R22", xg, y - 7.62)
    bk.take("R22", "1", "VBUS")
    bk.take("R22", "2", "PATH_GATE")
    s.wire(r22["2"], (xg, y))
    s.wire(r22["1"], (xg, y - 15.24))
    s.rail("VBUS", (xg, y - 15.24))
    # spelled out rather than vdrop()'d: R21's automatic reference text
    # lands to its right, on top of the PATH_GATE label
    r21 = put(s, cir, "R21", xg, y + 3.81, ref_off=(-9.4, 0.0))
    bk.take("R21", "1", "PATH_GATE")
    bk.take("R21", "2", "GND")
    s.wire(r21["2"], (xg, y + 11.43))
    s.rail("GND", (xg, y + 11.43))
    # VBUS -> VSYS through D3, then the VSYS row runs east past C29
    # text pushed below the part: the default spot above it lands on R21's
    # GND drop, and the row itself is the anode wire
    d3 = put(s, cir, "D3", xs - 20.32, ys, ref_off=(-6.0, 4.0))
    bk.take("D3", "2", "VBUS")
    bk.take("D3", "1", "VSYS")
    s.wire(d3["2"], (xs - 33.02, ys))
    s.wire((xs - 33.02, ys), (xs - 33.02, ys - 7.62))
    s.rail("VBUS", (xs - 33.02, ys - 7.62))
    s.wire(d3["1"], (xs, ys))
    s.junction((xs, ys))
    s.wire((xs, ys), (xs + 25.4, ys))
    s.junction((xs + 12.7, ys))
    vdrop(s, cir, bk, "C29", xs + 12.7, ys, "GND")
    s.wire((xs + 25.4, ys), (xs + 25.4, ys - 7.62))
    s.rail("VSYS", (xs + 25.4, ys - 7.62))
    s.note("Rev 2: VBATT is the cell alone, VSYS runs the board, so the "
           "charger's whole 41mA reaches the cell in either switch "
           "position. Q2's SOURCE is VSYS and its drain VBATT — a P-FET "
           "body diode conducts drain->source, so that way round it blocks "
           "USB from back-feeding the cell past the charger.",
           x - 48.26, ys + 20.32, 104.0)
    s.end()


def blk_shift(s, cir, bk, x, y):
    """Three LED data level shifters side by side, one per zone. (x, y) is
    Q3's centre: LED_DATA_<z> in from the left, LED<z>_D0 out to the right,
    each pull-up on its own zone rail."""
    s.begin("LED data level shifters — one open-drain stage per zone")
    for k, (q, r, z) in enumerate((("Q3", "R23", "L"), ("Q9", "R31", "R"),
                                   ("Q10", "R32", "C"))):
        xq = x + k * 48.26
        qq = put(s, cir, q, xq, y)
        bk.take(q, "1", f"LED_DATA_{z}")
        bk.take(q, "2", "GND")
        bk.take(q, "3", f"LED{z}_D0")
        s.wire(qq["1"], (xq - 15.24, y))
        s.glabel(f"LED_DATA_{z}", (xq - 15.24, y), rot=180, just="right")
        s.wire(qq["2"], (xq + 2.54, y + 12.7))
        s.rail("GND", (xq + 2.54, y + 12.7))
        node = (xq + 2.54, y - 15.24)
        s.wire(qq["3"], node)
        s.junction(node)
        s.wire(node, (xq + 15.24, node[1]))
        s.glabel(f"LED{z}_D0", (xq + 15.24, node[1]))
        rr = put(s, cir, r, xq + 2.54, y - 22.86)
        bk.take(r, "1", f"VLED_{z}")
        bk.take(r, "2", f"LED{z}_D0")
        s.wire(rr["2"], node)
        s.wire(rr["1"], (xq + 2.54, y - 30.48))
        s.rail(f"VLED_{z}", (xq + 2.54, y - 30.48))
    s.note("WS2816C VIH is 0.7*VDD: 2.94V on a full cell, 3.47V on a 5.25V "
           "port, above a 3.3V pad, so each zone's first pixel is driven "
           "through an open-drain inverter into a 1k pull-up on THAT zone's "
           "rail. A dark zone's pull-up is dead, so its first DI is never "
           "driven into an unpowered LED. Firmware: gpio_set_outover(pin, "
           "GPIO_OVERRIDE_INVERT) on GPIO16/17/18; one PIO program can clock "
           "all three consecutive pins.",
           x - 20.32, y + 20.32, 118.0)
    s.end()


def blk_en(s, cir, bk, x, y):
    s.begin("USB wake — VBUS feeds EN through R18")
    s.glabel("PWR_EN", (x - 10.16, y), rot=180, just="right")
    s.wire((x - 10.16, y), (x, y))
    r18 = put(s, cir, "R18", x, y - 3.81)
    bk.take("R18", "1", "VBUS")
    bk.take("R18", "2", "PWR_EN")
    s.wire(r18["1"], (x, r18["1"][1] - 2.54))
    s.rail("VBUS", (x, r18["1"][1] - 2.54))
    s.note("Rev 2: USB boots the board even with the latch off. Against "
           "R17's pulldown EN sits at ~VBUS/2, and D2's second diode "
           "clamps it to VBATT+Vf (NCP730 abs max V_EN is VIN+0.3, "
           "even during precharge of a dead cell). Firmware then sees "
           "SW_ON=0 on the sense divider and shows charge status "
           "instead of running the show.",
           x - 25.4, y + 7.62, 60.0)
    s.end()


def blk_light(s, cir, bk, x, y):
    s.begin("Ambient light sensor -> ADC0 (rev 2)")
    q = put(s, cir, "Q1", x, y)
    bk.take("Q1", "1", "3V3")
    s.wire(q["1"], (q["1"][0], q["1"][1] - 5.08))
    s.rail("3V3", (q["1"][0], q["1"][1] - 5.08))
    bk.take("Q1", "2", "LIGHT")
    # node sits 8.89 below the emitter: Q1's value text lands just under
    # the box, and a shallower node wire runs straight through it
    node = (q["2"][0], q["2"][1] + 8.89)
    s.wire(q["2"], node)
    s.wire(node, (node[0] + 12.7, node[1]))
    vdrop(s, cir, bk, "C26", node[0] + 12.7, node[1], "GND")
    s.junction((node[0] + 12.7, node[1]))
    s.wire(node, (node[0] - 10.16, node[1]))
    s.glabel("LIGHT", (node[0] - 10.16, node[1]), rot=180, just="right")
    s.junction(node)
    vdrop(s, cir, bk, "R16", node[0], node[1], "GND")
    s.note("ALS-PT19 visible-light phototransistor; 22k load -> ~0.33V "
           "@ 100 lux, saturates ~900 lux. Reads on GPIO26/ADC0.",
           x - 20.32, node[1] + 22.86, 44.0)
    s.end()


def blk_loadsw(s, cir, bk, x, y):
    """Three zone load switches stacked (U4 left, U9 right, U10 centre)."""
    s.begin("VLED zone load switches (dark zones draw zero)")
    for k, (uref, rref, cref, z) in enumerate((("U4", "R10", "C20", "L"),
                                               ("U9", "R33", "C78", "R"),
                                               ("U10", "R34", "C79", "C"))):
        yk = y + k * 40.64
        u = put(s, cir, uref, x, yk)
        bk.take(uref, "A2", "VSYS")
        s.wire(u["A2"], (u["A2"][0] - 10.16, u["A2"][1]))
        s.wire((u["A2"][0] - 10.16, u["A2"][1]),
               (u["A2"][0] - 10.16, u["A2"][1] - 6.35))
        s.rail("VSYS", (u["A2"][0] - 10.16, u["A2"][1] - 6.35))
        bk.take(uref, "A1", f"VLED_{z}")
        xo = u["A1"][0] + 12.7
        s.wire(u["A1"], (xo, u["A1"][1]))
        s.wire((xo, u["A1"][1]), (xo, u["A1"][1] - 6.35))
        s.rail(f"VLED_{z}", (xo, u["A1"][1] - 6.35))
        s.wire((xo, u["A1"][1]), (xo + 12.7, u["A1"][1]))
        s.junction((xo, u["A1"][1]))
        vdrop(s, cir, bk, cref, xo + 12.7, u["A1"][1], "GND")
        bk.take(uref, "B1", "GND")
        s.wire(u["B1"], (u["B1"][0], u["B1"][1] + 3.81))
        s.rail("GND", (u["B1"][0], u["B1"][1] + 3.81))
        bk.take(uref, "B2", f"LED_EN_{z}")
        xn = u["B2"][0] - 10.16
        s.wire(u["B2"], (xn, u["B2"][1]))
        s.junction((xn, u["B2"][1]))
        vdrop(s, cir, bk, rref, xn, u["B2"][1], "GND")
        s.wire((xn, u["B2"][1]), (xn - 7.62, u["B2"][1]))
        s.glabel(f"LED_EN_{z}", (xn - 7.62, u["B2"][1]), rot=180, just="right")
    s.note("One switch per zone: the WS2816C idles at 0.7-1.0mA per LED, so "
           "only lit zones are powered. The pull-downs hold every zone off "
           "until firmware drives its LED_EN high.",
           x - 25.4, y + 2 * 40.64 + 22.86, 76.0)
    s.end()


def blk_bank(s, cir, bk, title, refs, x, y, rail, pitch=12.7, note=None,
             rows=1):
    """Rows of identical 2-pin parts strung between a rail and ground."""
    s.begin(title)
    per = math.ceil(len(refs) / rows)
    ybot = y
    for r in range(rows):
        chunk = refs[r * per:(r + 1) * per]
        if not chunk:
            continue
        xs = [x + i * pitch for i in range(len(chunk))]
        ytop = y + r * 27.94
        ybot = ytop + 15.24
        for xi, ref in zip(xs, chunk):
            p = put(s, cir, ref, xi, ytop + 7.62, hide_value=True,
                    ref_off=(1.9, -4.0))
            bk.take(ref, "1", rail)
            bk.take(ref, "2", "GND")
            s.wire((xi, ytop), p["1"])
            s.wire(p["2"], (xi, ybot))
        s.wire((xs[0], ytop), (xs[-1], ytop))
        s.wire((xs[0], ybot), (xs[-1], ybot))
        for xi in xs[1:-1]:
            s.junction((xi, ytop))
            s.junction((xi, ybot))
        xe = xs[0] if r % 2 == 0 else xs[-1]
        s.wire((xe, ytop), (xe, ytop - 3.81))
        s.rail(rail, (xe, ytop - 3.81))
        s.wire((xe, ybot), (xe, ybot + 3.81))
        s.rail("GND", (xe, ybot + 3.81))
    if note:
        s.note(note, x, ybot + 12.7, min(160.0, per * pitch))
    s.end()


def blk_mcu(s, cir, bk, cx, cy):
    """MCU + everything wired straight to it: flash, crystal, VREG, BOOTSEL,
    RUN pull-up and the SWD test points."""
    s.begin("RP2350A")
    # both texts go above the chip: the bottom-left corner is where the
    # ground symbols land
    hw, hh = s.defs["mcu"].extent
    u = put(s, cir, "U1", cx, cy, ref_off=(-hw, -hh - 9.0))
    # --- top edge: 3V3 rail and the VDD_CORE feedback rail ---
    v33 = ["1", "11", "20", "30", "38", "45", "54", "53", "44"]
    yr = u["1"][1] - 7.62
    for p in v33:
        bk.take("U1", p, "3V3")
        s.wire(u[p], (u[p][0], yr))
    s.wire((u[v33[0]][0], yr), (u[v33[-1]][0], yr))
    for p in v33[1:-1]:
        s.junction((u[p][0], yr))
    s.wire((u[v33[0]][0], yr), (u[v33[0]][0], yr - 3.81))
    s.junction((u[v33[0]][0], yr))
    s.rail("3V3", (u[v33[0]][0], yr - 3.81))
    core = ["6", "23", "39"]
    yc = u["6"][1] - 12.7
    for p in core:
        bk.take("U1", p, "VDD_CORE")
        s.wire(u[p], (u[p][0], yc))
    s.wire((u[core[0]][0], yc), (u[core[-1]][0], yc))
    s.junction((u[core[1]][0], yc))
    s.wire((u[core[-1]][0], yc), (u[core[-1]][0], yc - 3.81))
    s.junction((u[core[-1]][0], yc))
    s.rail("VDD_CORE", (u[core[-1]][0], yc - 3.81))
    # --- bottom edge grounds ---
    # EP and VREG_PGND are one node — join them under the chip and take a
    # single ground symbol, or the two "GND" labels merge into one word
    for p in ("61", "47"):
        bk.take("U1", p, "GND")
        s.wire(u[p], (u[p][0], u[p][1] + 3.81))
    s.wire((u["61"][0], u["61"][1] + 3.81), (u["47"][0], u["47"][1] + 3.81))
    s.junction((u["47"][0], u["47"][1] + 3.81))
    s.rail("GND", (u["47"][0], u["47"][1] + 3.81))
    # --- unused GPIOs ---
    for p, net in cir.components["U1"].pins.items():
        if net == "":
            bk.take("U1", p, "")
            s.nc(u[p])
    # --- used GPIOs out to the rest of the sheet ---
    for p in ("29", "28", "27", "3", "2", "34", "9", "15", "12", "31", "32",
              "33", "42", "40", "41", "43"):
        if cir.components["U1"].pins[p] == "":
            continue  # unused in this variant: drawn NC above
        net = bk.take("U1", p)
        s.wire(u[p], (u[p][0] + 6.35, u[p][1]))
        s.glabel(net, (u[p][0] + 6.35, u[p][1]))
    # --- USB ---
    for p in ("51", "52"):
        net = bk.take("U1", p)
        s.wire(u[p], (u[p][0] - 6.35, u[p][1]))
        s.glabel(net, (u[p][0] - 6.35, u[p][1]), rot=180, just="right")
    s.end(pad=3.0)
    return u


def blk_vreg(s, cir, bk, u):
    s.begin("RP2350 core buck regulator (ds §6.3.8)")
    # VIN
    bk.take("U1", "49", "3V3")
    yv = u["49"][1] + 33.02
    s.wire(u["49"], (u["49"][0], yv))
    s.wire((u["49"][0], yv), (u["49"][0] + 22.86, yv))
    s.junction((u["49"][0] + 12.7, yv))
    s.wire((u["49"][0] + 22.86, yv), (u["49"][0] + 22.86, yv - 5.08))
    vdrop(s, cir, bk, "C11", u["49"][0] + 12.7, yv, "GND")
    s.rail("3V3", (u["49"][0] + 22.86, yv - 5.08))
    # AVDD RC filter — runs below C11's ground symbol, not through it
    bk.take("U1", "46", "VREG_AVDD")
    ya = u["46"][1] + 55.88
    s.path(u["46"], (u["46"][0], ya), (u["46"][0] + 25.4, ya))
    s.label("VREG_AVDD", (u["46"][0] + 2.54, ya), size=1.0)
    r13 = put(s, cir, "R13", u["46"][0] + 29.21, ya, rot=270)
    bk.take("R13", "2", "VREG_AVDD")
    bk.take("R13", "1", "3V3")
    s.wire((u["46"][0] + 25.4, ya), r13["2"])
    s.wire(r13["1"], (r13["1"][0] + 5.08, r13["1"][1]))
    s.rail("3V3", (r13["1"][0] + 5.08, r13["1"][1]))
    s.junction((u["46"][0] + 12.7, ya))
    s.wire((u["46"][0] + 12.7, ya), (u["46"][0] + 12.7, ya))
    vdrop(s, cir, bk, "C22", u["46"][0] + 12.7, ya, "GND")
    # LX -> inductor -> VDD_CORE, FB tied back
    bk.take("U1", "48", "VREG_LX")
    yl = u["48"][1] + 30.48
    s.wire(u["48"], (u["48"][0], yl))
    l1 = put(s, cir, "L1", u["48"][0], yl + 3.81, rot=180,
             ref_off=(-13.97, -2.0))
    bk.take("L1", "2", "VREG_LX")
    bk.take("L1", "1", "VDD_CORE")
    node = (l1["1"][0], l1["1"][1] + 5.08)
    s.wire(l1["1"], node)
    bk.take("U1", "50", "VDD_CORE")
    s.path(u["50"], (u["50"][0], node[1] + 7.62), (node[0], node[1] + 7.62),
           node)
    s.junction(node)
    # VDD_CORE bus runs left only: the FB return comes down on the right and
    # would be crossed by anything hung on that side.
    core = (("C12", -10.16), ("C13", -20.32), ("C5", -30.48),
            ("C6", -40.64))
    end = node[0] - 50.8
    s.wire(node, (end, node[1]))
    s.rail("VDD_CORE", (end, node[1] - 3.81))
    s.wire((end, node[1]), (end, node[1] - 3.81))
    for ref, dx in core:
        s.junction((node[0] + dx, node[1]))
        vdrop(s, cir, bk, ref, node[0] + dx, node[1], "GND")
    s.label("VREG_LX", (u["48"][0], yl - 2.54), rot=90, size=1.0)
    s.note("L1 dot on the VOUT (pad 1) side — ds Fig 23. C11 CIN; C12 COUT "
           "at L1; C13 the 2nd 4u7 at DVDD 23 (§6.3.8.1). C5/C6 are the 100n "
           "HF pair §6.1.3 wants on the two DVDD pins nearest the regulator "
           "— they already sat there, netted to 3V3. R13+C22 filter "
           "VREG_AVDD.",
           u["48"][0] - 55.88, node[1] + 25.4, 66.0)
    s.end()


def blk_flash(s, cir, bk, u):
    s.begin("QSPI flash (BOOTSEL strap on /CS)")
    qspi = [("60", "1"), ("56", "6"), ("57", "5"), ("59", "2"), ("58", "3"),
            ("55", "7")]
    xr = u["56"][0] - 50.8
    f = put(s, cir, "U7", xr - 10.16, q((u["60"][1] + u["55"][1]) / 2.0))
    for mp, fp in qspi:
        net = bk.take("U1", mp)
        bk.take("U7", fp, net)
        assert f[fp][1] == u[mp][1], f"flash {fp} not aligned with MCU {mp}"
        s.wire(f[fp], u[mp])
        s.label(net, (u[mp][0] - 16.51, u[mp][1]), size=1.0)
    bk.take("U7", "8", "3V3")
    x3 = f["8"][0] - 7.62
    s.path(f["8"], (x3, f["8"][1]), (x3, f["8"][1] - 6.35))
    s.rail("3V3", (x3, f["8"][1] - 6.35))
    s.junction((x3, f["8"][1]))
    s.wire((x3, f["8"][1]), (x3 - 12.7, f["8"][1]))
    vdrop(s, cir, bk, "C25", x3 - 12.7, f["8"][1], "GND")
    xg = f["4"][0] - 7.62
    for p in ("4", "9"):
        bk.take("U7", p, "GND")
        s.wire(f[p], (xg, f[p][1]))
    s.wire((xg, f["4"][1]), (xg, f["9"][1]))
    s.junction((xg, f["9"][1]))
    s.wire((xg, f["9"][1]), (xg, f["9"][1] + 3.81))
    s.rail("GND", (xg, f["9"][1] + 3.81))
    # BOOTSEL strap rises off the /CS wire, which is the top of the bus, so
    # it never has to get past the other five QSPI lines
    xb = u["60"][0] - 25.4
    s.junction((xb, u["60"][1]))
    r3 = put(s, cir, "R3", xb, u["60"][1] - 3.81, rot=180, ref_off=(4.6, -3.0))
    bk.take("R3", "1", "BOOTSEL")
    bk.take("R3", "2", "BOOTSEL_SW")
    s.wire((xb, u["60"][1]), r3["1"])
    yb = r3["2"][1]
    # the strap's switch is Q7 in the one-button block (SW1 is gone)
    s.wire(r3["2"], (xb - 10.16, yb))
    s.glabel("BOOTSEL_SW", (xb - 10.16, yb), rot=180, just="right", size=1.0)
    s.note("Pico-style: QSPI_SS is both the flash /CS and the BOOTSEL "
           "strap. Q7 (power-button long hold) pulls BOOTSEL_SW low.",
           f["8"][0] - 20.32, f["9"][1] + 17.78, 76.0)
    s.end()


def blk_xtal(s, cir, bk, u):
    s.begin("12MHz crystal")
    bk.take("U1", "21", "XIN")
    bk.take("U1", "22", "XOUT")
    xy = u["21"][0] - 48.26
    y1 = put(s, cir, "Y1", xy, u["21"][1] + 3.81, rot=270)
    bk.take("Y1", "1", "XIN")
    bk.take("Y1", "3", "XTAL_R")
    bk.take("Y1", "2", "GND")
    bk.take("Y1", "4", "GND")
    assert y1["1"][1] == u["21"][1]
    s.wire(y1["1"], u["21"])
    s.label("XIN", (y1["1"][0] + 10.16, y1["1"][1]), size=1.0)
    s.wire(y1["2"], (y1["2"][0] - 6.35, y1["2"][1]))
    s.rail("GND", (y1["2"][0] - 6.35, y1["2"][1]))
    # load caps hang to the left, clear of the crystal body
    s.path(y1["1"], (y1["1"][0], y1["1"][1] - 2.54),
           (y1["1"][0] - 20.32, y1["1"][1] - 2.54))
    s.junction(y1["1"])
    vdrop(s, cir, bk, "C14", y1["1"][0] - 20.32, y1["1"][1] - 2.54, "GND")
    s.path(y1["3"], (y1["3"][0], y1["3"][1] + 10.16),
           (y1["3"][0] - 35.56, y1["3"][1] + 10.16))
    vdrop(s, cir, bk, "C15", y1["3"][0] - 35.56, y1["3"][1] + 10.16, "GND")
    s.junction(y1["3"])
    # XOUT returns through the series resistor, under the XIN wire
    r1 = put(s, cir, "R1", y1["3"][0] + 12.7, y1["3"][1], rot=90)
    bk.take("R1", "1", "XTAL_R")
    bk.take("R1", "2", "XOUT")
    s.wire(y1["3"], r1["1"])
    s.label("XTAL_R", (y1["3"][0] + 1.27, y1["3"][1]), size=1.0)
    s.path(r1["2"], (u["22"][0] - 7.62, r1["2"][1]),
           (u["22"][0] - 7.62, u["22"][1]), u["22"])
    s.label("XOUT", (u["22"][0] - 6.35, u["22"][1]), size=1.0)
    s.note("ABM8-272-T3, CL 10pF / ESR<=50R — the 15p caps and R1 are "
           "matched to it; do not retune.",
           y1["1"][0] - 40.64, y1["3"][1] + 33.02, 74.0)
    s.end()


def blk_sys(s, cir, bk, u):
    s.begin("RUN / SWD")
    bk.take("U1", "26", "RUN")
    xn = u["26"][0] - 20.32
    s.wire(u["26"], (xn, u["26"][1]))
    r2 = put(s, cir, "R2", xn, u["26"][1] - 3.81, rot=180)
    bk.take("R2", "1", "RUN")
    bk.take("R2", "2", "3V3")
    s.wire(r2["2"], (xn, r2["2"][1] - 3.81))
    s.rail("3V3", (xn, r2["2"][1] - 3.81))
    s.junction((xn, u["26"][1]))
    s.label("RUN", (xn + 5.08, u["26"][1]), size=1.0)
    # values are hidden: each stub already carries its net label
    tp1 = put(s, cir, "TP1", xn - 12.7, u["26"][1], rot=90, hide_value=True)
    bk.take("TP1", "1", "RUN")
    s.wire((xn, u["26"][1]), tp1["1"])
    for ref, pin in (("TP2", "24"), ("TP3", "25")):
        net = bk.take("U1", pin)
        bk.take(ref, "1", net)
        tp = put(s, cir, ref, xn - 12.7, u[pin][1], rot=90,
                 hide_value=True)
        s.wire(tp["1"], u[pin])
        s.label(net, (xn, u[pin][1]), size=1.0)
    s.end()


def blk_imu(s, cir, bk, x, y):
    s.begin("IMU — LSM6DS3TR-C on I2C1 (addr 0x6A)")
    u = put(s, cir, "U6", x, y)
    # rails
    for p in ("8", "5"):
        bk.take("U6", p, "3V3")
        s.wire(u[p], (u[p][0], u[p][1] - 5.08))
    s.wire((u["8"][0], u["8"][1] - 5.08), (u["5"][0], u["5"][1] - 5.08))
    s.wire((u["8"][0], u["8"][1] - 5.08), (u["8"][0], u["8"][1] - 8.89))
    s.junction((u["8"][0], u["8"][1] - 5.08))
    s.rail("3V3", (u["8"][0], u["8"][1] - 8.89))
    for p in ("6", "7"):
        bk.take("U6", p, "GND")
        s.wire(u[p], (u[p][0], u[p][1] + 3.81))
    s.wire((u["6"][0], u["6"][1] + 3.81), (u["7"][0], u["7"][1] + 3.81))
    s.wire((u["6"][0], u["6"][1] + 3.81), (u["6"][0], u["6"][1] + 6.35))
    s.junction((u["6"][0], u["6"][1] + 3.81))
    s.rail("GND", (u["6"][0], u["6"][1] + 6.35))
    # mode straps on the right: CS high selects I2C, SDx/SCx idle the
    # unused aux master. All three go to VDDIO = 3V3.
    xs = u["12"][0] + 15.24
    for p in ("12", "2", "3"):
        bk.take("U6", p, "3V3")
        s.wire(u[p], (xs, u[p][1]))
    s.wire((xs, u["12"][1]), (xs, u["3"][1]))
    s.wire((xs, u["12"][1]), (xs, u["12"][1] - 5.08))
    s.junction((xs, u["12"][1]))
    s.junction((xs, u["2"][1]))
    s.rail("3V3", (xs, u["12"][1] - 5.08))
    bk.take("U6", "1", "GND")
    s.wire(u["1"], (u["1"][0] + 6.35, u["1"][1]))
    s.rail("GND", (u["1"][0] + 6.35, u["1"][1]))
    for p in ("9", "10", "11"):
        bk.take("U6", p, "")
        s.nc(u[p])
    # I2C + interrupt, with the bus pull-ups
    # Both pull-ups stand above the two bus lines, and SDA (the upper line)
    # stops short of SCL's resistor so no wire is drawn across a symbol.
    for p, ref, dx, dl in (("14", "R14", 15.24, 17.78),
                           ("13", "R15", 33.02, 43.18)):
        net = bk.take("U6", p)
        xn = u[p][0] - dx
        s.wire(u[p], (xn, u[p][1]))
        s.junction((xn, u[p][1]))
        r = put(s, cir, ref, xn, u[p][1] - 3.81, rot=180)
        bk.take(ref, "1", net)
        bk.take(ref, "2", "3V3")
        s.wire(r["2"], (xn, r["2"][1] - 3.81))
        s.rail("3V3", (xn, r["2"][1] - 3.81))
        s.wire((xn, u[p][1]), (u[p][0] - dl, u[p][1]))
        s.glabel(net, (u[p][0] - dl, u[p][1]), rot=180, just="right")
    net = bk.take("U6", "4")
    s.wire(u["4"], (u["4"][0] - 7.62, u["4"][1]))
    s.glabel(net, (u["4"][0] - 7.62, u["4"][1]), rot=180, just="right")
    # decoupling — its own rail stubs, clear of the pin escapes on every side
    for i, ref in enumerate(("C23", "C24")):
        cx = u["7"][0] + 15.24 + i * 12.7
        ytop = u["7"][1] + 10.16
        s.rail("3V3", (cx, ytop - 3.81))
        s.wire((cx, ytop - 3.81), (cx, ytop))
        vdrop(s, cir, bk, ref, cx, ytop, "GND")
    s.note("CS/SDx/SCx -> VDDIO selects I2C mode 1 and idles the aux "
           "master; SDO/SA0 -> GND sets address 0x6A.",
           x - 27.94, u["6"][1] + 30.48, 96.0)
    s.end()


def blk_leds(s, cir, bk, design, x, y, per_row, pitch):
    from circuit import led_zones
    n = design["leds"]["count"]
    s.begin(f"Addressable LED ring — {n} x WS2816C-1313 in three zone chains")
    zones = led_zones(design)
    rows = []
    for z, chain in zones.items():
        for r0 in range(0, len(chain), per_row):
            rows.append((z, chain[r0:r0 + per_row]))
    ext_w = s.defs["led"].extent[0]
    ext_h = s.defs["led"].extent[1]
    gap = pitch - 2 * ext_w
    assert gap >= 7.62, (f"LED pitch {pitch} leaves only {gap:.1f}mm between "
                         "boxes — no room for the chain label")
    rowh = 2 * ext_h + 30.48
    for r, (z, idx) in enumerate(rows):
        cy = y + r * rowh
        ytop, ybot = cy - ext_h - 5.08, cy + ext_h + 5.08
        for k, i in enumerate(idx):
            ref = f"LED{i}"
            xi = x + k * pitch
            p = put(s, cir, ref, xi, cy, hide_value=True,
                    ref_off=(-9.0, -8.4))
            bk.take(ref, "1", f"VLED_{z}")
            bk.take(ref, "3", "GND")
            s.wire(p["1"], (xi, ytop))
            s.wire(p["3"], (xi, ybot))
            if k:
                s.junction((xi, ytop))
                s.junction((xi, ybot))
            din = bk.take(ref, "4")
            dout = bk.take(ref, "2")
            if k:
                prev = f"LED{idx[k - 1]}"
                assert cir.components[prev].pins["2"] == din
                s.wire((xi - pitch + ext_w, cy), p["4"])
                s.label(din, (xi - pitch + ext_w + 1.27, cy), size=1.0)
            else:
                s.wire(p["4"], (xi - ext_w - 3.81, cy))
                s.glabel(din, (xi - ext_w - 3.81, cy), rot=180, just="right")
            if k == len(idx) - 1:
                if dout:
                    s.wire(p["2"], (xi + ext_w + 3.81, cy))
                    s.glabel(dout, (xi + ext_w + 3.81, cy))
                else:
                    s.nc(p["2"])
        xa, xb = x, x + (len(idx) - 1) * pitch
        s.wire((xa, ytop), (xb, ytop))
        s.wire((xa, ybot), (xb, ybot))
        s.wire((xa, ytop), (xa, ytop - 3.81))
        s.rail(f"VLED_{z}", (xa, ytop - 3.81))
        s.wire((xa, ybot), (xa, ybot + 3.81))
        s.rail("GND", (xa, ybot + 3.81))
    s.note("Three independent chains, each with its own switched rail: left "
           "LED1->LED18, right LED37->LED19 (entering at the tip chevron), "
           "centre LED38->LED45. A dark zone is unpowered, so data never "
           "crosses a zone boundary; each row break carries on through "
           "LED<z>_D<n>.",
           x - 8.89, y + (len(rows) - 1) * rowh + 24.13, 320.0, size=1.6)
    s.end()


def blk_driver(s, cir, bk, x, y):
    """Variant B: the IS31FL3741A, its I2C0/SDB/INTB to the MCU and RISET.
    (x, y) is U11's centre. The matrix lines leave on the right as labels
    that the matrix block picks up; unused SW/CS pins are NC."""
    s.begin("LED matrix driver — IS31FL3741A (variant B)")
    hw, hh = s.defs["matrix_driver"].extent
    u = put(s, cir, "U11", x, y, hide_value=True, ref_off=(-hw, -hh - 9.0))
    pins = cir.components["U11"].pins
    # supply pins up to one VSYS rail
    yr = u["15"][1] - 7.62
    for p in ("15", "25", "14"):
        bk.take("U11", p, "VSYS")
        s.wire(u[p], (u[p][0], yr))
    s.wire((u["15"][0], yr), (u["14"][0], yr))
    s.junction((u["25"][0], yr))
    s.wire((u["15"][0], yr), (u["15"][0], yr - 3.81))
    s.junction((u["15"][0], yr))
    s.rail("VSYS", (u["15"][0], yr - 3.81))
    # grounds joined under the chip
    gnd = ("12", "36", "55", "61")
    yg = u["12"][1] + 3.81
    for p in gnd:
        bk.take("U11", p, "GND")
        s.wire(u[p], (u[p][0], yg))
    s.wire((u[gnd[0]][0], yg), (u[gnd[-1]][0], yg))
    for p in gnd[1:-1]:
        s.junction((u[p][0], yg))
    s.wire((u[gnd[-1]][0], yg), (u[gnd[-1]][0], yg + 3.81))
    s.junction((u[gnd[-1]][0], yg))
    s.rail("GND", (u[gnd[-1]][0], yg + 3.81))
    # left: bus + control. Pull-ups sit on the stubs, rails above.
    xl = u["9"][0] - 48.26
    for p, net, rref in (("9", "DRV_SDA", "R38"), ("10", "DRV_SCL", "R39"),
                         ("7", "DRV_INTB", "R37")):
        bk.take("U11", p, net)
        s.wire(u[p], (xl, u[p][1]))
        s.glabel(net, (xl, u[p][1]), rot=180, just="right")
    # Pull-ups as their own row above the chip, each joined by its net
    # label: drawn on the bus stubs, the lower rows' wires would cross the
    # upper rows.
    for k, (p, rref) in enumerate((("9", "R38"), ("10", "R39"), ("7", "R37"))):
        net = cir.components[rref].pins["1"]
        s.label(net, (u[p][0] - 7.62, u[p][1]), size=1.0)
        xr = u["9"][0] - 40.64 + 10.16 * k
        yb = yr - 20.32
        r = put(s, cir, rref, xr, yb - 3.81, rot=180)
        bk.take(rref, "1", net)
        bk.take(rref, "2", "3V3")
        s.wire(r["1"], (xr, yb + 2.54))
        s.label(net, (xr, yb + 2.54), rot=270, size=1.0)
        s.wire(r["2"], (xr, r["2"][1] - 3.81))
        s.rail("3V3", (xr, r["2"][1] - 3.81))
    # SDB: 100k + 100n to GND, from the MCU
    bk.take("U11", "11", "DRV_SDB")
    s.wire(u["11"], (xl, u["11"][1]))
    s.glabel("DRV_SDB", (xl, u["11"][1]), rot=180, just="right")
    for k, ref in enumerate(("R36", "C87")):
        xs = u["11"][0] - 30.48 - 7.62 * k
        s.junction((xs, u["11"][1]))
        vdrop(s, cir, bk, ref, xs, u["11"][1], "GND")
    # ISET and ADDR
    bk.take("U11", "13", "DRV_ISET")
    xi = u["13"][0] - 15.24
    s.wire(u["13"], (xi, u["13"][1]))
    s.label("DRV_ISET", (u["13"][0] - 8.89, u["13"][1]), size=0.9)
    vdrop(s, cir, bk, "R35", xi, u["13"][1], "GND")
    bk.take("U11", "8", "GND")
    s.wire(u["8"], (u["8"][0] - 3.81, u["8"][1]))
    s.wire((u["8"][0] - 3.81, u["8"][1]), (u["8"][0] - 3.81, u["8"][1] + 7.62))
    s.rail("GND", (u["8"][0] - 3.81, u["8"][1] + 7.62))
    # right: matrix lines as labels, unused pins NC
    for p, net in pins.items():
        if ("U11", p) in bk.seen:
            continue
        if net == "":
            bk.take("U11", p, "")
            s.nc(u[p])
        elif net.startswith(("SW", "CS")):
            bk.take("U11", p, net)
            s.wire(u[p], (u[p][0] + 5.08, u[p][1]))
            s.label(net, (u[p][0] + 5.08, u[p][1]), size=1.0)
    s.note("ADDR to GND: I2C address 0x30. SDB's 100k holds the driver in "
           "shutdown (0.5uA) until firmware raises GPIO18. RISET sets the "
           "full-scale CS current; firmware's GCC and per-LED scaling set the "
           "dim range (design/parts/is31fl3741a.md).",
           x - hw - 20.32, y + hh + 15.24, 70.0)
    s.end()
    return u


def blk_driver_aw(s, cir, bk, x, y):
    """Variant C: the AW20198QNR, its I2C0/EN to the MCU and REXT. (x, y) is
    U11's centre. The matrix lines leave on the right as labels that the
    matrix block picks up; unused SW/CS pins are NC."""
    s.begin("LED matrix driver — AW20198QNR (variant C)")
    hw, hh = s.defs["matrix_driver_aw"].extent
    u = put(s, cir, "U11", x, y, hide_value=True, ref_off=(-hw, -hh - 9.0))
    pins = cir.components["U11"].pins
    # PVCC and VCC up to one VSYS rail (ds note 2: the same supply)
    yr = u["5"][1] - 7.62
    for p in ("5", "22"):
        bk.take("U11", p, "VSYS")
        s.wire(u[p], (u[p][0], yr))
    s.wire((u["5"][0], yr), (u["22"][0], yr))
    s.wire((u["5"][0], yr), (u["5"][0], yr - 3.81))
    s.junction((u["5"][0], yr))
    s.rail("VSYS", (u["5"][0], yr - 3.81))
    # grounds joined under the chip
    gnd = ("23", "16", "41")
    yg = u["23"][1] + 3.81
    for p in gnd:
        bk.take("U11", p, "GND")
        s.wire(u[p], (u[p][0], yg))
    s.wire((u[gnd[0]][0], yg), (u[gnd[-1]][0], yg))
    for p in gnd[1:-1]:
        s.junction((u[p][0], yg))
    s.wire((u[gnd[-1]][0], yg), (u[gnd[-1]][0], yg + 3.81))
    s.junction((u[gnd[-1]][0], yg))
    s.rail("GND", (u[gnd[-1]][0], yg + 3.81))
    # left: bus + EN. Pull-ups as their own row above the chip, each joined
    # by its net label (see blk_driver).
    xl = u["28"][0] - 48.26
    for p, net in (("28", "DRV_SDA"), ("27", "DRV_SCL")):
        bk.take("U11", p, net)
        s.wire(u[p], (xl, u[p][1]))
        s.glabel(net, (xl, u[p][1]), rot=180, just="right")
    for k, (p, rref) in enumerate((("28", "R38"), ("27", "R39"))):
        net = cir.components[rref].pins["1"]
        s.label(net, (u[p][0] - 7.62, u[p][1]), size=1.0)
        xr = u["28"][0] - 40.64 + 10.16 * k
        yb = yr - 20.32
        r = put(s, cir, rref, xr, yb - 3.81, rot=180)
        bk.take(rref, "1", net)
        bk.take(rref, "2", "3V3")
        s.wire(r["1"], (xr, yb + 2.54))
        s.label(net, (xr, yb + 2.54), rot=270, size=1.0)
        s.wire(r["2"], (xr, r["2"][1] - 3.81))
        s.rail("3V3", (xr, r["2"][1] - 3.81))
    # EN: from the MCU, 100n to GND (ds Figure 1 C5); the 1M pull-down is inside
    bk.take("U11", "26", "DRV_EN")
    s.wire(u["26"], (xl, u["26"][1]))
    s.glabel("DRV_EN", (xl, u["26"][1]), rot=180, just="right")
    xs = u["26"][0] - 30.48
    s.junction((xs, u["26"][1]))
    vdrop(s, cir, bk, "C87", xs, u["26"][1], "GND")
    # ISET (REXT) and the address straps
    bk.take("U11", "29", "DRV_ISET")
    xi = u["29"][0] - 15.24
    s.wire(u["29"], (xi, u["29"][1]))
    s.label("DRV_ISET", (u["29"][0] - 8.89, u["29"][1]), size=0.9)
    vdrop(s, cir, bk, "R35", xi, u["29"][1], "GND")
    xa = u["25"][0] - 3.81
    for p in ("25", "24"):
        bk.take("U11", p, "GND")
        s.wire(u[p], (xa, u[p][1]))
    s.wire((xa, u["25"][1]), (xa, u["24"][1] + 3.81))
    s.junction((xa, u["24"][1]))
    s.rail("GND", (xa, u["24"][1] + 3.81))
    # right: matrix lines as labels; unused pins (SYNC too) NC
    for p, net in pins.items():
        if ("U11", p) in bk.seen:
            continue
        if net == "":
            bk.take("U11", p, "")
            s.nc(u[p])
        elif net.startswith(("SW", "CS")):
            bk.take("U11", p, net)
            s.wire(u[p], (u[p][0] + 5.08, u[p][1]))
            s.label(net, (u[p][0] + 5.08, u[p][1]), size=1.0)
    s.note("AD0/AD1 to GND: I2C address 0x20. EN's internal 1M pull-down "
           "holds the driver in standby (1.3uA) until firmware raises GPIO18. "
           "REXT sets Imax = 400 V / REXT; GCC and per-LED SL set the dim "
           "range (design/parts/aw20198qnr.md).",
           x - hw - 20.32, y + hh + 15.24, 70.0)
    s.end()
    return u


def blk_matrix(s, cir, bk, design, x, y, pitch=22.86, rowh=27.94):
    """Variant B: the LEDs as their SW x CS grid. One row per SW line (its
    anodes on one wire), three CS labels under each LED."""
    from circuit import led_matrix, RGB_LEDS
    lm = led_matrix(design)
    led = RGB_LEDS[design["leds"].get("part", "rgb_led")]
    pa = str(led["pin"]["A"])
    pk = [str(led["pin"][c]) for c in "RGB"]
    nsw = max(sw for sw, _ in lm.values())
    s.begin(f"LED matrix — {len(lm)} x {led['value']}, {nsw} SW x "
            f"{3 * design['leds']['matrix']['per_sw']} CS")
    rows = {}
    for i, (sw, cs) in sorted(lm.items()):
        rows.setdefault(sw, []).append((i, cs))
    for r, (sw, leds) in enumerate(sorted(rows.items())):
        cy = y + r * rowh
        for k, (i, cs) in enumerate(leds):
            ref = f"LED{i}"
            xi = x + k * pitch
            p = put(s, cir, ref, xi, cy, hide_value=True, ref_off=(3.0, -6.5))
            ya = p[pa][1] - 3.81
            bk.take(ref, pa, f"SW{sw}")
            s.wire(p[pa], (p[pa][0], ya))
            if k < len(leds) - 1:   # the row wire starts left of LED 0
                s.junction((p[pa][0], ya))
            for pin, c in zip(pk, cs):
                bk.take(ref, pin, f"CS{c}")
                s.wire(p[pin], (p[pin][0], p[pin][1] + 3.81))
                s.label(f"CS{c}", (p[pin][0], p[pin][1] + 3.81), rot=270,
                        size=0.9)
        xa = x - 7.62
        xs = [x + k * pitch for k in range(len(leds))]
        s.wire((xa, ya), (xs[-1], ya))
        s.label(f"SW{sw}", (xa, ya), size=1.0)
    s.note("Each row's anodes share one SW line; the k-th LED of every row "
           "shares CS 3k+1..3k+3 (R, G, B). On the board a row is an arc of "
           "adjacent LEDs and the CS lines run as a bus round the ring.",
           x - 7.62, y + nsw * rowh + 2.54, 110.0)
    s.end()


# ---------------------------------------------------------------------------
def build_sheet(design, cir):
    s = Sch()
    s.defpassives()
    s.defbox("mcu", "RP2350A", mcu_sides())
    for part, sides in IC_SIDES.items():
        c = next((c for c in cir.components.values() if c.part == part), None)
        if c is None:
            continue  # not in this variant
        s.defbox(part, c.value, sides, min_w=IC_MIN_W.get(part, 0.0))
    bk = Book(cir.components)

    s.text("simple_earring — generated schematic", 16, 15, size=4.0,
           bold=True, frame=False)
    s.text(f"{len(cir.components)} components / {len(cir.nets)} nets / "
           f"{design['board']['layers']}-layer JLCPCB stackup.  "
           "Power rails (GND, 3V3, VBATT, VSYS, VLED, VBUS, VDD_CORE) are "
           "power "
           "symbols; only cross-block signals use global labels.  "
           "Generated from scripts/circuit.py — do not hand-edit; rebuild "
           "with `python3 build.py --only schematic`.",
           16, 21, size=1.8, frame=False)

    # Anchors are packed by hand against the measured block boxes; run with
    # SCH_LAYOUT=1 to print them when a netlist change resizes something.
    blk_usb(s, cir, bk, 30, 86)
    blk_charger(s, cir, bk, 58, 196)
    blk_sense(s, cir, bk, 164, 164)
    blk_ldo(s, cir, bk, 190, 59)
    matrix = design["leds"].get("drive") == "matrix"   # variant B
    if not matrix:
        blk_loadsw(s, cir, bk, 640, 340)  # three zones: moved to open sheet
    blk_en(s, cir, bk, 272, 40)
    blk_latch(s, cir, bk, LATCH_AT[0], LATCH_AT[1])
    blk_onebutton(s, cir, bk, ONEBTN_AT[0], ONEBTN_AT[1])
    # rev-2 power path + its two satellites: the path sits under the
    # sense/load-switch column, the VBUS tap under the charger it taps,
    # and the level shifter beside the ring it drives
    blk_path(s, cir, bk, 189.3, 254.4)
    blk_vbussense(s, cir, bk, 620.4, 118.2)
    if not matrix:
        blk_shift(s, cir, bk, 468.3, 391.1)
    blk_light(s, cir, bk, 232, 176)
    blk_imu(s, cir, bk, 510, 137)

    mcx, mcy = 406.0, 136.0
    u = blk_mcu(s, cir, bk, mcx, mcy)
    blk_bank(s, cir, bk, "MCU decoupling — 100n on the 3V3 supply pins",
             [f"C{i}" for i in (1, 2, 3, 4, 7, 8, 9)], 466.0, 48.0, "3V3",
             note="IOVDD 38 and 1 share with C3/C4 — C5/C6 went to the "
                  "core rail (see the regulator block)")
    blk_vreg(s, cir, bk, u)
    blk_flash(s, cir, bk, u)
    blk_xtal(s, cir, bk, u)
    blk_sys(s, cir, bk, u)

    def ring_caps(rail):
        return sorted((r for r in cir.components
                       if r.startswith("C") and r[1:].isdigit()
                       and 30 <= int(r[1:]) < 75
                       and cir.components[r].pins.get("1") == rail),
                      key=lambda r: int(r[1:]))  # C75+ are not ring caps
    if matrix and cir.components["U11"].value == "AW20198QNR":
        blk_driver_aw(s, cir, bk, 250.0, 440.0)
        blk_bank(s, cir, bk, "Driver supply — 1u + 100n at PVCC and at VCC, "
                 "bulk on VSYS", ["C80", "C81", "C82", "C83", "C86"],
                 310.0, 330.0, "VSYS", pitch=11.43,
                 note="at U11's PVCC (5) and VCC (22) pins")
        blk_matrix(s, cir, bk, design, 42.0, 336.0)
    elif matrix:
        blk_driver(s, cir, bk, 250.0, 440.0)
        blk_bank(s, cir, bk, "Driver supply — 1u + 100n per PVCC/AVCC pin, "
                 "bulk on VSYS", ["C80", "C81", "C82", "C83", "C84", "C85",
                                  "C86"], 310.0, 330.0, "VSYS", pitch=11.43,
                 note="at U11's PVCC (15, 25) and AVCC (14) pins")
        blk_matrix(s, cir, bk, design, 42.0, 336.0)
    else:
        blk_leds(s, cir, bk, design, 42.0, 336.0, 15, 26.67)
        for k, (z, name) in enumerate((("L", "left"), ("R", "right"),
                                       ("C", "centre"))):
            blk_bank(s, cir, bk,
                     f"LED bypass, {name} zone — 100n VLED_{z}-GND, one per two LEDs",
                     ring_caps(f"VLED_{z}"), *BANK_AT[z], f"VLED_{z}", pitch=11.43,
                     rows=1, note="next to their LEDs around the ring" if k == 0 else None)

    bk.report()
    s.check_frames(verbose=bool(os.environ.get("SCH_LAYOUT")))
    clashes = s.check_text(verbose=bool(os.environ.get("SCH_LAYOUT")))
    if clashes and os.environ.get("SCH_ALLOW_TEXT_CLASH"):
        print(f"  WARNING: {len(clashes)} text clashes, emitted anyway")
        for m in clashes:
            print("    " + m)
        clashes = []
    assert not clashes, (f"{len(clashes)} text clashes — a reference, value "
                         "or note lands on a wire or on other text "
                         "(SCH_LAYOUT=1 lists them, SCH_ALLOW_TEXT_CLASH=1 "
                         "emits anyway):\n  " + "\n  ".join(clashes))
    placed = {r for r in s.refs if not r.startswith("#PWR")}
    missing = sorted(set(cir.components) - placed)
    assert not missing, f"components not drawn: {missing}"
    return s


# ---------------------------------------------------------------------------
def verify_netlist(cir):
    """Round-trip the finished sheet through KiCad and diff it against
    circuit.py. This is what makes the hand-authored layout trustworthy."""
    xml = OUTDIR / "earring-netlist.xml"
    r = subprocess.run(["kicad-cli", "sch", "export", "netlist",
                        "--format", "kicadxml", "-o", str(xml), str(OUT)],
                       capture_output=True, text=True)
    if r.returncode:
        print("  WARNING: netlist export failed, cannot verify:",
              r.stderr.strip())
        return False
    root = ET.parse(xml).getroot()
    got = defaultdict(set)
    for net in root.find("nets"):
        name = net.get("name")
        for node in net.findall("node"):
            got[name].add((node.get("ref"), node.get("pin")))
    want = defaultdict(set)
    for ref, c in cir.components.items():
        for pad, net in c.pins.items():
            if net:
                want[net].add((ref, pad))
    # KiCad names unlabelled nets by position; ours are all named, but the
    # comparison is by pin-set so auto-names on single-pin nets don't matter.
    got_sets = {frozenset(v): k for k, v in got.items() if len(v) > 1}
    problems = []
    for net, pins in sorted(want.items()):
        fs = frozenset(pins)
        if fs in got_sets:
            if got_sets[fs] != net:
                problems.append(f"net {net}: drawn as {got_sets[fs]!r}")
            continue
        drawn = got.get(net)
        if drawn is None:
            problems.append(f"net {net}: missing from the sheet entirely")
        else:
            extra = drawn - pins
            short = pins - drawn
            if extra:
                problems.append(f"net {net}: sheet also has "
                                + ", ".join(f"{a}.{b}" for a, b in sorted(extra)))
            if short:
                problems.append(f"net {net}: sheet is missing "
                                + ", ".join(f"{a}.{b}" for a, b in sorted(short)))
    xml.unlink(missing_ok=True)
    if problems:
        print("  NETLIST MISMATCH (sheet vs circuit.py):")
        for p in problems[:80]:
            print("   ", p)
        raise SystemExit(1)
    print(f"  netlist verified against circuit.py: {len(want)} nets match")
    return True


BANK_AT = {"L": (730.0, 325.0), "R": (730.0, 381.0), "C": (730.0, 437.0)}
LATCH_AT = (668.0, 213.0)  # below the VBUS tap; placed against the measured frames
ONEBTN_AT = (760.0, 213.0)


def main():
    design = load_design()
    cir = build_circuit(design)
    s = build_sheet(design, cir)
    OUT.parent.mkdir(parents=True, exist_ok=True)
    OUTDIR.mkdir(exist_ok=True)
    OUT.write_text(s.render())
    print(f"wrote {OUT}: {len(s.defs)} symbols, {len(cir.components)} "
          f"components, {len(cir.nets)} nets, {len(s.frames)} blocks")

    pro = OUT.parent / "earring.kicad_pro"
    if pro.exists():
        import json
        d = json.loads(pro.read_text())
        want = [[str(SHEET_UUID), ""]]
        if d.get("sheets") != want:
            d["sheets"] = want
            pro.write_text(json.dumps(d, indent=2))
            print(f"  registered root sheet in {pro.name}")

    verify_netlist(cir)
    for args, label in (
            (["--exclude-drawing-sheet", "-o", str(OUTDIR)], "svg"),
            (["-o", str(OUTDIR / "earring-schematic.pdf")], "pdf")):
        r = subprocess.run(["kicad-cli", "sch", "export", label] + args
                           + [str(OUT)], capture_output=True, text=True)
        if r.returncode:
            print(f"  WARNING: {label} export failed: {r.stderr.strip()}")


if __name__ == "__main__":
    main()
