sequoia-hope/simple-earring/scripts/route.py

#!/usr/bin/env python3
"""Routing pipeline.

1. Wipe existing tracks/vias/zones (idempotent).
2. Scripted, locked routing for the regular structures:
   - LED daisy-chain as constant-radius arcs on F.Cu
   - via drops: every LED VDD pad -> its zone's In2 VLED_<z> piece, GND pad -> In1 plane
   - bypass cap via drops
   - GND stitching vias
3. Zones: In1=GND plane, In2=VLED_L/R/C pieces + 3V3 disc, F/B GND pours.
4. Outer GND pours, the VREG pours transplanted from the official board,
   zone fill + save: the placed, pre-routed board.
5. ultraroute for every remaining net, with the recipe in
   route/earring/recipe.json, from the pinned vendor/ultraroute
   (scripts/route.sh builds it; $ULTRAROUTE overrides the binary). The
   RP2350 power pours and U1 become a group (block) the router keeps whole.
   Then refill zones, save, report unconnected.

Run with --no-autoroute (or the old --no-freeroute) to stop after step 4.
Much of the commentary below is from the freerouting era (the pipeline
used freerouting until 2026-10-29); the positions it explains still stand.

LiPo change (2026-10-22): the coin clip BT1 is gone, and with it the two
rules it imposed: no vias on the clip feet (|x| 10.2..14.3, |y| < 3.3) and
no through vias inside r 4.6 (the Ø8 GND contact pad covered the back
there). Both are removed below. Many comments in this file still explain a
locked via's position as "r > 4.6" or "west of the clip pad". That is why
those spots were chosen; they are still legal, just no longer forced.
"""
import math
import subprocess
import sys
from pathlib import Path

import pcbnew

sys.path.insert(0, str(Path(__file__).resolve().parent))
from circuit import LED_PIN, load_design  # noqa: E402

ROOT = Path(__file__).resolve().parent.parent
from paths import PCB  # noqa: E402
from paths import RECIPE  # noqa: E402  (per variant)
ROUTE_SH = ROOT / "scripts" / "route.sh"
ULTRAROUTE = ROOT / "vendor" / "ultraroute"
# the RP2350 power block (ultraroute job earring-kicad-locked): these pours
# and U1 are grouped so the router keeps the pours as planes and U1 still
BLOCK = ("rp2350_power", ["vreg_vdd_core_3", "vreg_vdd_core_6", "vreg_3v3_1",
                          "vreg_3v3_7"], ["U1"])
CX, CY = 100.0, 100.0


def mm(v):
    return pcbnew.FromMM(v)


def to_mm(iu):
    return pcbnew.ToMM(iu)


def vec(x, y):
    return pcbnew.VECTOR2I(mm(CX + x), mm(CY + y))


def rel(p):
    """VECTOR2I -> center-relative mm tuple"""
    return (to_mm(p.x) - CX, to_mm(p.y) - CY)


def radius(p):
    x, y = rel(p)
    return math.hypot(x, y)


class Router:
    def __init__(self, board, design):
        self.board = board
        self.design = design
        self.j = design["jlcpcb"]
        self.nets = {}

    def net(self, name):
        if name not in self.nets:
            ni = self.board.FindNet(name)
            assert ni is not None, f"net {name} not found"
            self.nets[name] = ni
        return self.nets[name]

    def track(self, a, b, netname, layer=pcbnew.F_Cu, width=None, locked=True):
        t = pcbnew.PCB_TRACK(self.board)
        t.SetStart(a if isinstance(a, pcbnew.VECTOR2I) else vec(*a))
        t.SetEnd(b if isinstance(b, pcbnew.VECTOR2I) else vec(*b))
        t.SetLayer(layer)
        t.SetWidth(mm(width or self.j["default_track_mm"]))
        t.SetNet(self.net(netname))
        t.SetLocked(locked)
        self.board.Add(t)
        return t

    def arc(self, a, b, netname, layer=pcbnew.F_Cu, width=None, locked=True,
            nseg=4):
        """Chorded arc between points a,b (VECTOR2I), center near board
        center. Emitted as nseg straight chords: freerouting chokes on locked
        PCB_ARC obstacles, and at ring radius the sagitta is <0.1mm."""
        ax, ay = rel(a)
        bx, by = rel(b)
        # center of arc: point on perpendicular bisector closest to board center
        mxp, myp = (ax + bx) / 2, (ay + by) / 2
        dx, dy = bx - ax, by - ay
        px, py = -dy, dx
        norm = math.hypot(px, py)
        px, py = px / norm, py / norm
        s = -(mxp * px + myp * py)
        cx0, cy0 = mxp + s * px, myp + s * py
        r = math.hypot(ax - cx0, ay - cy0)
        a0 = math.atan2(ay - cy0, ax - cx0)
        a1 = math.atan2(by - cy0, bx - cx0)
        da = (a1 - a0 + math.pi) % (2 * math.pi) - math.pi
        pts = [a]
        for i in range(1, nseg):
            am = a0 + da * i / nseg
            pts.append(vec(cx0 + r * math.cos(am), cy0 + r * math.sin(am)))
        pts.append(b)
        for p0, p1 in zip(pts, pts[1:]):
            self.track(p0, p1, netname, layer=layer, width=width, locked=locked)

    def true_arc(self, a, b, netname, layer=pcbnew.F_Cu, width=None):
        """Real PCB_ARC between a,b centered near board center. Only safe
        after freerouting is done (its DSN import chokes on arcs)."""
        ax, ay = rel(a)
        bx, by = rel(b)
        mxp, myp = (ax + bx) / 2, (ay + by) / 2
        dx, dy = bx - ax, by - ay
        px, py = -dy, dx
        norm = math.hypot(px, py)
        px, py = px / norm, py / norm
        s = -(mxp * px + myp * py)
        cx0, cy0 = mxp + s * px, myp + s * py
        r = math.hypot(ax - cx0, ay - cy0)
        a0 = math.atan2(ay - cy0, ax - cx0)
        a1 = math.atan2(by - cy0, bx - cx0)
        da = (a1 - a0 + math.pi) % (2 * math.pi) - math.pi
        am = a0 + da / 2
        t = pcbnew.PCB_ARC(self.board)
        t.SetStart(a)
        t.SetMid(vec(cx0 + r * math.cos(am), cy0 + r * math.sin(am)))
        t.SetEnd(b)
        t.SetLayer(layer)
        t.SetWidth(mm(width or self.j["default_track_mm"]))
        t.SetNet(self.net(netname))
        self.board.Add(t)
        return t

    def via(self, pos, netname, locked=True):
        v = pcbnew.PCB_VIA(self.board)
        v.SetPosition(pos if isinstance(pos, pcbnew.VECTOR2I) else vec(*pos))
        v.SetDrill(mm(self.j["via_drill_mm"]))
        v.SetWidth(mm(self.j["via_diameter_mm"]))
        v.SetLayerPair(pcbnew.F_Cu, pcbnew.B_Cu)
        v.SetNet(self.net(netname))
        v.SetLocked(locked)
        v.SetFrontTentingMode(pcbnew.TENTING_MODE_TENTED)
        v.SetBackTentingMode(pcbnew.TENTING_MODE_TENTED)
        self.board.Add(v)
        return v

    def zone(self, layer, netname, poly, priority=0, name=""):
        z = pcbnew.ZONE(self.board)
        z.SetLayer(layer)
        z.SetNet(self.net(netname))
        z.SetAssignedPriority(priority)
        z.SetMinThickness(mm(0.15))
        z.SetLocalClearance(mm(self.j["min_clearance_mm"]))
        z.SetPadConnection(pcbnew.ZONE_CONNECTION_THERMAL)
        z.SetThermalReliefGap(mm(0.25))
        z.SetThermalReliefSpokeWidth(mm(0.3))
        z.SetIslandRemovalMode(pcbnew.ISLAND_REMOVAL_MODE_ALWAYS)
        if name:
            z.SetZoneName(name)
        ol = z.Outline()
        ol.NewOutline()
        for x, y in poly:
            ol.Append(mm(CX + x), mm(CY + y))
        self.board.Add(z)
        return z

    def circle_poly(self, r, n=72, r_inner=None):
        pts = [(r * math.cos(2 * math.pi * i / n), r * math.sin(2 * math.pi * i / n))
               for i in range(n)]
        return pts


def wipe(board):
    # Delete (not Remove): Remove leaves ownership dangling on the python
    # proxy side -> heap corruption / segfaults later in the run
    for t in list(board.GetTracks()):
        board.Delete(t)
    for z in list(board.Zones()):
        board.Delete(z)


def pad_of(fp, num):
    for p in fp.Pads():
        if p.GetNumber() == str(num):
            return p
    raise KeyError(f"{fp.GetReference()} pad {num}")


def add_keepouts(board, rt):
    """No-via rule areas. The coin clip's feet were the only entries; the
    LiPo board has none (its cell is taped over vias, which are tented)."""
    rects = []
    for x0, y0, x1, y1 in rects:
        z = pcbnew.ZONE(board)
        z.SetIsRuleArea(True)
        z.SetDoNotAllowVias(True)
        z.SetDoNotAllowTracks(False)
        z.SetDoNotAllowCopperPour(False)
        z.SetDoNotAllowPads(False)
        z.SetDoNotAllowFootprints(False)
        z.SetLayer(pcbnew.B_Cu)
        ol = z.Outline()
        ol.NewOutline()
        for x, y in ((x0, y0), (x1, y0), (x1, y1), (x0, y1)):
            ol.Append(mm(CX + x), mm(CY + y))
        board.Add(z)


def add_ring_stubs(board, rt):
    """Stub U1's DVDD pins into the transplanted under-chip 1V1 square and
    the IOVDD/QSPI_IOVDD pins into the 3V3 ring. The official board feeds
    its rings through B.Cu traces + its base pour; on this board the moat
    between the EP and the pin ring is freerouting territory, so each stub
    is gated against the routed copper and silently skipped when blocked
    (the rings are redundant copper, not the primary connection)."""
    import finish as fin
    obs = fin.Obstacles(board)
    u1 = None
    for fp in board.GetFootprints():
        if fp.GetReference() == "U1":
            u1 = fp
    # pad number -> stub endpoint inside the ring copper (board-frame mm)
    STUBS = {
        "6":  (2.05, 0.30), "23": (0.00, -2.55), "39": (-2.05, -0.10),
        "1":  (2.50, 2.30), "11": (2.50, -1.70), "20": (1.20, -3.10),
        "30": (-2.55, -3.05), "38": (-2.50, -0.50), "45": (-2.50, 2.30),
        "53": (0.00, 2.10), "54": (0.40, 2.10),
    }
    added = skipped = 0
    for p in u1.Pads():
        num = p.GetNumber()
        if num not in STUBS:
            continue
        px, py = rel(p.GetPosition())
        # start just inside the pad's inner end (pads are 0.88 long)
        sx = px - math.copysign(0.34, px) if abs(px) > 3 else px
        sy = py - math.copysign(0.34, py) if abs(px) <= 3 else py
        end = STUBS[num]
        if obs.clear_seg((sx, sy), end, pcbnew.F_Cu, p.GetNetname(),
                         0.127 + 0.10):
            rt.track((sx, sy), end, p.GetNetname(), width=0.2)
            added += 1
        else:
            skipped += 1
    print(f"power-ring stubs: {added} added, {skipped} blocked")


def main():
    no_autoroute = "--no-autoroute" in sys.argv or "--no-freeroute" in sys.argv
    design = load_design()
    board = pcbnew.LoadBoard(str(PCB))
    wipe(board)
    # Seed KiCad's UUIDs after the load (loading draws from the generator
    # too): the board file is saved sorted by UUID, so random ones reorder
    # the pours and tracks on every run and the router sees a different
    # input each time (2026-11-02).
    pcbnew.KIID.SeedGenerator(0)
    rt = Router(board, design)
    fps = {fp.GetReference(): fp for fp in board.GetFootprints()}
    n_leds = design["leds"]["count"]
    r_board = design["board"]["diameter_mm"] / 2
    r_led = r_board - design["leds"]["ring_margin_mm"]

    # Scripted structure is deliberately minimal: inner-layer planes and
    # keepouts only. Freerouting v2 hangs on any pre-existing wire segments,
    # so it owns ALL wires and fanout vias; planes give it the power nets.
    add_keepouts(board, rt)
    # A few strategic plane-access vias (bare vias are safe pre-freerouting;
    # wires are not). They give freerouting cheap 3V3 access in the dense
    # left/right clusters.
    # NB: no through vias possible for r<4.4 — the battery clip's 8mm GND
    # contact pad covers the back there.
    # (bottom-center pair kept at r>4.4: inside that radius the clip's 8mm
    # back pad eats the via holes — they only survived DRC before because
    # they went unused and were dropped as dangling)
    # ((-1.2,-8.3): the crystal-pocket decaps' 3V3 feed — SW1's move to
    # top-center displaced the corridor they used to tap)
    # ((-0.35,4.5) not (-0.6,4.5): shifted right so the locked FB link can
    # enter the switcher pour's lobe at x=-1.0 with 0.127 via clearance)
    # ((-5.85,-1.60) not (-5.9,-1.2): the QSPI flash U7 (RP2350A revision,
    # on the front until 2026-10-25) took the pocket north of it and its pad-5 tip lands 0.07 from the old
    # spot. Grid-scanned (0.05mm, all pads both sides + locked tracks +
    # vias + 3V3-disc/clip-pad radii): this is the nearest legal spot, 0.40
    # away. Re-scan rather than nudge by eye if anything here moves.
    # ((-4.25,-7.55) not (-1.2,-8.3): the Aug 5 2026 ABM8-272-T3 swap grew
    # the crystal to a 3225 and moved Y1 to (0,-8.02), which swallowed the
    # old spot — it lands inside Y1's courtyard, ON its GND pad 2. Re-scanned
    # with safe_via_spot()'s constraint model rather than nudged by eye, as
    # the note below says to. The nearest legal spot (-2.42,-7.86) clears by
    # only 0.02 against Y1 pad 3, so this takes the best-clearance spot in
    # the pocket instead: 0.96mm margin, and its tightest neighbour is C8
    # pad 1 — which is 3V3 itself, i.e. it sits right on the decap it feeds.)
    # (0.9,5.0)/(-0.35,4.5) REMOVED Aug 25: the shipped board (43eadc1)
    # has no 3V3 vias there — that south-center zone is where its QSPI
    # and USB_DM/DP routes made their B->F transitions. The drifted pair
    # squatted on that corridor and QSPI/USB_DM/DP stranded chronically.
    # (-5.85,-1.60) and (-4.25,-7.55) DROPPED 2026-10-28: ultraroute's own
    # fanout reached the In2 disc without them (lab vled-width-1 s0), so
    # they were left touching In2 only and KiCad flagged them dangling.
    # (6.2,2.6) stays: that route uses it.
    for pos in ((6.2, 2.6),):
        rt.via(pos, "3V3")
    # (Straggler assists for USB_DM, USB_DP and IMU_SDA dropped
    # 2026-10-27: they were freerouting assists, vias at the shipped
    # board's own transitions. Their tracks were never locked, so with
    # ultraroute's --strip they stood free and ended up dangling.)
    # VREG single-point ground return: two vias INSIDE the transplanted
    # local GND pour, at the official minimal design's spots (rotated);
    # separate dedicated via for CFILT's GND
    for pos in ((-3.10, 4.40), (-3.10, 5.00)):
        rt.via(pos, "GND")
    rt.via((-4.65, 3.20), "GND")
    # canonical FB link: pin 50 -> the switcher pour's FB landing lobe
    # (the lobe stops 1mm short of the FB pad on the official board too;
    # without this link freerouting can leave the cluster copper and the
    # pin-ring VDD_CORE as two fragments whose closest approach is mid-air
    # over U2 — no candidate the finisher can act on). Geometry is exact
    # against the 0.127 rule: out of pad 50 dead-center of the pin 49/51
    # gap (pad edges -1.5/-0.9 -> 0.225 each side), jog right at y=3.66
    # (0.205 above the pad tips, 0.15 under C11 pad1's corner at
    # (-1.25,3.885)), up at x=-1.00 (0.175 off C11 pad1) into the lobe's
    # bottom-left corner (-1.0,4.4). The 3V3 finger pour it grazes is
    # filled post-route and necks around this track on its own. A stray
    # clearance violation here is fatal: freerouting cannot rip up locked
    # wiring and burns its whole 900s budget trying (seen live), so
    # re-audit pads AND pre-placed vias before moving any coordinate.
    # (C leg at -1.02, not -1.00: buys the USB_DM escape diagonal its
    # 0.277 corner clearance; C11 pad1 gap is still 0.155)
    # (The last leg runs on to y 4.70, into the pour's body: ending at 4.44
    # it only grazed the lobe's corner, a 0.118 mm joint. Gate 7 MAJOR-A.)
    for a, b in (((-1.20, 3.30), (-1.20, 3.66)),
                 ((-1.20, 3.66), (-1.02, 3.66)),
                 ((-1.02, 3.66), (-1.02, 4.70))):
        rt.track(a, b, "VDD_CORE", width=0.15)
    # VDD_CORE feed into the under-chip 1V1 square, as on the official board
    # (its +1V1 rotated into our frame): the switcher pour's lobe reaches
    # the square through a via, 0.6 mm of B.Cu under the chip and a via in
    # the square's band (EP edge + 0.25). Each DVDD decoupler gets the same:
    # a via beside its VDD_CORE pad and B.Cu to a square via at its pin's
    # spoke. (C5, pin 39, has none: its via and B.Cu walled in U1's west
    # escapes, and VBUS_SENSE/LIGHT/CHRG_DONE went unrouted on 5 seeds.)
    # Without them the pour, the square and the caps were separate
    # F.Cu pieces joined only by ~14 mm of router copper (gate 7 MAJOR-A,
    # 2026-11-02).
    rt.via((-0.50, 5.30), "VDD_CORE")
    rt.via((-0.49, 1.65), "VDD_CORE")
    rt.track((-0.50, 5.30), (-0.49, 1.65), "VDD_CORE", layer=pcbnew.B_Cu,
             width=0.6)
    for ring, via, pad in (((2.15, 0.30), (4.80, 2.30), (4.80, 1.68)),     # C6, pin 6
                           ((0.00, -2.65), (3.385, -4.85), (3.385, -5.45))):  # C13, pin 23
        rt.via(ring, "VDD_CORE")
        rt.via(via, "VDD_CORE")
        rt.track(ring, via, "VDD_CORE", layer=pcbnew.B_Cu, width=0.4)
        rt.track(via, pad, "VDD_CORE", width=0.3)
    # C5 (pin 39) has no locked link: place.py turns its VDD_CORE pad to
    # face the pin, 1 mm off, and the router joins them. A locked F.Cu link
    # in pin 39's lane cost a neighbouring pin its fanout escape (65 of 67
    # escaped against 66; 2026-11-03 probes).
    # channel the HRO connector's interleaved duplicate-pad joins through
    # the front layer: DM hops inboard of the pad row, DP outboard
    # (DM's vias sit 0.2 mm past the pad ends, y -13.25, not on the pads at
    # -13.55: a via hole in an SMD pad wicks solder; earring.kicad_dru now
    # holds holes 0.1 mm off SMD pads. 2026-11-02, gate 7 MAJOR-1.)
    for pos in ((-0.75, -13.25), (0.25, -13.25)):
        rt.via(pos, "USB_C_DN")
    for pos in ((-0.25, -15.0), (0.75, -15.0)):
        rt.via(pos, "USB_C_DP")
    # ---------- USB differential pair (canonical, locked) ----------
    # J1 -> U5 (flow-through ESD) -> down the back WEST of the battery
    # clip's 8x8 back pad, around its SW corner with concentric-C parity
    # (outer lane always turns onto the farther rail so the pair never
    # crosses itself) -> via pair below R6/R7 -> up to their pad 1, DP
    # threading the 0.48mm R7.1/R7.2 gap at x=2.1. Keeps DP/DM paired at
    # 0.30mm centers for the shared run and, critically, off the inner
    # layers: freerouting used to snake both lines through In1/In2,
    # slotting the GND plane and splitting the 3V3 disc. The west side is
    # chosen because an east-side run walls off SWCLK's back-side test
    # pad, VBUS's route to the charger and BOOTSEL (seen live: 6/6 seeds
    # failed); west only PWR_EN crosses, with an easy front hop. The
    # verticals jog west around the GND via at (-4.65,3.2). Every
    # segment, via and cross-net pairing is verified numerically against
    # all pads (rect models), holes, pre-placed vias and the other locked
    # links, including segment crossings — re-run the checker on ANY
    # coordinate change: a locked-wire clearance violation makes
    # freerouting burn its whole 900s budget.
    # Topology: J1's pin order puts DM's duplicate pads outside DP's at
    # the connector, while R7 (DM) sits above R6 (DP) — one pair crossing
    # is unavoidable. It happens on the west side as a short F.Cu hop
    # (vias at (-4.34,-9.40)/(-5.40,-8.75), a zone that is empty on F):
    # DP crosses over DM's rail, so DM rides outer-north/inner-south and
    # the escapes stay planar. VBUS's ties would be walled in by the DP
    # tip bypass, so it gets a locked link too: via-in-pad on U5.5 (same
    # trick as C30) and an F.Cu trunk over U5's body joining both ties.
    # GROUND TRUTH (back-ported Aug 25 from the ordered board 43eadc1):
    # the shipped, DRC-0/0 board locks ONLY these five stubs — the
    # duplicate-pad joins at the connector plus DP's rise through B6.
    # Freerouting owns the whole J1->U5->R6/R7->U1 run beyond them. The
    # previous 30-segment "canonical pair" table in this file was a
    # STALE earlier iteration (its west rail razed straight through
    # R6/R7's current back-side pads -> shorting_items -> freerouting
    # burned its full budget; the ordered board never contained it).
    USB_PAIR = {
        "USB_C_DN": [
            ("B", (-0.75, -13.60), (-0.75, -13.25)),  # pad stubs to vias
            ("B", (0.25, -13.60), (0.25, -13.25)),
            ("F", (-0.75, -13.25), (0.25, -13.25)),  # duplicate-pad join
        ],
        "USB_C_DP": [
            ("B", (-0.25, -14.60), (-0.25, -15.00)),  # pad stubs to vias
            ("B", (0.75, -14.60), (0.75, -15.00)),
            ("F", (-0.25, -15.00), (0.75, -15.00)),   # duplicate-pad join
            # (the "rise through B6" to y -13 was dropped 2026-10-27: it
            # ran 0.47 mm past the pad and dangled; the router takes B6 on
            # to U5.6)
        ],
    }
    for net, segs in USB_PAIR.items():
        for layer, a, bpt in segs:
            ly = pcbnew.F_Cu if layer == "F" else pcbnew.B_Cu
            rt.track(a, bpt, net, layer=ly, width=0.15)
    # (these two were via-in-pad until 2026-11-02; now each sits just off
    # its pad with a B.Cu stub, hole 0.12-0.15 mm clear of the pad)
    rt.via((-2.35, -13.20), "VBUS")  # below tie A4B9's end
    rt.track((-2.40, -13.70), (-2.35, -13.20), "VBUS", layer=pcbnew.B_Cu,
             width=0.4)
    # U5.5's via: south-east, between U5.6 and C28.1 (VBUS too). East of the
    # pad is C28.2 (GND), 0.44 mm away. The B.Cu stub runs east past U5.4/5.6,
    # then south; the trunk reaches it on F.Cu by a spur (post-route section).
    # (Variant D moved U5 out of the tip pocket for the matrix driver, so
    # its U5-tied VBUS via, stub and trunk are left to the router.)
    u5_tip = design["leds"].get("matrix", {}).get("spot") == "tip"
    if not u5_tip:
        rt.via((1.45, -10.25), "VBUS")
        for a, b in (((0.92, -11.50), (1.35, -11.50)),
                     ((1.35, -11.50), (1.45, -10.25))):
            rt.track(a, b, "VBUS", layer=pcbnew.B_Cu, width=0.2)
    rt.via((2.20, -12.99), "VBUS")   # SE of tie B4A9 — Sequoia moved it
    # off-pad (Aug 7) to clear the tip; the tie pad still joins the trunk
    # ---------- crystal (locked, F.Cu only) ----------
    # Skill routing.md 4a: crystal nets short and on the top layer. Left to
    # the router, XIN and XOUT each dropped through two vias to In2 under Y1,
    # 0.26mm from USB_DM (gate 7, M2). Everything is on F.Cu within 3mm, so
    # every pad-to-pad link is pre-routed and the router has nothing to do.
    # XIN leaves Y1.1 westward and runs down the 0.8mm gap between Y1's pad
    # columns (0.325 each side), then to C14.1 and straight into U1.21. The
    # east way round Y1 pad 4 doesn't fit: C14.2 (GND) sits 0.33mm under
    # pad 4, too narrow for a 0.15 track at 0.127 clearance. XOUT runs R1.2
    # -> 45 deg -> straight up into U1.22; XTAL_R is Y1.3 -> R1.1 -> C15.1.
    # All links are derived from the pads, so a moved part moves its route.
    pin = lambda ref, n: rel(pad_of(fps[ref], n).GetPosition())
    y1, y2, y3 = pin("Y1", "1"), pin("Y1", "2"), pin("Y1", "3")
    c14, r11, r12 = pin("C14", "1"), pin("R1", "1"), pin("R1", "2")
    u21, u22, c15 = pin("U1", "21"), pin("U1", "22"), pin("C15", "1")
    gx = (y1[0] + y2[0]) / 2
    xin = [y1, (gx, y1[1]), (gx, c14[1] - 0.467), c14, u21]
    xout = [r12, (u22[0], r12[1] + (u22[0] - r12[0])), u22]
    for net, path in (("XIN", xin), ("XOUT", xout),
                      ("XTAL_R", [y3, r11, c15])):
        for a, b in zip(path, path[1:]):
            rt.track(a, b, net, width=0.15)
    from outline import outline_points, offset_polygon
    margin = design["leds"]["ring_margin_mm"]
    outer = outline_points(design, 100)
    n_layers = design["board"]["layers"]
    zp = rt.zone(pcbnew.In1_Cu, "GND", outer, name="gnd_plane")
    zp.SetPadConnection(pcbnew.ZONE_CONNECTION_FULL)
    # In2 = the three LED zone rails (2026-10-24) + the 3V3 disc. 4-layer:
    #   VLED_C  inner band r 9.15-10.85: the interior octagon's VDD pads
    #           (WS2816C VDD pads at r 9.71-10.23; re-centred, review C1)
    #   VLED_L / VLED_R  outer band r > 11.15, cut in two by the line
    #           between the zone boundaries (LED18|LED19 at the bottom,
    #           LED1|LED37 at the tip); the piece holding LED2 is left
    # 0.3mm gaps between the pieces, so no two nets' outlines overlap. The
    # VLED consumers inside r 9.3 (U4/U9/U10, their caps, C68-C74) reach
    # their rail with routed traces, as before.
    matrix = design["leds"].get("drive") == "matrix"   # variant B
    # Variant B has no VLED rails: the LED anodes are the driver's SW lines,
    # so In2 keeps only the 3V3 disc and its outer band is left to the
    # router for the CS bus round the ring.
    if not matrix:
        assert n_layers < 6, "6-layer VLED zone planes not updated for zones"
        from shapely.geometry import LineString, Point, Polygon
        from circuit import led_zone_of
        zone_of = led_zone_of(design)
        pos = {i: rel(fps[f"LED{i}"].GetPosition()) for i in zone_of}
        board_poly = Polygon(outer)
        inner = Point(0, 0).buffer(10.85, 128).difference(Point(0, 0).buffer(9.15, 128))
        band = board_poly.difference(Point(0, 0).buffer(11.15, 128))
        ring = design["leds"]["ring_count"]
        tip = design["leds"]["count"] - ring - design["leds"].get("inner_count", 0)
        split = max(i for i, z in zone_of.items() if z == "L")
        pb = [(a + b) / 2 for a, b in zip(pos[split], pos[split + 1])]
        pt = [(a + b) / 2 for a, b in zip(pos[1], pos[ring + tip])]
        cut = LineString([pb, pt])
        cut = LineString([(pb[0] + (pb[0] - pt[0]) * 2, pb[1] + (pb[1] - pt[1]) * 2),
                          (pt[0] + (pt[0] - pb[0]) * 2, pt[1] + (pt[1] - pb[1]) * 2)])
        pieces = band.difference(cut.buffer(0.15))
        pieces = sorted(getattr(pieces, "geoms", [pieces]), key=lambda g: -g.area)[:2]
        left = [g for g in pieces if g.contains(Point(pos[2]))]
        assert len(left) == 1, "VLED band split failed"
        right = [g for g in pieces if g is not left[0]][0]
        for net, shp in (("VLED_L", left[0]), ("VLED_R", right), ("VLED_C", inner)):
            z = rt.zone(pcbnew.In2_Cu, net, list(shp.exterior.coords)[:-1],
                        priority=1, name=f"{net.lower()}_plane")
            for hole in shp.interiors:
                z.Outline().NewHole()
                for x, y in list(hole.coords)[:-1]:
                    z.Outline().Append(mm(CX + x), mm(CY + y), 0, 0)
    disc_r = 8.95
    if matrix and design["leds"]["matrix"].get("bus_rings"):
        # Variant B: the SW lines are a locked ring bus on In2 (user's call,
        # 2026-11-03: the free router left ~50 open with no structure). 9
        # concentric rings between the 3V3 disc and the perimeter LEDs;
        # each LED and the driver drop a via onto their own ring. No other
        # net's via fits in the band, so crossings stay on F/B.
        mcfg = design["leds"]["matrix"]
        r0, pitch = mcfg.get("bus_r0", 9.05), mcfg.get("bus_pitch", 0.42)
        disc_r = r0 - pitch - 0.05   # 3V3 disc shrinks to clear the band
        nseg = 96
        # Locked vias already in the band (route.py's VBUS via at r 10.35):
        # a ring passing one leaves a gap there, so it is an open arc,
        # which still joins all its LEDs and the driver.
        band_vias = [(rel(t.GetPosition()), t.GetNetname()) for t in board.GetTracks()
                     if t.Type() == pcbnew.PCB_VIA_T and t.IsLocked()]

        def seg_dist(p, a, b):
            ax, ay = a
            bx, by = b
            L2 = (bx - ax) ** 2 + (by - ay) ** 2
            f = max(0.0, min(1.0, ((p[0] - ax) * (bx - ax) + (p[1] - ay) * (by - ay)) / L2))
            return math.hypot(p[0] - ax - f * (bx - ax), p[1] - ay - f * (by - ay))
        for k in range(mcfg["sw"]):
            r = r0 + k * pitch
            pts = [(r * math.cos(2 * math.pi * i / nseg),
                    r * math.sin(2 * math.pi * i / nseg)) for i in range(nseg)]
            ni = board.FindNet(f"SW{k + 1}")   # fresh: a cached NETINFO
            assert ni and ni.GetNetname() == f"SW{k + 1}"   # went stale once
            for a, b in zip(pts, pts[1:] + pts[:1]):
                if any(net != f"SW{k + 1}" and seg_dist(v, a, b) < 0.2 + 0.075 + 0.15
                       for v, net in band_vias):
                    continue
                t = pcbnew.PCB_TRACK(board)
                t.SetStart(vec(*a))
                t.SetEnd(vec(*b))
                t.SetLayer(pcbnew.In2_Cu)
                t.SetWidth(mm(0.15))
                t.SetNetCode(ni.GetNetCode())
                t.SetLocked(True)
                board.Add(t)
    # circle disc; overlaps the narrow tip part of the VLED hole, where its
    # higher priority carves VLED back automatically
    rt.zone(pcbnew.In2_Cu, "3V3", rt.circle_poly(disc_r), priority=2,
            name="p3v3_disc")
    # In4: solid VLED plane (6-layer only). The In2 interior is the 3V3
    # disc, so the interior LED ring's VCC fanout drops through to In4
    # instead — through vias reach it anywhere clear of the clip back pad
    # (r>4.6).
    # (6-layer In4 VLED plane removed with the zone split; see assert above)
    # In3: mostly freerouting's interior signal layer, EXCEPT a 3V3 pour
    # under the back-east IMU cluster: its nine 3V3 pads sit at r 11-14
    # while the nearest 3V3 copper (In2 disc) ends at r 9.55 — without
    # this, freerouting strands the whole cluster (seen live: 18 unrouted
    # plateau, all east-pocket nets). The pour overlaps the disc in plan;
    # the pre-placed via below bridges the two layers.
    # (keep this polygon in sync with finish.py E3V3_POUR; the south lobe
    # reaches R15's 3V3 pad at (6.3,-13.86) while keeping 1.4mm from the
    # J1 shell leg hole at (4.33,-14.88))
    # (4-layer has no In3: the cluster's 3V3 has to be routed as ordinary
    # B.Cu traces from the disc. That is one of the two things the 4-layer
    # attempt is testing — see docs/HANDOFF.md Task 5.)
    if n_layers >= 6:
        from finish import E3V3_POUR_PTS
        rt.zone(pcbnew.In3_Cu, "3V3", E3V3_POUR_PTS, name="p3v3_east")
        # bridge via: inside both the In2 disc (r<9.55) and the In3 east
        # pour; front side clear of LED45/C20/C13 pads (checked with the
        # pre-route DRC pass), back side r>4.6 and off the clip feet
        rt.via((6.6, -5.6), "3V3")
    # Right-column IOVDD decaps (C2/C4/C6/C7): dedicated 3V3 disc vias
    # 0.75mm east of each 3V3 pad. Their old fanout ran laterally along
    # the escape corridor — the IMU-signal escapes below now own those
    # lanes, and a first attempt at a single x=5.6 via column walled the
    # caps off instead (seen live: every right-column decap 3V3 pad
    # stranded). Self-served pads need no lateral lanes at all.
    # (each via sits beside its cap's 3V3 pad, ring clear of the escape
    # gaps; y values track the right-column decap positions in place.py.
    # C7 lives out east by the (6.2,2.6) 3V3 via and needs no via of its
    # own.)
    for pos in ((5.45, -3.45), (5.55, -1.0), (5.55, 1.35)):
        rt.via(pos, "3V3")
    # Channel vias for the IMU signals + LED_EN: the U1 right-side escape
    # is only ~2mm of clear F.Cu before the decap column; the long haul to
    # the back-east cluster must happen on B (open over the cell region).
    # Without a committed layer change freerouting strands all four nets
    # (seen live: deterministic 16-unrouted plateau). Same trick as the
    # USB duplicate-pad joins. Staggered east of the decap-via column so
    # the escapes thread the gaps between the 3V3 vias; all spots r>4.6,
    # north of the In3 pour (y>-4.8) and DRC-verified pre-route.
    # Gap plan (right column, caps at -3.6/-1.2/+1.2) — every passage has
    # exactly ONE user, with disjoint runs in the single-lane pin-tip
    # corridor: LED_EN (pin3, y1.5) north of C6; SDA (pin9, y-0.9) the
    # middle gap; INT1 (pin12, y-2.1) the lower gap; SCL (pin15, y-3.3)
    # the south passage between C2 and C13.
    # (Dropped 2026-10-27, like the stragglers above: the router never
    # joins a free-standing locked via, so they only dangled.)
    # (LED_EN_L's channel via dropped 2026-10-25: U4 moved to the back-west)
    # R14 (SDA pull-up) 3V3 pad: via-in-pad into the In3 pour's south
    # lobe (tented — C30's VLED via-in-pad is the precedent). The pad
    # sits deep in the tip lobe where no scanned adjacent via spot
    # clears R10's pads, the J1 leg keepout and the front LED chain
    # simultaneously (seen live as the last stuck edge, 6/6 seeds).
    # (6+ layers only: on 4 layers there is no In3 pour and the via
    # dangled)
    # (Not on the matrix variants: their back is re-placed, and the via's
    # hole in R14's pad now fails the "No via hole in SMD pad" rule; the
    # router reaches R14's 3V3 on its own there. Variant F, 2026-11-06.)
    if n_layers >= 6 and design["leds"].get("drive") != "matrix":
        rt.via(rel(pad_of(fps["R14"], 2).GetPosition()), "3V3")
    # NB: no channel vias for the USB_DM/DP escapes. The escapes' front
    # loop (DM upper row, DP looping east around R6/R7) only failed when
    # BOOTSEL's route to a back-side R3 squatted the loop lane (a
    # freerouting-era finding; R3 is on the back again since 2026-10-25,
    # beside U7's /CS south of the chip). Via pairs for DM/DP were
    # tried and are UNFIXABLE: the pin order (51 west of 52) vs any
    # legal via spots forces a same-layer crossing (the only west via
    # slot at r>4.45 belongs to the (-0.35,4.5) 3V3 via).
    # SWDIO to TP3 (back lower-left shoulder): the locked USB-pair rails
    # at x -5.1/-5.4 wall the west back from y -8 to +6.9, so the wire
    # must cross to B WEST of them — commit that with a via left of the
    # chip (TP3's D1-era shoulder move put it past freerouting's patience)
    # (via dropped 2026-10-27: a freerouting assist that dangled under
    # ultraroute)
    # SWCLK to TP2 (back east shoulder): same story on the east — the
    # IMU cluster + pour traffic put the long haul past freerouting's
    # plateau; commit the B transition NE of the chip corner
    # (via dropped 2026-10-27, same reason as SWDIO's)
    # (CHRG / CHRG_DONE escape vias and U2's landing loop dropped
    # 2026-10-25: the charger moved to the back. They were freerouting
    # assists measured off U2's front spot.)
    # NB: do NOT put a rule area over the In2 disc to stop wire crossings —
    # freerouting treats the DSN keepout as a hard obstacle and loses the
    # whole center region (18 unrouted vs the usual 6). Disc splits are
    # instead healed post-route by stitch_p3v3_islands() in finish.py.
    # (2026-10-24, WS2816C + zones: the C30 via-in-pad, the LED1-3 /
    # LED32-34 VLED vias, the C32->C30 link and the LED_D3 fragment are
    # gone. They were freerouting workarounds measured off SK6805 pads, and
    # the board is now routed by the user's own autorouter.)
    # (U3's scanned 3V3-disc via dropped 2026-10-25: U3 moved to the back.)
    pcbnew.SaveBoard(str(PCB), board)

    # ---------- outer pours ----------
    from outline import offset_polygon as _offp
    rt2 = Router(board, design)
    add_ring_stubs(board, rt2)

    # VBUS trunk (F.Cu over U5's body, joining the tie-pad via-in-pads to
    # U5.5's): pre-routing these tracks crashes freerouting's SES writer
    # (see the pre-route comment), so they go in here. The corridor is
    # numerically verified against all static copper; the gate only
    # protects against freerouting wires that strayed into it — a blocked
    # seg fails this attempt and the route/finish retry rerolls the seed.
    import finish as fin
    obs2 = fin.Obstacles(board)
    VBUS_TRUNK = [((-2.35, -13.20), (-0.50, -12.40)),
                  ((-0.50, -12.40), (0.92, -11.50)),
                  ((0.92, -11.50), (1.45, -10.25)),  # spur to U5.5's via
                  ((0.92, -11.50), (1.60, -12.20)),
                  ((1.60, -12.20), (2.20, -12.99))]  # ends on the moved via (was 2.35,-13.45, which left it dangling)
    vb_blocked = 0
    pw = design["jlcpcb"]["power_track_mm"]
    if design["leds"].get("matrix", {}).get("spot") == "tip":
        VBUS_TRUNK = []   # U5 moved (variant D): no trunk over its body
    for a, b2 in VBUS_TRUNK:
        # fat first (power netclass width), thin fallback: the corridor
        # over U5's body was verified for 0.15 — the fat variant only goes
        # in when it clears everything too. The thin one is the power
        # class's 0.2mm floor (earring.kicad_dru), not the 0.15 default.
        if obs2.clear_seg(a, b2, pcbnew.F_Cu, "VBUS", 0.127 + pw / 2):
            rt2.track(a, b2, "VBUS", width=pw)
        elif obs2.clear_seg(a, b2, pcbnew.F_Cu, "VBUS", 0.127 + 0.1):
            rt2.track(a, b2, "VBUS", width=0.2)
        else:
            vb_blocked += 1
    if vb_blocked:
        print(f"WARNING: VBUS trunk: {vb_blocked} segs blocked by routed copper")

    # RP2350 ds §6.3.8: cut copper under the inductor (F.Cu) and cut the
    # layer-2 plane under the inductor + VREG_LX node (In1). Added post-route
    # so the DSN never sees them (freerouting treats keepouts as obstacles).
    def pour_keepout(layer, x0, y0, x1, y1):
        z = pcbnew.ZONE(board)
        z.SetIsRuleArea(True)
        z.SetDoNotAllowCopperPour(True)
        z.SetDoNotAllowVias(False)
        z.SetDoNotAllowTracks(False)
        z.SetDoNotAllowPads(False)
        z.SetDoNotAllowFootprints(False)
        z.SetLayer(layer)
        ol = z.Outline()
        ol.NewOutline()
        for x, y in ((x0, y0), (x1, y0), (x1, y1), (x0, y1)):
            ol.Append(mm(CX + x), mm(CY + y))
        board.Add(z)

    pour_keepout(pcbnew.In1_Cu, -3.35, 5.65, -0.65, 8.00)  # In1 under L1
    pour_keepout(pcbnew.In1_Cu, -2.60, 2.60, -1.80, 5.65)  # In1 under LX
    # (the In4 copy of this cut went 2026-11-01: a 4-layer board has no In4,
    # and the rule area was a leftover from the 6-layer build, gate 7 N1)
    # (no F.Cu rule-area under L1 any more: the transplanted 1V1/LX pours
    # own that area, and gnd_front is kept out by the cluster hole below)
    _pour = _offp(design, 0.3, 80)
    zf = rt2.zone(pcbnew.F_Cu, "GND", _pour, name="gnd_front")
    zb = rt2.zone(pcbnew.B_Cu, "GND", _pour, name="gnd_back")
    zf.SetPadConnection(pcbnew.ZONE_CONNECTION_FULL)
    zb.SetPadConnection(pcbnew.ZONE_CONNECTION_FULL)
    # gnd_front stays out of the VREG cluster entirely (the official board
    # cuts its base pour around the cluster the same way): the local GND
    # pour + its return vias are the ONLY front-side GND there, keeping the
    # single-point return and no GND slivers under L1 / between the pours.
    ol = zf.Outline()
    ol.NewHole()
    for x, y in ((-3.75, 2.30), (-0.85, 2.30), (-0.85, 8.20), (-3.75, 8.20)):
        ol.Append(mm(CX + x), mm(CY + y), 0, 0)

    # ---------- VREG pours transplanted from the official minimal design ----
    # Polygons lifted verbatim from RPI-RP2350A-MINIMAL_R4-S1.kicad_pcb
    # (KiCad-10 file parsed as sexpr text; chip-frame mm, official U1 rot=0).
    # Our U1 is the official chip rotated 180°, so map (x,y)->(-x, U1Y-y).
    # Relative priorities preserved from the official board; all sit above
    # gnd_front(0). The caps MUST sit at x=-2.00 (place.py) or the 0.3mm LX
    # finger threading their pad gap pinches below the 0.15 min fill width.
    U1Y = -0.5
    OFFICIAL_POURS = [
        # under-chip 3V3 ring (between the 1V1 square and the pin ring)
        ("3V3", 1, [(2.8, 2.8), (-2.8, 2.8), (-2.8, -2.8), (2.8, -2.8)]),
        # under-chip 1V1 square (ring around the EP once GND clears it)
        ("VDD_CORE", 3, [(2.2, 2.2), (-2.2, 2.2), (-2.2, -2.2), (2.2, -2.2)]),
        # local GND return: PGND pin 47 + CIN/COUT GND pads + return vias
        ("GND", 4, [(2.3, -3.15), (2.3, -4.85), (2.45, -4.85), (2.45, -5.3),
                    (2.3, -5.3), (2.3, -5.8), (3.1, -5.8), (3.4, -5.5),
                    (3.4, -4.75), (2.5, -3.85), (2.5, -3.15)]),
        # LX: pin 48 -> 0.3mm finger between the cap pad columns -> wide
        # column into L1 pad 2
        ("VREG_LX", 5, [(1.9, -3.15), (1.9, -3.95), (1.85, -4.0),
                        (1.85, -6.15), (2.35, -6.65), (2.35, -8.05),
                        (3.05, -8.05), (3.05, -6.35), (2.75, -6.05),
                        (2.3, -6.05), (2.15, -5.9), (2.15, -4.0),
                        (2.1, -3.95), (2.1, -3.15)]),
        # 1V1 switcher pour: L1 pad 1 + COUT hot pad + FB landing lobe
        ("VDD_CORE", 6, [(1.65, -5.3), (1.65, -6.675), (1.65, -8.05),
                         (0.95, -8.05), (0.95, -6.2), (1.25, -5.9),
                         (1.25, -5.75), (1.05, -5.75), (0.7, -6.1),
                         (0.5, -6.1), (0.2, -5.8), (0.2, -5.2), (0.5, -4.9),
                         (1.0, -4.9), (1.0, -5.1), (1.55, -5.1),
                         (1.55, -5.3)]),
        # 3V3 feed finger: VREG_VIN pin 49 -> CIN hot pad (also merges with
        # the under-chip 3V3 ring at its tip)
        ("3V3", 7, [(1.5, -2.7), (1.5, -4.05), (1.25, -4.3), (1.25, -4.85),
                    (1.7, -4.85), (1.7, -2.7)]),
    ]
    for netname, prio, poly in OFFICIAL_POURS:
        pts = [(-x, U1Y - y) for x, y in poly]
        z = rt2.zone(pcbnew.F_Cu, netname, pts, priority=prio,
                     name=f"vreg_{netname.lower()}_{prio}")
        z.SetPadConnection(pcbnew.ZONE_CONNECTION_FULL)  # official: solid

    # ---------- fill + report ----------
    filler = pcbnew.ZONE_FILLER(board)
    filler.Fill(board.Zones())
    pcbnew.SaveBoard(str(PCB), board)
    board.BuildConnectivity()
    unconnected = board.GetConnectivity().GetUnconnectedCount(True)
    if no_autoroute:
        print(f"pre-route done (no autoroute); unconnected: {unconnected}")
        return
    print(f"pre-route done; unconnected: {unconnected}; running ultraroute")
    autoroute()


def autoroute():
    """Route the saved board in place with ultraroute, refill, report."""
    import json
    recipe = json.loads(RECIPE.read_text())
    name, zones, parts = BLOCK
    subprocess.run([sys.executable, str(ULTRAROUTE / "tools" / "add_block.py"),
                    str(PCB), name, ",".join(zones), "--parts", ",".join(parts)],
                   check=True)
    routed = PCB.with_name(PCB.stem + "-routed.kicad_pcb")
    routed.unlink(missing_ok=True)
    r = subprocess.run([str(ROUTE_SH), "route", str(PCB), "-o", str(routed)]
                       + recipe["args"])
    if r.returncode != 0 or not routed.exists():
        print(f"ultraroute failed (exit {r.returncode}); board left pre-routed")
        sys.exit(1)
    # Move it over the board first: loaded from its own name, pcbnew finds no
    # .kicad_pro beside it, and saving would write KiCad's default rules
    # over earring.kicad_pro.
    routed.replace(PCB)
    board = pcbnew.LoadBoard(str(PCB))
    # The final fill uses a 0.2 mm minimum width on the large planes. At 0.15,
    # KiCad's fill left corner slivers that the 0.09 mm connection_width rule
    # flags (gnd_back 0.056, vled_r 0.074; 2026-11-01). It isn't monotonic
    # (0.25 made new ones), so re-check DRC if this moves. Only the refill
    # changes: routing ultraroute over 0.2 mm fills gave a different route,
    # with 13 same-net via-pair necks. The VREG pours keep 0.15 for the LX finger.
    for z in board.Zones():
        if not z.GetIsRuleArea() and not z.GetZoneName().startswith("vreg_"):
            z.SetMinThickness(mm(0.2))
    # No gnd_front between CC1's R4.1 and the locked VBUS A4B9 via: the two
    # clearances leave a 0.077 mm strip of pour there (connection_width,
    # 2026-11-02). Both are fixed, so this holds on every route. It's added
    # after routing so the router's input, and so the route, don't change.
    # (KiCad reports the error at the zone's origin, (112.46,91.73); the
    # pinch itself is at (97.74,86.39).)
    z = pcbnew.ZONE(board)
    z.SetIsRuleArea(True)
    z.SetDoNotAllowCopperPour(True)
    for allow in (z.SetDoNotAllowVias, z.SetDoNotAllowTracks,
                  z.SetDoNotAllowPads, z.SetDoNotAllowFootprints):
        allow(False)
    z.SetLayer(pcbnew.F_Cu)
    z.SetZoneName("nopour_cc1_vbus")
    ol = z.Outline()
    ol.NewOutline()
    for x, y in ((-2.45, -13.80), (-2.00, -13.80), (-2.00, -13.40), (-2.45, -13.40)):
        ol.Append(mm(CX + x), mm(CY + y))
    board.Add(z)
    pcbnew.ZONE_FILLER(board).Fill(board.Zones())
    pcbnew.SaveBoard(str(PCB), board)
    board.BuildConnectivity()
    unconnected = board.GetConnectivity().GetUnconnectedCount(True)
    print(f"routing done; unconnected: {unconnected}")


if __name__ == "__main__":
    main()
