sequoia-hope/simple-earring/scripts/finish.py

#!/usr/bin/env python3
"""Finish stage: complete the few connections freerouting plateaus on.

Rounds until convergence:
  1. DRC -> unconnected edges (net, endpoint A, endpoint B).
  2. For each edge, generate obstacle-aware candidates:
     - plane nets: stub + via into the plane at a searched clear spot
     - direct / dogleg segments on F.Cu or B.Cu (clearance-sampled)
     - F -> B -> F via hop
  3. Add candidate, run real DRC; keep only if errors don't increase and
     the edge actually resolves (or total unconnected drops).

The obstacle index is a flat list of copper items; clearance checks are
sampled, then the authoritative DRC gates every accepted candidate.
"""
import json
import math
import shutil
import subprocess
import sys
import tempfile
from pathlib import Path

import pcbnew

sys.path.insert(0, str(Path(__file__).resolve().parent))
from circuit import load_design  # noqa: E402
from route import Router, vec, mm  # noqa: E402

ROOT = Path(__file__).resolve().parent.parent
from paths import PCB  # noqa: E402

# Canonical In3 east-pour polygon (6-layer only). route.py builds the zone
# from this; the south lobe reaches R15's 3V3 pad at (6.3,-13.86) while
# keeping 1.4mm from the J1 shell leg hole at (4.33,-14.88).
E3V3_POUR_PTS = [(4.2, -4.8), (11.2, -4.8), (11.2, -8.44), (8.9, -13.3),
                 (7.4, -14.3), (5.6, -14.3), (4.6, -13.3), (4.2, -9.5)]

# Radial bands where a through via lands in plane copper, per stackup.
# 6-layer: VLED lower bound 4.75 not 9.7 because In4 is a full VLED plane,
# so a via anywhere outside the clip back pad reaches it; 3V3 upper 8.7 is
# the In2 disc (9.55) less margin.
# 4-layer: no In4 and no In3, so VLED exists only as the In2 annulus
# (hole pulled in to r 9.35) and the 3V3 disc shrinks to 9.15 — see the
# zone block in route.py, which is the source of both radii.
_LAYER_PLANES = {
    6: ({"3V3": (0.0, 8.7), "GND": (0.0, 14.0), "VLED": (4.75, 14.0)},
        E3V3_POUR_PTS),
    4: ({"3V3": (0.0, 8.3), "GND": (0.0, 14.0), "VLED": (9.35, 14.0)},
        None),
}
_n_layers = load_design()["board"]["layers"]
PLANE_NETS, E3V3_POUR = _LAYER_PLANES[6 if _n_layers >= 6 else 4]


def _in_poly(q, poly):
    x, y = q
    inside = False
    for (x0, y0), (x1, y1) in zip(poly, poly[1:] + poly[:1]):
        if (y0 > y) != (y1 > y) and x < x0 + (x1 - x0) * (y - y0) / (y1 - y0):
            inside = not inside
    return inside


def in_plane(net, q):
    """Would a via at q land inside net's plane copper (0.35mm margin)?"""
    band = PLANE_NETS.get(net)
    if band is None:
        return False
    lo, hi = band
    r = math.hypot(*q)
    if lo + 0.35 < r < hi - 0.35:
        return True
    if net == "3V3" and E3V3_POUR and _in_poly(q, E3V3_POUR):
        return all(seg_pt_dist(p0, p1, q) > 0.35 for p0, p1 in
                   zip(E3V3_POUR, E3V3_POUR[1:] + E3V3_POUR[:1]))
    return False
BATT_PAD_R = 4.6
CLR = 0.13          # sampled clearance target (rule is 0.127)
TRACK_W = 0.15
VIA_R = 0.2


def drc_counts(pcb_path):
    with tempfile.NamedTemporaryFile(suffix=".json", delete=False) as f:
        rep = f.name
    r = subprocess.run(
        ["kicad-cli", "pcb", "drc", "--format", "json", "--severity-error",
         "-o", rep, str(pcb_path)], capture_output=True, text=True)
    if r.returncode not in (0, 5):
        raise RuntimeError(r.stderr)
    d = json.loads(Path(rep).read_text())
    Path(rep).unlink()
    return len(d["violations"]), len(d["unconnected_items"]), d


BEST = ROOT / "out" / "earring-best.kicad_pcb"
BEST_JSON = ROOT / "out" / "earring-best.json"


def keep_if_best(unc, errs, drc_data):
    """Snapshot this attempt if it beats the best one so far.

    build.py re-rolls route+finish on a new freerouting seed when the
    board doesn't converge, overwriting hw/earring/a/earring.kicad_pcb each time —
    so without this the LAST attempt survives, not the best one. When a
    stackup can't be closed automatically, the best partial plus a punch
    list is exactly what gets handed over for manual finishing.
    """
    score = (errs, unc)
    prev = None
    if BEST_JSON.exists():
        try:
            p = json.loads(BEST_JSON.read_text())
            prev = (p["errors"], p["unconnected"])
        except (ValueError, KeyError):
            prev = None
    if prev is not None and prev <= score:
        print(f"  (best so far stays {prev[1]} unconnected / "
              f"{prev[0]} errors)")
        return
    shutil.copyfile(PCB, BEST)
    stranded = sorted({net for net, _, _ in edges(drc_data)})
    BEST_JSON.write_text(json.dumps({
        "unconnected": unc, "errors": errs,
        "stranded_nets": stranded,
        "unconnected_edges": [
            {"net": net, "from": list(a), "to": list(b)}
            for net, a, b in edges(drc_data)],
    }, indent=2))
    print(f"  -> new best: {unc} unconnected / {errs} errors "
          f"saved to {BEST.name}"
          + (f" (stranded: {', '.join(stranded)})" if stranded else ""))


def edges(drc_data):
    out = []
    for u in drc_data["unconnected_items"]:
        pts, net = [], None
        for i in u["items"]:
            pts.append((round(i["pos"]["x"] - 100.0, 3),
                        round(i["pos"]["y"] - 100.0, 3)))
            if "[" in i["description"]:
                net = i["description"].split("[")[1].split("]")[0]
        if len(pts) == 2 and net:
            out.append((net, pts[0], pts[1]))
    return out


class Obstacles:
    """Flat copper index for sampled clearance checks."""

    def __init__(self, board):
        self.items = []  # (kind, layer_set, net, geometry...)
        for t in board.GetTracks():
            net = t.GetNetname()
            if isinstance(t, pcbnew.PCB_VIA):
                x, y = to_rel(t.GetPosition())
                self.items.append(("via", None, net, x, y,
                                   t.GetWidth(pcbnew.F_Cu) / 2e6))
            else:
                a = to_rel(t.GetStart())
                b = to_rel(t.GetEnd())
                self.items.append(("seg", t.GetLayer(), net, a, b,
                                   t.GetWidth() / 2e6))
        for fp in board.GetFootprints():
            for p in fp.Pads():
                x, y = to_rel(p.GetPosition())
                sz = p.GetSize(pcbnew.F_Cu)
                w, h = sz.x / 1e6, sz.y / 1e6
                # elongated pads: one capsule along the long axis (corner
                # error ~0.04mm). square-ish pads: capsule STRIPS across the
                # short axis — the old bounding circle inflated the QFN EP
                # from 1.7 to 2.4mm, sealing the 1mm routing cavity inside
                # the pin ring, and fattened every square LED pad by 41%
                ang = math.radians(p.GetOrientationDegrees())
                if w >= h:
                    ux, uy = math.cos(-ang), math.sin(-ang)
                    long_, short = w, h
                else:
                    ux, uy = math.sin(ang), math.cos(ang)
                    long_, short = h, w
                pxu, pyu = -uy, ux
                if long_ / max(short, 1e-6) >= 2.0:
                    strips = [(0.0, short / 2)]
                else:
                    ns = max(1, int(math.ceil(short / 0.5)))
                    sh = short / ns
                    strips = [(-short / 2 + (i + 0.5) * sh, sh / 2 * 1.25)
                              for i in range(ns)]
                layers = [ly for ly in (pcbnew.F_Cu, pcbnew.B_Cu)
                          if p.IsOnLayer(ly)]
                th = p.GetAttribute() == pcbnew.PAD_ATTRIB_PTH
                for off, hw in strips:
                    hl = max(0.0, long_ / 2 - hw)
                    cx0, cy0 = x + off * pxu, y + off * pyu
                    a = (cx0 - hl * ux, cy0 - hl * uy)
                    b = (cx0 + hl * ux, cy0 + hl * uy)
                    self.items.append(
                        ("padc", layers, p.GetNetname(), a, b, hw, th))
        # 1mm spatial bins over item bboxes inflated by 0.7mm
        self.bins = {}
        for idx, it in enumerate(self.items):
            if it[0] == "via":
                xs, ys = [it[3]], [it[4]]
            else:
                xs = [it[3][0], it[4][0]]
                ys = [it[3][1], it[4][1]]
            for bx in range(int(math.floor(min(xs) - 0.7)),
                            int(math.floor(max(xs) + 0.7)) + 1):
                for by in range(int(math.floor(min(ys) - 0.7)),
                                int(math.floor(max(ys) + 0.7)) + 1):
                    self.bins.setdefault((bx, by), []).append(idx)

    def near_items(self, x, y):
        return (self.items[i]
                for i in self.bins.get((int(math.floor(x)), int(math.floor(y))), ()))

    def clear_point(self, x, y, layer, net, need, is_via=False, pads=True):
        for it in self.near_items(x, y):
            kind = it[0]
            if kind == "padc" and not pads:
                continue
            if kind == "seg":
                _, lay, inet, a, b, hw = it
                if inet == net:
                    continue
                if not is_via and lay != layer:
                    continue
                if seg_pt_dist(a, b, (x, y)) < need + hw:
                    return False
            elif kind == "via":
                _, _, inet, ix, iy, r = it
                d = math.hypot(ix - x, iy - y)
                if is_via and d < 0.55:      # hole-to-hole
                    return False
                # +0.02: segment sampling can step over a via ring by a
                # few um (seen live: 0.117 actual vs 0.127 rule)
                if inet != net and d < need + r + 0.02:
                    return False
            else:
                _, layers, inet, a, b, hw, th = it
                if inet == net:
                    continue
                relevant = is_via or th or (layer in layers)
                # +0.05: the capsule strips under-cover rectangular pad
                # CORNERS (rotated LGA/0402 pads grazed at 0.113-0.119
                # actual vs the 0.127 rule, seen live)
                if relevant and seg_pt_dist(a, b, (x, y)) < need + hw + 0.05:
                    return False
        return True

    def clear_seg(self, a, b, layer, net, need, pads=True):
        n = max(2, int(math.hypot(b[0] - a[0], b[1] - a[1]) / 0.15))
        return all(self.clear_point(a[0] + (b[0] - a[0]) * i / n,
                                    a[1] + (b[1] - a[1]) * i / n,
                                    layer, net, need, pads=pads)
                   for i in range(n + 1))


def to_rel(p):
    return (p.x / 1e6 - 100.0, p.y / 1e6 - 100.0)


def endpoint_layer(board, net, p):
    """Copper layer (F or B) of net's copper at DRC-edge endpoint p.
    Back-side pads (the IMU, relocated passives) need their stubs on B —
    the old finisher assumed F everywhere and reported 'no candidate' for
    every back-side edge. Vias/plane endpoints fall back to F."""
    F, B = pcbnew.F_Cu, pcbnew.B_Cu
    pos = pcbnew.VECTOR2I(int((p[0] + 100.0) * 1e6), int((p[1] + 100.0) * 1e6))
    on_f = on_b = False
    for fp in board.GetFootprints():
        for pad in fp.Pads():
            if pad.GetNetname() == net and pad.HitTest(pos):
                on_f |= pad.IsOnLayer(F)
                on_b |= pad.IsOnLayer(B)
    if not (on_f or on_b):
        for t in board.GetTracks():
            if t.GetNetname() != net:
                continue
            if isinstance(t, pcbnew.PCB_VIA):
                if t.HitTest(pos):
                    return "any"   # via endpoint: any layer works
                continue
            for e in (t.GetStart(), t.GetEnd()):
                if abs(e.x - pos.x) < 50000 and abs(e.y - pos.y) < 50000:
                    if t.GetLayer() == F:
                        on_f = True
                    elif t.GetLayer() == B:
                        on_b = True
                    else:
                        return "any"   # inner-layer end (freerouting
                        # parks wires on plane layers): via-reachable
    if on_f:
        return F
    if on_b:
        return B
    return None
    # NB: F_Cu == 0 is FALSY — callers must compare against None
    # explicitly, never truth-test a returned layer (seen live: every
    # front-pad endpoint silently adopted the other side's layer)


def seg_pt_dist(a, b, p):
    ax, ay = a
    bx, by = b
    px, py = p
    dx, dy = bx - ax, by - ay
    L2 = dx * dx + dy * dy
    if L2 == 0:
        return math.hypot(px - ax, py - ay)
    t = max(0.0, min(1.0, ((px - ax) * dx + (py - ay) * dy) / L2))
    return math.hypot(px - (ax + t * dx), py - (ay + t * dy))


def back_zone_ok(x, y):
    if math.hypot(x, y) < BATT_PAD_R:
        return False
    if abs(y) < 3.4 and 10.1 < abs(x) < 14.4:
        return False
    return True
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
