sequoia-hope/simple-earring/(commit log)

2026-08-03 Generated-PCB framework: first fully-routed DRC-clean build
    RP2354A + LIR2032 + 20x TBA-C1010 LED ring, 30.5mm 4-layer, JLCPCB rules.
    Pipeline: design.yaml + circuit.py -> board/place/route(freerouting)/
    finish(DRC-gated micro-router)/drc/render/export, with route+finish retry.
2026-08-03 Add ear-wire loop hole at top of board
    Plated 1.5mm hole (2.7mm annular pad, no net) at 270deg, r_board-1.9.
    LED ring now splits around a parametric hanger gap (design.yaml hanger:),
    BOOTSEL button relocated to 240deg with matching keepouts, beautify guard
    extended to detect pad obstacles on chain hops.
2026-08-03 Teardrop board: USB-C at the tip, perimeter LEDs, insertion-safe back
    - Teardrop outline (scripts/outline.py): 30.5mm round body + truncated tip,
    parametric in design.yaml; Edge.Cuts arc+tangents, zones/pours follow
    - USB: HRO TYPE-C-31-M-12 (C165948) right-angle SMD on the BACK at the tip,
    EasyEDA footprint (merged-pad spacing + NPTH pegs fixed) with 3D model;
    interleaved duplicate-pad joins channeled by pre-placed vias
    - LEDs distributed along the perimeter path with tangent orientations
    - BOOTSEL: TS-1101-C-W (C318938) small top-actuated switch, front interior
    - Battery: insertion corridor at the bottom back kept completely clear;
    CR2032-W clip 3D model attached (easyeda2kicad, li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
2026-08-03 VREG rework to RP2350 ds §6.3.8 reference layout
    The 1V1 core-regulator layout ignored the datasheet's layout rules
    (inductor 4.6mm from the LX pin, no output cap at the inductor, AVDD
    unfiltered, no copper cutouts). Rebuild the cluster as Figure 23
    rotated 180° to match U1's orientation:
    - CIN/COUT straddle the LX pin column; VREG_LX threads the gap between
    their pad columns into L1, re-laid post-route as a centered 0.20mm
    canonical path (LX_PATH in finish.py)
    - L1 nets swapped so pad 1 (footprint polarity dot) = VOUT side per
    Fig 23; dot-to-pad mapping flagged for order-time verification
    - VREG_AVDD split off 3V3 through new 33R+4u7 RC filter (R13/C22,
    r_33 = LCSC C25105, JLC ba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
2026-08-03 Battery clip 180° (cell was aimed at USB), 2D layout views in preview
    - BT1 rot=180: spring-finger mouth now faces the round-end insertion
    corridor instead of the USB tip (pads are symmetric; assembly/3D fix)
    - render.py: export layout_top/bottom.svg (PCB-editor style, viewed
    side's copper frontmost, inner layers behind, bottom mirrored);
    out/index.html gets a second preview row
    - widen_lx: judge against baseline unconnected count, not zero, so the
    LX re-lay isn't hostage to unrelated stragglers
2026-08-03 Drop hanger, extend LED ring to the tip, add power slide switch
    - Remove H1 ear-wire loop (collided with the USB footprint) from
    circuit/placement/design.yaml; BOOTSEL (SW1) moves into the freed
    top-center spot, which also decongests the bottom-center routing zone
    - LEDs 20 -> 22: path_end_y -13.2 -> -17.0 runs the perimeter chain up
    the tip straights, landing LED1/LED22 at (+-4.6, -17.0) between the
    USB shell's THT legs; R4/R5 CC pulldowns move down to (+-2.0, -14.6)
    - Add MSK12C02 slide switch (C431540, footprint+3D via easyeda2kicad)
    on the back left straight edge, knob overhanging the edge. It gates
    the LDO EN pin (SPDT: VBATT/GND) instead of carrying battery current
    - cont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
2026-08-03 VREG pours from official RP2350A minimal design; tip LED chevron; fixes
    - Transplant the RPI-RP2350A-MINIMAL R4 F.Cu VREG pours (1V1, LX, local
    GND, 3V3 finger) into route.py; recenter CIN/COUT on the LX pin column
    at x=-2.00 so the 0.3mm LX finger threads their pad gap; gnd_front now
    keeps out of the whole cluster like the official base pour.
    - Close the teardrop tip with a 3-LED front-side chevron (count 25 =
    ring_count 22 + 3); bypass caps slide along the path to dodge the USB
    shell THT legs.
    - finish.py: capsule strips for square-ish pads (bounding circles sealed
    the QFN cavity), synth real edges for split In2 3V3 disc fragments,
    drop stub plane vias, wider anchor search.
    -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
2026-08-04 Densify LED ring to tip pitch; USB as locked diff pair; fix 3D models
    LED density: ring_count 22 -> 34 (2.40-2.44mm pitch, matching the 5-LED
    tip group's ~2.45mm). The chain re-pitches around SW2 so its locating
    pegs keep their proven 1.5mm LED-bracketing clearance (anchor LED4
    pinned at S=7.75, LED3/LED5 exactly 3.0mm away); bypass caps use true
    segment midpoints and dodge J1's NPTH pegs; tip-closure cap refs are
    computed from ring_count. Deterministic finisher failures at the new
    pitch got scanned plane vias (right-tip LEDs, U3's LDO output) and
    locked links (C32's walled VLED pad -> C30's via-in-pad; VREG FB pin 50
    -> the switcher pour's landing lobe).
    USB differential pair, fully hand-r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
2026-08-04 Layout views as PNGs sized to match the 3D renders
    kicad-cli only exports vector formats for layer views, so render.py now
    rasterizes the layout SVGs with ImageMagick (600dpi, board centered on
    white, canvas taken from the just-rendered render_top.png) and drops
    the intermediate SVGs.
2026-08-04 Per-layer PNGs, 2x2 copper grid, and a stacked layer-viewer page
    Each copper layer exports as a transparent PNG on the shared board-bbox
    canvas (all in register, top view), composited into a labeled 2x2 grid
    (layout_layers.png, render-sized) and referenced by a self-contained
    out/layer_viewer.html: radio selects the opaque layer, checkboxes
    toggle visibility, a slider dims the rest; the edge outline is the
    always-on base.
2026-08-04 Hand-written LED 3D model; interactive 3D board viewer on the dashboard
    LED_TBA-C1010MB.wrl is a from-scratch VRML box for the NationStar
    SMD1010-4P (1.0 x 1.0 x 0.85mm per the datasheet), translucent grey,
    referenced from the footprint so all 37 ring LEDs render with bodies.
    render.py additionally exports out/board.glb (tracks, pads, zones,
    silk, mask, components) and the dashboard gets an orbit/zoom/pan
    three.js viewer at the bottom, loading the GLB fresh each build.
    three.js r160 (three.module.js, OrbitControls, GLTFLoader +
    BufferGeometryUtils with its import flattened) is vendored under
    web/vendor/ and copied into out/ so the page stays fully self-hosted.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
2026-08-04 Fix 3D component placement in the GLB export (viewer parts adrift)
    kicad-cli's GLB exporter has two model pipelines: with --subst-models
    it prefers same-name STEP files, and that STEP path applies
    footprint-level model offsets with the wrong sign for back-side
    footprints (SW2/J1 slid by their full offset) and double-flips some
    back-side parts (BT1's battery holder poked through to the front).
    KiCad's own raytrace uses the WRL path, which is correct - hence the
    renders and viewer disagreeing.
    Fix: bake the alignment transforms into the WRL files themselves
    (wrapper Transform nodes: +1.55mm for the MSK12C02 switch, +2.25mm for
    the USB-C, a null rotz-180 pair for the battery holder), zero the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
2026-08-04 3D viewer: TrackballControls for continuous tumbling
    OrbitControls clamps polar angle at the poles, so the board could not
    be rotated forward continuously; TrackballControls has no up-vector
    lock. Slightly snappier rotate/zoom speeds, damping 0.12, and
    handleResize() wired to window resize.
2026-08-04 docs/PLAN.md: plan of record for the IMU revision; import copper checker
    PLAN.md is the handoff doc: current state, dashboard usage, the full
    IMU-addition task breakdown (part guidance, per-script changes,
    candidate placement zones, constraint list), the condensed hard-won
    freerouting/kicad-cli/pcbnew constraints, and a file map.
    check_locked_copper.py is the numeric clearance verifier promoted from
    the session scratchpad (USB pair chains kept as the worked example;
    run against pre-route board saves).
2026-08-05 CHRG status revision: CHRG/DONE to GPIO12/13, charge LED removed, IMU footprint
    Route/finish converges to 2 unconnected nets (IMU_INT1, SWDIO) with 0 DRC
    errors after 6 attempts; committing state before placement nudges.
2026-08-05 Placement nudges: complete routing at 121 parts / 0 DRC errors
    C7/C8 out of the crystal->SW1 corridor (band ends, rot0), SW1 up to
    -11.6, R10 down to -13.75 (opens the south slot IMU_INT1 threads to
    U6.4), C1/C5 spread for a second SWDIO lane past C3. IMU_INT1 and
    SWDIO were 6/6 deterministic strandings in build 9; build 11 converged
    attempt 1, finish 0 unc / 0 errs.
    check_locked_copper.py: honor --swap instead of always shifting R6/R7
    (4 phantom violations on post-place snapshots); model ALL committed
    route.py vias + the dynamic via-in-pads (R14.2 3V3, C30.1 VLED) —
    caught two real collisions (C5 pad vs CHRG_DONE via, R14.2 via vs
    front LED33 pad) that cost build 10.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
2026-08-05 docs/PLAN.md: charger-status-to-GPIO revision recorded; D1/R9 references removed
2026-08-05 Track routed board in git; hand edits: USB diff pairs, fat USB power, CPU power cleanup
    - .gitignore: out/ contents still ignored except earring.kicad_pcb and
    earring.kicad_pro, so PCB versions are tracked from now on. Build logs
    (logs/) are now ignored.
    - Board includes manual edits made in KiCad on Aug 5: USB D+/D- nets
    renamed to a proper differential pair (matching names with trailing
    p/n), USB power rerouted with wider traces, and under-CPU power
    routing cleaned up. These still need to be back-ported into the
    generator scripts (see docs/HANDOFF.md, next commit).
2026-08-05 docs/HANDOFF.md: work queue for next session (back-port hand edits, OOS parts, schematic)
2026-08-05 HANDOFF: on routing non-convergence, hand best partial board to Sequoia with punch list
2026-08-05 Back-port hand edits as rules: USB_C_DP/DN net names, power netclass (VBUS 0.4mm), usb diff-pair class
    - USB_DP_C/USB_DM_C -> USB_C_DP/USB_C_DN everywhere (circuit, route,
    check_locked_copper): the trailing-p/n names Sequoia used so KiCad
    pairs them.
    - gen_board: 'power' netclass (VBUS, 0.4mm from design.yaml
    power_track_mm) — verified it lands in the freerouting DSN as
    (class power VBUS)+(width 400); 'usb' netclass carries diff-pair
    width/gap (0.15/0.25 = Sequoia's 0.40mm centers) for interactive
    hand-finishing.
    - route.py: post-route VBUS trunk tries power width first, 0.15
    fallback, clear_seg margin scaled accordingly.
    - Full under-CPU cleanup + B.Cu coupled-pair reroute s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
2026-08-05 RP2350A + external W25Q16JV QSPI flash (RP2354A went OOS)
    - bom: mcu -> RP2350A C42411118 (LCSC 7251 in stock 2026-08-05; RP2354A
    C41378174 is down to 1 unit). New 'flash' entry: W25Q16JVUXIQ
    C2843335, USON-8-EP 2x3mm, 16994 in stock, 2MB = same as the RP2354A's
    internal flash.
    - circuit.py: QSPI_SD0..3/SCLK are real nets now (pin map 55-59 taken
    from the official RPI-RP2350A-MINIMAL R4 board in docs/); U7 flash +
    C25 VCC decap. /CS shares the BOOTSEL net with the QSPI_SS strap,
    Pico-style.
    - library: USON-8 footprint + WRL via easyeda2kicad C2843335.
    - place.py: U7 in the front pocket west of the C3/C5 decap column; C68
    moved SW to make room. A full-front 0.1mm grid scan of th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
2026-08-05 LED swap: TBA-C1010MB (OOS) -> SK6805-EC10-000
    - bom: SK6805-EC10-000 C22394946, 4095 in stock (~91 boards at 45 LEDs
    each); the outgoing TBA-C1010MB C22461778 is down to 15 pcs.
    Chosen over XL-1010RGBC-2812B C5349953 (428k in stock) on supply
    range: SK6805 is 3.7-5.5V vs XINGLIGHT's 4.5-5.5V, and LEDs run
    straight off the LiR2032 (3.0-4.2V). VIH 0.7*VDD = 2.94V at 4.2V, so
    3.3V GPIO data still clears it.
    - circuit.py: LED_PIN map is now the single source of truth for LED pin
    numbering (SK6805 is 1=GND 2=DIN 3=VDD 4=DOUT; TBA was 1=DI 2=VCC
    3=GND 4=DO). place.py and route.py read it instead of hardcoding —
    place.py's orientation search used pad 1 as DI, which is GND on the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
2026-08-05 gen_schematic.py: generated, readable schematic (out/earring.kicad_sch, tracked)
    The board has always been code-only, so there was nothing to read when
    reasoning about the design. This emits a KiCad 9 sheet from the same
    circuit.py the board is built from:
    - one box symbol per component, pins carrying real names (RP2350 pin
    table, flash /CS-DO-CLK.., IMU, charger, LDO, load switch)
    - connections as GLOBAL NET LABELS rather than drawn wires: no router,
    no rats' nest, and it cannot drift from the netlist
    - sections flowed down columns by MEASURING each symbol, so a netlist
    change can't silently overlap two boxes (the QSPI swap alone moved
    every box below the MCU)
    - the 45-LED chain co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
2026-08-05 PARTIAL 4-layer board: 0 DRC errors, 8 nets left to hand-route
    *** This board is NOT fully routed. It is the best of 6 auto-routing
    *** attempts and is handed over for manual completion. See
    *** docs/PUNCHLIST-4layer.md.
    - design.yaml: layers 4 (was 6) for JLC lead time. The whole pipeline
    switches on board.layers now — route.py (In3/In4 zones, In2 annulus
    hole pulled to r9.35 + 3V3 disc to r9.15 so the interior LED ring
    still gets a plane drop), finish.py (per-stackup plane bands),
    render.py + export.py (layer lists). Set it back to 6 to fall back.
    - finish.py: keep_if_best() snapshots the best attempt to
    out/earring-best{.kicad_pcb,.json}. build.py re-rolls the freerouting
    s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
2026-08-06 Schematic: export SVG+PDF and link them from the :8618 dashboard
    The .kicad_sch needs KiCad to open, but the review surface is a browser.
    The schematic stage now also emits out/earring.svg (zoomable) and
    out/earring-schematic.pdf, and render.py links both from the dashboard.
    PDF is tracked so the schematic is readable straight from the repo.
2026-08-06 Link schematic to PCB: footprint properties, UUID paths, fp-lib-table
    Fixes 'Cannot update <ref> (no footprint assigned)' on Update PCB from
    Schematic. Four things were missing:
    - Symbols had no Footprint property. Each now carries
    'earring:<footprint>' taken from bom/parts.yaml via circuit.py.
    - No fp-lib-table, so that nickname resolved to nothing. gen_board.py
    writes out/fp-lib-table pointing at library/parts.pretty (tracked).
    - Board footprints had bare FPIDs and empty paths, so KiCad could not
    tell that board R10 IS schematic R10. gen_board.py now stamps the
    library nickname and the schematic symbol's UUID path; both sides
    derive UUIDs deterministically, so neither has to run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
2026-08-06 Save latest PCB/schematic edits from KiCad; add BOOTSEL switch 3D model
    Hand-routing progress on out/earring.kicad_pcb plus KiCad's resave of the
    schematic and project file. Adds parts/ with the WRL model for the
    KEY-SMD_4P-L4.2-W3.2-P2.20-LS4.6 tactile switch.
2026-08-06 BOOTSEL: swap TS-1101-C-W for SKRPAME010 (C19724063), 4-pin tact
    Smaller part: pads move from (+-3.70, 0) to (+-2.10, +-1.07), body
    4.2x3.2mm vs 6.0x3.3mm. Footprint pulled via easyeda2kicad into
    library/parts.pretty; 3D model is the vendor WRL in parts/ with the
    mm -> 0.1in scale (x0.3937) BAKED INTO ITS VERTICES, so the footprint
    keeps (scale 1 1 1) -- KiCad's scale field has export issues.
    circuit.py: SW1 is now 4 pads, 1-2 = BOOTSEL_SW and 3-4 = GND (per the
    LCSC symbol; confirm against the ALPS drawing before ordering).
    Schematic regenerated. PCB footprint swapped in place via pcbnew,
    keeping position, rotation, reference and the schematic UUID path;
    Sequoia rerouted the CC1/CC2 collis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
2026-08-06 BOM: fix r_10k package mismatch (C25804 is 0603, not 0402); verify all passives
    C25804 = UNI-ROYAL 0603WAF1002T5E, a 0603 part, was sitting on R2/R10's
    0402 land -- this is what JLCPCB's footprint-mismatch warning was about.
    Replaced with C25744 (0402WGF1002TCE, 10k 1% 0402). Board LCSC fields
    resynced to parts.yaml too: the Fabrication Toolkit reads them from the
    board, not from the BOM, so fixing only parts.yaml would have left the
    wrong part in the JLC upload.
    Re-checked every other passive against its LCSC/JLCPCB page -- value,
    tolerance and package all correct, so the remaining "verified: check"
    flags are cleared. Two notes for ordering: C25900 (4.7k) and C26083 (1M)
    showed out of stoc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
2026-08-06 BOM: r_4k7 C25900 -> C105871 (in stock)
    C25900 (UNI-ROYAL 0402WGF4701TCE) is out of stock at LCSC. C105871 is
    YAGEO RC0402FR-074K7L -- same 4.7k 1% 0402, 5.5M in stock, available for
    JLC SMT assembly, and the same YAGEO RC0402 series already used for r_27.
    Board LCSC fields on R14/R15 resynced to match.
2026-08-06 Crystal: swap to Abracon ABM8-272-T3 (C20625731), the RP2350-recommended part
    JLCPCB's notice ("does not use the recommended crystal and polarised
    inductor circuitry") was about the crystal -- the inductor was already
    correct. Was C284155 (Yajingxin, 2520): CL 12pF, max ESR 120R. But C14/C15
    (15p) and R1 (1k) were copied from the RP2350 hardware design guide, which
    derives them for a CL 10pF / ESR<=50R crystal -- 15p/2 + 3p stray = 10.5pF,
    and 1k is sized not to over-drive a <=50R part at 3.3V IOVDD. Against a
    12pF/120R crystal the caps ran it fast and the 1k ate cold-start margin.
    Swapping the crystal (rather than retuning to 18p + a smaller R) makes the
    existing 15p/1k correct again and m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
2026-08-06 place.py/route.py: sync generator to the hand-repacked crystal pocket
    Sequoia repacked the pocket by hand after the ABM8-272-T3 swap and cleared
    all 21 errors. The generator still described the old layout, so a rebuild
    would have regressed it. Coordinates below are MEASURED off the routed
    board, not re-derived.
    place.py:
    Y1 (0,-6.7,180) -> (0,-8.02,180) pushed north for the 3225
    C15 (-4.05,-6.9,90) -> (-2.74,-5.9,180) } one row at y~-5.9 between
    R1 (-2.4,-6.7,270) -> (-0.88,-5.9,0) } the crystal and U1, GND
    C14 (2.4,-6.7,90) -> (1.2881,-5.9329,0)} pads outboard
    C74 (3.6,-6.9,0) -> (4.06,-6.9,0)
    SW1 (0,-11.6) -> (0,-11.2)
    R6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
2026-08-06 Restore exclude_from_bom on TP1-3 (board, not gen_board.py)
    gen_board.py turned out NOT to be at fault: it inherits attributes from the
    library footprint, and a freshly generated board has TP1-3 at attrs=12
    (exclude_from_pos_files + exclude_from_bom), same as
    library/parts.pretty/TestPoint_Pad_1.5x1.5mm.kicad_mod, which has carried
    that flag since the first commit. place.py preserves it too -- verified by
    running gen_board+place in an isolated copy.
    The flag was stripped by the KiCad GUI: the board carried attrs=12 through
    2c14f37 and shows attrs=4 from 6f024ca, the commit that captured
    uncommitted GUI work. So there was nothing to fix in the generator; the
    tracked board was the thing that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
2026-08-06 Datasheet review of every chip: two fatal pinout bugs fixed
    Read each IC's primary datasheet (figures included) rather than trusting
    symbols or prior boards, and diffed the RP2350A against Raspberry Pi's own
    RPI-RP2350A-MINIMAL R4 project in docs/. Full write-up in
    docs/REVIEW-2026-08-06.md.
    Two errors would have killed the board:
    * U6 LSM6DS3TR-C serial pins were rotated by one. ST Table 2 / Figure 1
    (DocID030071 rev 3) give 12=CS, 13=SCL, 14=SDA; circuit.py had
    12=SCL, 13=SDA, 14=CS. As built, CS was driven by the I2C clock (so the
    part re-entered SPI mode on every edge) and SDA -- open-drain -- was
    strapped hard to 3V3, shorting the rail through the IMU's output FET
    whenever i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
2026-08-06 Hand-layout: relocate TP2 beside TP3, nudge TP3/C24, minor track cleanup
    TP2 moves from the far east edge (111.8, 95) into the test-point
    cluster at (88.37, 104.67); C24 re-rotated to 124deg with a small
    nudge; two track segments removed.
2026-08-06 Layout fix pass: 3V3 feed necks healed, pours stitched, corners chamfered
    Applied from the 2026-08-06 review (out/review/fixes.html has diffs):
    - PWR_EN In2 run moved 0.35mm west (GND-via jog preserved): the LDO-to-
    disc neck chain 0.30/0.47/0.67mm is now all >=1.0mm
    - 6 dangling 3V3 vias, the dead 2.9mm In2 GND jumper, and the VBATT
    under-via tail deleted (dangling warnings 7 -> 0)
    - 7 GND stitch vias: top pour crescent 2->4, bottom 1->5, island +1
    (placement gated on F/In1/B pour overlap + VLED-annulus depth)
    - 45-deg chamfers on SWCLK/RUN/XTAL_R/BOOTSEL + the VBATT B.Cu spike
    (signal hard corners 8 -> 3; two gnd_back necks healed as a side effect)
    - XIN 8um micro-jog merged, XTAL_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
2026-08-07 DRC rules: conform to JLCPCB 4-layer capabilities
    Rules audited against JLC's published multilayer limits (Aug 2026):
    - copper-to-edge 0.1 -> 0.2 (the old comment claimed edge pads need
    0.1; nothing on the board is actually closer than 0.2)
    - hole-to-copper 0.15 -> 0.2, hole-to-hole 0.25 -> 0.2 + severity
    warning -> error (it was invisible)
    - silk minimums to JLC spec: text 1.0/0.15, pad-to-silk 0.15
    - solder mask min dam 0 -> 0.1 (check was effectively off)
    - NEW out/earring.kicad_dru: PTH hole-copper 0.28, PTH hole-hole
    0.45, SMD pad-pad 0.15 (JLC's tighter PTH/pad numbers that the
    single global knobs can't express); whitelisted in .gitignore
    Board fixes the tightened rules caught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
2026-08-07 Silk art: curved URL under battery, SHA initials, heart logo
    - Back: github.com/sequoia-hope (top arc) / simple-earring (bottom
    arc) circle the battery center at r7.6mm, per-character stroke
    text, mirrored to read from the back - coin-inscription style,
    hidden under the cell, revealed when it pops out.
    - Front: "SHA" at 17deg at (93.0,95.2); the filled heart from the
    rp2350-motor-controller back silk (its B.Silk zone outline, scaled
    to 3.4mm) at (101.5,105.5) below the MCU.
    - Text 1.0mm/0.15 stroke = the new JLC silk minimums. Spots chosen by
    free-area scan against courtyards/pads/silk; vias underneath are
    tented. Zones repoured.
    DRC: 0 errors / 0 unconnected (3 new silk_overl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
2026-08-07 Silk: move URL arcs south of the battery so they stay visible
    The two arcs were centered under the cell (hidden once inserted).
    Now two concentric arcs on the south rim, outside the battery disc
    (r10): github.com/sequoia-hope at r13.2 (+/-46deg from south),
    simple-earring at r11.8 (+/-31deg) - the clear span between TP2/TP3
    (west, -58deg+) and R11/R12/C21 (east, +55deg+). Read from the back,
    coin-bottom style. Zones repoured; DRC 0 errors / 0 unconnected.
2026-08-07 Silk: URL arcs read in order - github.com/ inner, rest outer
    Inner (upper) arc r11.8 now carries "github.com/", outer r13.2
    carries "sequoia-hope/simple-earring" (26 chars: advance tightened
    0.92 -> 0.88, centered -0.7deg to clear TP3's pad at -53.4deg and
    R12's at +52.0 with ~0.4mm). Zones repoured; DRC 0/0 (4 new
    silk_overlap warnings from the tighter spacing, cosmetic).
2026-08-07 Back-port hand edits: silk art into the generator, VBUS via move
    Board (Sequoia's hand edits, Aug 7): VBUS tip via moved off the B4A9
    tie pad (102.35,86.55)->(102.2,87.01) with In2/B.Cu trunk rework, CC2
    via (102.01,87.02)->(101.59,86.98), a VLED/LED_D38 via+track cleanup
    on the west ring, and five new front texts (Sequoia Hope / Alexander
    / Be Gay / Do Crimes / Love Everyone, 0.8mm) replacing "SHA".
    DRC: 0 errors / 0 unconnected, no dangling.
    Generator:
    - NEW scripts/silk_art.py: heart outline (141 pts, embedded), the two
    back URL arcs, and the five hand texts - called from gen_board.py so
    rebuilds reproduce all silk. Verified: applied to a bare board it
    matches the tracked board's 4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
2026-08-08 ORDERED REV: commit fab exports as sent to JLCPCB
    This is the revision ordered on 2026-08-08. out/production/ (gerber
    zip, BOM, CPL/positions, designators, IPC netlist) is the exact
    export package uploaded for the order, generated 2026-08-07 19:32
    from the board file committed here (verified byte-identical to the
    pre-export backup).
    Board changes since last commit: silk text "Do Crimes" -> "Do Crime"
    and a minor net-8 F.Cu reroute near (91.2, 99.5).
    .gitignore now tracks out/production/ (excluding backups/).
2026-08-24 Battery clip: swap BT1 to MYOUNG MY-2032-12-R (C964834), flat-foot SMD
    Ordered rev shipped the QIJEY CR2032-W footprint without its mandatory
    Ø3.5/3.6 through-holes (feet are bent for reverse-side soldering; holes
    impossible under the front LED ring). The MY-2032-12-R is the flat-foot
    architectural fix: copper kept IDENTICAL to the ordered rev (pads
    10.9..13.9, feet land 10.65..12.05 -> 1.15mm on-pad), BT1 swapped
    surgically on out/earring.kicad_pcb (pads/nets verified, DRC 0 err).
    New BAT_MY2032_12R generator in gen_footprints.py; easyeda2kicad wrl
    (already 0.1-inch units, no scale bake). Rev-2 TODO stays: stretch pads
    inward toward the datasheet land (2.4x6.1 at +-11.35).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
2026-08-25 Bring-up: multimeter probe map page + dashboard banner
    USB bring-up debugging aid served at out/probe/ (renders of the ordered
    rev 43eadc1 with pad-exact probe markers, rail ladder, closeups).
    Generator pipeline in tools/probe_map/. Findings baked into the page:
    no-battery charger motorboat + cold-start sequencing, center-pad tinning.
2026-08-25 Firmware: bring-up smoke test (PlatformIO, arduino-pico)
    generic_rp2350 @ 2MB internal flash, __PICO_RP2350A=1. Rainbow on the
    45-LED chain (GP18, VLED via GP1), IMU on I2C1 (GP6/GP11), charger
    status GP19/GP28, BOOTSEL read, status on USB CDC. NeoPixel vendored
    into lib/ for offline builds. All subsystems verified on the ordered
    board Aug 25.
2026-08-25 Firmware: accel-reactive display, calibrated IMU transform
    Gravity arc (baked per-LED unit vectors from the board file) always
    points at the floor; hue = out-of-plane tilt (face-down red, on-edge
    green, face-up blue); shake brightens and whitens. IMU->board mapping
    calibrated live over USB CDC from two hand-held poses: mirror + 124 deg
    (geometry: 180 - 56 footprint rot; measured 120.6 +-3). Runtime tuning
    commands x/z/o/p kept for future mounts.
2026-08-25 Firmware: fix gravity arc — down is -accel, and make the arc legible
    The accelerometer reads +1g on the axis pointing UP, so the arc was
    seeking the ceiling. Also the arc was a subtle same-hue brightness
    gradient that read as uniform; now a sharp ~+-45deg white arc over the
    tilt-colored ring, base dimmed, global brightness 30 -> 40.
2026-08-25 Firmware: purple light-drip effect, motion-fed
    Droplets spawn on the perimeter loop (34 ring + 3 tip LEDs, baked mm
    positions), slide downhill along the outline toward IMU gravity, pool
    at the bottom-most LED and fade. At rest: a drip every few seconds.
    Step impacts (jolt > 140mg, 320ms refractory) burst 2-4 drops; sustained
    motion raises the trickle rate and mixes in a little white. Decaying
    persistence buffer gives each drip a fading tail. Global brightness 8.
2026-08-25 Firmware: interior octagon as a second drip region
    Generalize drips to region chains: the perimeter stays a closed loop;
    the 8 interior LEDs become an open chain (12.4mm gap at the octagon
    top — drops pool at chain ends instead of teleporting across). Physics
    now runs in real mm using local segment lengths, so drips move at the
    same physical speed despite the interior's 4.2-8.8mm pitch vs the
    perimeter's 2.4mm. 25% of spawns land on the interior.
2026-08-25 Firmware: flash.sh — build + flash from any board state
    Waits for a board (app or BOOTSEL), uploads, confirms the CDC port
    returns. Documents the SW2+BOOTSEL recovery dance.
2026-08-25 Rev 2: ambient light sensor (ALS-PT19-315C) on ADC0
    Everlight ALS-PT19-315C/L177/TR8 (C146233, SMD 1.7x0.8x0.6): visible-
    light phototransistor (peak 630nm, IR-rejecting — in-stock 0603 parts
    all peak 850/940nm and are blind under LED room light). C->3V3,
    E->LIGHT on GPIO26/ADC0 (pin 40), 22k load + 100n filter (RL*CL >=
    0.5 kOhm-uF per ds). Placed FRONT beside the heart silk via courtyard
    grid-scan: Q1 (3.25,6.75) r90, R16 (4.5,7.6) r90, C26 (2.0,8.1);
    2.8mm from the nearest interior LEDs. Footprint + 3D via easyeda2kicad,
    land verified against ds DLS-0000039 rev 8. Note: LCSC listing
    miscategorizes the part as THT D=5mm; datasheet+DigiKey confirm SMD.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
2026-08-25 Fix generator drift vs the ordered board (fresh builds were unroutable)
    A fresh pipeline run of 43eadc1 itself fails static DRC with 6
    violations — the ordered board was built from working-tree state that
    never got back-ported:
    - route.py's 30-segment locked USB_PAIR table was a stale iteration
    whose B.Cu west rail razes through R6/R7's current pads
    (shorting_items -> freerouting cannot rip locked copper and burns
    its full budget; today's rev-2 route timed out twice this way).
    The shipped board locks only five stubs at the connector; freerouting
    owns the rest. Table replaced with that ground truth; four stale
    crossing vias dropped.
    - IMU cluster: shipped board uses rot +-56.0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
2026-08-25 Route: shipped-truth via corridor + straggler assist vias
    Drop the drifted (0.9,5.0)/(-0.35,4.5) pre-route 3V3 vias — absent from
    the shipped board, they squatted on the south-center corridor its QSPI
    and USB_DM/DP transitions used, which is why those nets stranded
    chronically (best seed plateaued at 10 unconnected). Pre-place one
    committed transition via per chronic straggler instead, at the exact
    positions the shipped board's own routes used (USB_DM/DP, all five
    QSPI, IMU_SDA). No LED_EN assist: its shipped spot is 4um foul of the
    re-pitched LED32. Pre-verify: 0 violations.
2026-08-25 Firmware: halve the power draw, rebuild the charge indicator, log wear
    Battery measured ~1h (~40mA avg) on the continuous pattern. Three levers:
    - clk_sys 150 -> 50MHz (board_build.f_cpu). The awake MCU was ~20mA of
    the budget. Verified on hardware: -DF_CPU=50000000L reaches the
    compiler, and USB-CDC, IMU and the NeoPixel PIO (whose divider is
    derived from the live clk_sys) all run clean at 50.
    - The show now plays ~12s episodes separated by naps with VLED cut --
    45 idle SK6805 draw ~13.5mA even showing black. Nap length is tiered
    by activity, calibrated from real wear (below).
    - Lazier pattern: spawn rates halved, slides ~25% slower.
    Activity tiers come from a logged stand/walk/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
2026-08-28 Case: generated TPU clip-on shell — LED diffuser + battery cup
    Two-piece flexible case for the ORDERED board (43eadc1). gen_case.py reads
    that revision straight out of git — outline, all 45 LED positions, every
    courtyard — so the case tracks the hardware, not a transcription of it. The
    working tree is on rev 2, which is not the board that exists.
    Front half is a diffuser: a tapered pocket over every LED, 1.10 mm of TPU
    between the pocket ceiling and a smooth flat outer face. The eight interior
    LEDs sit on bosses that drop their local floor to the ring height so all 45
    pockets are optically identical. BOOTSEL presses through a 0.70 mm membrane
    rather than a hole.
    Rear half is a closed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
2026-08-28 Rev 3: USB-or-switch LDO enable, VBUS presence sense
    Two gaps closed, both about knowing the board is plugged in.
    SW2 no longer drives the LDO enable directly. Its common becomes SW_ON,
    and D2 (BAT54SW, dual SERIES Schottky) ORs two sources into PWR_EN:
    diode 1 passes SW_ON, so the switch still enables the board; diode 2
    clamps EN to VBATT + Vf. The clamp is mandatory, not belt-and-braces --
    the NCP730's abs-max V_EN is (V_IN + 0.3), not an independent rating, so
    a bare feed from 5V VBUS would violate it essentially always. R18 feeds
    VBUS in through 100k against R17's 100k pulldown, putting EN near
    VBUS/2 with USB in. 100k rather than the 1M used elsewhere because EN
    has an internal pull-up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
2026-08-28 Firmware: blink the charge arc, and wait for C21 before believing the ADC
    The assembling-arc indicator is gone. It dithered spatially -- every
    50ms a random fraction of the dark arc LEDs snapped on -- to hold one
    solid colour at counts too small to fade through. On hardware it banded
    and shimmered rather than reading as a fill, and at this size the effect
    was never legible anyway. The arc now simply blinks: on at CHG_LEVEL for
    one second, off for four. That also drops the average LED load to a
    fifth, leaving more of the ~41mA charge budget for the cell (the 45 idle
    SK6805 draw ~13.5mA even showing black, so the dark beat is real
    savings). CHG_PEAK becomes CHG_LEVEL and stays at 3: orange is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
2026-08-28 Tools: charge monitor, R8 rework diagrams, host USB controller reset
    Three bench tools that were living untracked.
    tools/charge_monitor.py plots live VBATT against the two lines that
    decide whether the board works: 3.70V, the SK6805-EC10 minimum VDD
    (VLED is VBATT through the TPS22913, so below it the ring cannot light
    at all, no firmware change helps), and 4.20V full. It autoconnects to
    whichever port the RP2350 enumerates on and reports rate and ETA,
    because with no power path -- the NCP730's IN and the LGS4056H's BAT are
    the same VBATT node -- the ~41mA program current is shared with the
    running MCU and the climb is slow enough that "is it even gaining?" is a
    real question. Strictly read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
2026-08-28 Case: flush LED pockets, six chonky clip tabs (three a side)
    Diffuser floor loses the eight per-LED bosses over the inner ring; every
    LED is now the same flush conical pocket (over the raised mid floor the
    cone just emerges shallower, same ceiling everywhere).
    Rim goes from ten 4 mm stations (incl. the two tip hooks) to six chonky
    tabs, three a side: left flank slice / 240 / 0 for the front, 195 / 300 /
    right shoulder (wrapping the tangency, s-wrap handled) for the rear.
    Stations can override lip depth: the 0-degree front tab runs 0.65 mm so
    it clears the BT1 clip-arm courtyard corners at every probe depth. All
    station margins positive, halves stay single valid solids, plug corridor
    clear;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
2026-08-31 Rev 2 power path: split VBATT from VSYS so USB runs the board
    Rev 1 hung the LDO input and the LED load switch on VBATT -- the same
    node as the charger's BAT pin -- so the LGS4056H's ~41mA program current
    was SHARED with the running system. 17mA of MCU plus 17.5mA of LED rail
    left the cell about 6mA, and a flat cell could never climb to the
    SK6805-EC10's 3.7V minimum VDD before someone unplugged it. That is the
    "no lights at all" failure from Aug 27, and it is a power-path problem,
    not a firmware one.
    VBUS --|>|-- VSYS D3, B5819WS Schottky, ~0.3V at our ~60mA
    VBATT --[Q2]-- VSYS CJ2101 P-FET, on only when no cable is in
    VSYS -> U3 (LDO IN), U4 (LED load switch IN), C18, C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
2026-08-31 Dashboard: reverse-chronological update feed over the live outputs
    The page had become a pile of undated banners. Two of them (the R8 rework,
    the board-alive note) were stacked at the top with no way to tell which
    superseded which, the TPU case had grown a section of its own between the
    renders and the schematic, and everything older than a week -- the order,
    the two fatal pinout bugs, the layout fix pass -- existed only as a nav
    link to a sub-page or not at all. The board has been through three
    revisions and two bench debug campaigns, and the useful question opening
    :8618 is almost always "what changed since I last looked", not "what does
    the current PNG show".
    So the page is now a feed. N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
2026-08-31 Route: cut LED_D3's locked hop to one segment — the rest hung freerouting
    First full route since rev 3 added its two locked pre-routes, and it never
    reached pass 1. Silent, 100% CPU, nothing in freerouting's own log after
    the settings dump, both 900s tries burned, no SES, twice.
    The static gate was clean -- kicad-cli DRC with the .kicad_pro beside the
    board reports 0 errors on the pre-freerouting statics -- so this was not
    the known locked-wire-clearance burn.
    Bisected on the DSN with -mp 2 probes (~90s each, run concurrently with
    per-probe -Djava.io.tmpdir so each gets its own log; verdict is whether
    "Pass #" ever appears):
    full hop HANG only CHRG_DONE dropped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
2026-08-31 Dashboard: feed entry for the freerouting hang
    Records the bisect table and the "single hints work, locked paths poison"
    rule while it is fresh, including the correction that my previous note on
    this hang mode -- "fixed wires that start on a component pad" -- was
    wrong, and the two counterexamples that disprove it.
2026-08-31 Rev 2 routed: 5 unconnected, 0 DRC errors
    First routed board carrying the rev-2 power path. 1371 tracks, 258 vias,
    117 warnings (60 silk-over-copper, 40 silk overlap, 6 dangling vias, the
    usual crop) and zero errors. NOT orderable -- five nets are still open, so
    the fab export was deliberately skipped.
    Open:
    VBUS_SENSE U1.41 -> R19.2 8.2mm cross-board
    LIGHT U1.40 -> Q1.2 7.3mm cross-board
    VBUS x2: the tip trunk (the 3 segs route.py reported blocked by
    routed copper) and the short branch to the new R19
    3V3 a 1.6mm stub at the MCU
    The two long ones share a cause. Both leave the MCU's jammed west pin
    window -- pins 40 and 41, at radius 3.45 and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
2026-09-01 Docs: bring the plan of record and the dashboard up to rev 2
    PLAN.md had been stuck at 2026-08-05 ("4-LAYER PARTIAL, hand-routing in
    progress") with a contradictory 6-layer header above it, and README.md
    still named RP2354A, TBA-C1010 LEDs and a LIR2032 -- all three swapped
    out weeks ago. Neither mentioned that two boards now exist.
    PLAN.md is rewritten around that split: rev 1 is the ordered/assembled
    board in the ~/pcb/simple_earring_shipped worktree, rev 2 is this tree at
    bdc87fc -- 138 parts / 87 nets, 0 DRC errors, 5 unconnected, fab export
    deliberately skipped. It now carries the rev-2 power path, the five open
    nets and why the two long ones are hard (pins 40/41 originate inside the
    d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
2026-09-19 Firmware: charge indicator — min-3 linear arc, red→green gradient, acquire/hold/10-1 rhythm
    Ring shows charge as a linear arc (3 LEDs minimum, all 37 at full) in a
    continuous red→orange→green gradient. Rhythm: blink a blue stub until six
    VBATT samples agree (or 6s), hold the level 10s, then 10s dark / 1s lit
    while charging. Switch OFF now suppresses the indication entirely so the
    board charges dark. IR correction cut from 150mV to 30mV for the
    RJD2032C1.
2026-09-19 Firmware: wait 50ms for VLED before a latched frame, and send it twice
    The level indicator was dark on the bench: railOn gave the TPS22913 and
    the SK6805 chain only 3ms before the single latched frame, which was
    lost. The drip show never showed it because it streams at 50Hz. A 50ms
    settle plus a double send fixes it. Adds the S serial command (hold the
    arc 5s) and an 'arc lit' log line for bench checks.
2026-10-22 Rev 2 coin-cell close-out: name the clip not the cell, BS-6 socket fit test
    BT1's value is now the clip's MPN (MY-2032-12-R) so the BOM Comment agrees
    with its LCSC column; design.yaml's power.battery is the one place the
    hand-fitted RJD2032C1 cell is named. Adds the C22363833 (CR2032-BS-6) fit
    study (scripts/gen_bs6_svg.py + dashboard entry): its land runs 1.19mm off
    the board, and the only land-legal rotations put the body on J1.
    Last commit of the coin-cell power source before the LiPo change.
2026-10-22 LiPo power source: LPR302823 on wire pads, B3U soft-latch power button
    Replaces the RJD2032C1 coin cell + MY-2032-12-R clip with a LiPol
    LPR302823 round pouch (Ø28 D-cut, 140 mAh) taped to the back and wired to
    two pre-tinned pads beside J1. Placed and DRC-clean (0 errors), NOT routed:
    routing is deferred to a new autorouter.
    - BT1 -> BAT_LPR302823_PADS (no LCSC part). Pads sit >=0.6 mm from all
    other copper, and route.py keeps vias >=0.6 mm off them.
    - R8 22k -> 18k (50 mA; cell max 70 mA). CV stays 4.20 V because the cell's
    PCM can trip as low as 4.305 V.
    - SW2 slide switch -> Omron B3U-3000P side-push on the left tip edge, plus
    a CPU-held soft latch (Q4 CJ2101, Q5 BSS138W, D4 BAV7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
2026-10-24 Draw the 3D board only when the view changes
    The viewer rendered every frame forever, even idle or scrolled out of
    sight, which kept the compositor busy and made the whole page scroll
    slowly (badly so in WebKitGTK). Now a frame is drawn when the controls
    move (including while they ease out), a model loads, or the window
    resizes, and nothing runs while the viewer is off screen.
2026-10-24 3D models for every part; ngspice power-button testbench finds a hot self-start
    3D models: SW2 (stock B3U-3000P STEP), U1/U2/U3/L1/C_0402_small_pads
    repointed at existing stock models (U1 is a 7x7 QFN-56 stand-in), and two
    generated STEPs (scripts/gen_3d_models.py): U4 DSBGA-4 and the LPR302823
    cell on its 1.5 mm VHB disc. Only model blocks changed in earring.kicad_pcb;
    DRC still 0 errors.
    design/sim/button: ngspice testbench whose netlist is generated from
    circuit.py. Models are datasheet-fitted, with typ/cold/hot corners and a
    behavioral RP2350. Findings, confirmed by an independent fresh-context
    review:
    - BLOCKER, committed design: with the board off, D2b (BAT54) and D3
    (B5819WS) rever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
2026-10-25 One-button BOOTSEL, silicon D2/D3, button TVS, high-Vth latch FET
    Folds the power-button simulation's findings into the board (user decisions
    2026-10-24), each re-simulated, independently reviewed and re-reviewed.
    - SW1 deleted. A long hold on the power button resets the chip into BOOTSEL
    (Q8/R26/R27, R28 680k + C75 timer, D5, U8 74LVC2G14GW, Q7 strap, C76/R29 ->
    Q6 RUN kick, C77). Fires 2.2-10.3 s typical, 2.0-19.4 s at U8's leakage
    limit. On battery the same hold turns the board off on release, which is
    the hardware force-off for hung firmware. Flash is never touched.
    - Hot self-start fixed: D2 BAT54SW -> BAV99W, D3 B5819WS -> 1N4007WS. Board-off
    EN is now <= 0.03 V at 85 C (afa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
2026-10-25 LED ring: WS2816C-1313 (16-bit) in three switched zones; lock policy
    User decisions 2026-10-24: switch the ring to WS2816C-1313/4P and split it
    into left / right / centre zones. Independently reviewed (gates 1, 2, 6 pass).
    - LEDs: SK6805-EC10 -> WS2816C-1313/4P (C42417612). 16-bit per channel plus
    gamma for the low-brightness range; VDD floor 3.3 V; idle 0.7-1.0 mA per LED;
    rated to 65 C; MSL 5a. New LED_WS2816C-1313 footprint (EasyEDA land, pin map
    checked against the datasheet: 1 VDD, 2 DO, 3 GND, 4 DI).
    - Three zones, each its own chain, TPS22913 load switch (U4/U9/U10) and
    open-drain shifter pulled up to its own rail (Q3/Q9/Q10 + R23/R31/R32), so a
    dark zone draws nothing and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
2026-10-25 Move 19 parts to the back to clear the area around the CPU
    Flash U7/C25/R3, charger U2/C16/C17/R8, LDO U3/C18/C19, power path
    D3/C29/R21/R22, VBUS tap R19/R20 and LED_L switch U4/C20/R10 now sit on
    the back under the cell. All are <= 1.1 mm (datasheet max), the under-cell
    cap for the 1.5 mm foam tape. Front courtyard area within r < 10 mm drops
    from 107 to 57 mm^2; the back under U1 stays clear for escape vias.
    route.py drops the freerouting assists anchored to the old front spots
    (QSPI, CHRG/CHRG_DONE + U2 landing loop, LED_EN_L, U3 3V3 via); U2 is no
    longer locked. gen_lipo_fit_svg.py gains heights for the new packages and
    now fails instead of treating an unknown height as 0 mm.
    DRC 0 er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
2026-10-28 Route with ultraroute; widen the LED supply tracks to 0.3 mm
    The board is now routed by ultraroute (lab vled-width-1, seed 0) instead
    of the freerouting-era route.
    - VLED_L/C/R get their own "vled" net class: 0.3 mm tracks, with a
    .kicad_dru rule that allows narrowing to no less than 0.2 mm at the
    LED pads. They were on the 0.15 mm default. The In2 pours are cut
    into pieces joined by tracks, so ring current runs on tracks too.
    - Routed with --planes In1.Cu (In1 stays a solid GND plane, one piece)
    and --pour-cost 3 (signals avoid cutting In2's VLED and 3V3 pours).
    - route.py drops the freerouting assist vias and stubs that dangled once
    their unlocked tracks were stripped; R14's 3V3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
2026-10-28 route.py: drop the two 3V3 access vias ultraroute leaves unused
    (-5.85,-1.60) and (-4.25,-7.55) were placed to give freerouting cheap
    3V3 access. ultraroute's own fanout reaches the In2 disc without them,
    so on the 7a83b33 route they touched In2 only and KiCad flagged them
    dangling; they were deleted from that board by hand. route.py now
    matches it: its 33 locked pre-route items are exactly the locked copper
    on the committed board. (6.2,2.6) stays, the route uses it.
    earring.kicad_pro: net classes in KiCad's own (alphabetical) order, so a
    pcbnew save no longer reorders them.
2026-10-30 Move into the Boardroom project layout
    KiCad project to hw/earring/a/ (where Boardroom, Circuit Composer and
    UltraRoute Studio find boards); build products stay in out/. scripts/paths.py
    owns the locations; KIPRJMOD-relative library and 3D paths climb three levels.
    Adds design/status.json (schema 1), CLAUDE.md, the vendored pcb-design skill,
    pcbview.toml, compose/earring/ (generated by export_compose.py, new build
    stage) and route/earring/recipe.json for the installed ultraroute route.
    DRC on the moved board: 0 errors / 0 unconnected / 0 parity; footprint
    regeneration is byte-identical; GLB export resolves the same 3D models.
2026-10-30 Route with ultraroute in the build, not freerouting
    route.py lays the locked pre-routes and pours as before, then groups the
    RP2350 power pours + U1 into the rp2350_power block and runs the pinned
    vendor/ultraroute (scripts/route.sh, Boardroom's) with the args in
    route/earring/recipe.json, refills, and saves. The DSN/SES path, the
    freerouting-only LED-chain beautifier and build.py's route/finish retry
    loop are gone; finish.py stays runnable with --only finish.
2026-10-30 gen_board: keep the tracked .kicad_pro instead of KiCad's defaults
    Saving a NewBoard rewrote earring.kicad_pro with default rules (0.5 mm via,
    0.25 hole clearance), so every full build left ~1200 bogus DRC errors and,
    now that the build routes with ultraroute, routed against the wrong rules.
2026-10-30 route.py: refill ultraroute's output in place, so the .kicad_pro keeps its rules
2026-11-02 Re-route on ultraroute 0b9016f with the gate 7 fixes
    VBATT joins the power class (0.2 mm floor in the .kicad_dru); DRC checks
    copper connection width >= 0.09 mm as an error; XIN/XOUT/XTAL_R are
    locked F.Cu pre-routes; the In4 rule area is gone. The route has 0
    unconnected and VBATT at 98 mOhm with no necks, but gate 7 still fails on
    three router track-to-pad joints on 3V3 (ultraroute request #2).
2026-11-02 Re-route on ultraroute 5064384: DRC 0/0 with joint-width check
    ultraroute's track-to-pad fix (our request #2) clears the 3V3 pad
    necks. The final pour refill uses a 0.2 mm minimum width on the large
    planes, which clears two KiCad fill slivers; routing still runs over
    0.15 mm fills, since 0.2 mm fills gave a worse route.
2026-11-02 No via holes in SMD pads: DRC rule, route.py vias moved off pads, re-route
    124 via holes in SMD pads -> 0; 0 unconnected. DRC has 4 errors left:
    three from the router (a via 0.5 um short of the hole rule; a same-net
    VLED_C via pair whose lands touch, reported on B.Cu and In1.Cu), sent
    to ultraroute as request #3; and a gnd_front pour sliver.
2026-11-02 ultraroute requests: #3 fixed upstream, #4 fe903ff regression on this board (staying on 5064384)
2026-11-02 route.py: seed KiCad UUIDs so the router's input is byte-identical run to run
2026-11-02 Re-route on ultraroute 99bb7ca, seed 1: 0 unconnected, 0 vias in pads, DRC 1 (gnd_front sliver)
2026-11-02 No-pour area at CC1/VBUS: DRC 0/0; gate 7 review fails on VDD_CORE topology (MAJOR-A)
    The last DRC error was a 0.077 mm gnd_front strip between R4.1 and the
    locked VBUS via. KiCad reported it at the zone's origin; pinch.py finds
    the real spot. route.py adds the rule area after routing, so the route
    is unchanged (identical to 98f7884).
2026-11-03 Gate 7 passes: parts off the silk art, VDD_CORE per the official layout, pcbview dashboard
    - D2/R17/Q2 off the back URL; URL letters spaced by glyph width.
    - The maker's name moved west of U1 at 60 deg (user's call): every spot
    for Q3/R23 clear of it broke U1's routing.
    - VDD_CORE: locked lobe via + 0.6 mm B.Cu to the under-chip square,
    C6/C13 via + B.Cu, FB leg into the pour, C5 turned to face pin 39.
    - scan_spot.py --art: the board's silk art is a placement obstacle.
    - Recipe seed 2 (sweep on the route stage's input): DRC 0/0, parity 28.
    - Dashboard embeds pcbview (vendor/pcbview 4e9dfa2, scripts/view.sh),
    with 3D stand-ins; BT1's LiPo shows in 3D.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
2026-11-03 Dashboard: board viewer at the top, status and updates below it
2026-11-03 Bump pcbview: 3D popping, framing and zoom fixes
2026-11-03 Variant B study: matrix-driven RGB LEDs (IS31FL3741A), fit, cost, battery life
2026-11-03 Variant B plumbing: --variant/EARRING_VARIANT, design.b.yaml overlay, IS31FL3741A matrix circuit and schematic
    Variant A's netlist and schematic are byte-identical. RISET, bulk and
    I2C pull-up values are placeholders until the phase 1 audit.
2026-11-03 Variant B: phase 1 audits (IS31FL3741A, XL-1010RGB), footprints, RISET 47k, back placement
    The driver sits back-west at rot 270. The soft latch moves east and
    D2/R17 south, all scanned clear of U1's back escape keepout and the
    art. In2 has no VLED planes in B. Variant A's pre-route is unchanged
    (259 unconnected, VLED planes intact).
2026-11-06 Variant C: AW20198QNR driver + XL-1615 LEDs from round-pendant's low-density boards
    Variant B with the parallelogram family's driver (AW20198QNR, QFN-40 5x5,
    1.8 mA quiescent, ~$2.4 cheaper) and the 1.6 x 1.5 mm XL-1615RGBC-RF
    (anode on pad 2). Same 9 SW x 15 CS map, REXT 47k (8.51 mA peak).
    circuit.py and gen_schematic.py key driver and LED pin maps by part;
    B and A outputs are unchanged. Footprints from the datasheet land
    patterns. LEDs square to the ring tangent; the four beside J1's legs
    snap to 90 deg. Driver back-west, support parts scanned in signal order.
    Placed-board DRC 0 errors; schematic netlist 77/77. Phase 1 independent
    review: PASS WITH FIXES, fixes folded in (bulk cap m4 open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
2026-11-06 Variant D: AW20198 moved to the only LED-free back pocket; 4-layer sweeps (41-50 open, 28-37 with a 0.1 mm matrix class)
2026-11-06 Variants E/F: back unloaded off the LEDs + 0.1 mm rules (4L: 15-19 open); F on 6 layers routes 0 open on every seed
2026-11-06 Dashboard: round-pendant-style design gallery of variants A-F and the best E/F routes
    render.py builds a hero, per-family variant cards (layer-plot thumbnails with a
    Front/Back toggle), a comparison table and design-notes pages (out/docs/) from
    design/variants.toml + pcbview.toml. pcbview.toml gains variant B and the two
    best routed trials (route/earring-{e,f}/best, project_dir to the variant).
    status.json: E's 45-minute result and the open 4L/6L decision.
2026-11-07 README: current opening (rev 3, LiPo, WS2816C zones, matrix study); publish the wear log on Pages
2026-11-09 Remove personal paths and hostnames from code and docs
    gen_probe.py writes to <repo>/out/probe instead of an absolute path.
